BZKDP/dozator-bad/gate12_5servo_direct_esp32/ПЕРВЫЙ_ЗАПУСК_НОВОЙ_СБОРКИ.md

# Дозатор БАДов — первый запуск пяти каналов

## Сигнальные пины ESP32

| Строка | Пин на плате | GPIO | Провод сервы |
|---|---|---:|---|
| Дозатор 1 | D13 | 13 | оранжевый / SIGNAL |
| Дозатор 2 | D14 | 14 | оранжевый / SIGNAL |
| Дозатор 3 | D27 | 27 | оранжевый / SIGNAL |
| Дозатор 4 | D26 | 26 | оранжевый / SIGNAL |
| Дозатор 5 | D25 | 25 | оранжевый / SIGNAL |

D12 пропущен намеренно: это загрузочный пин ESP32.

Красные провода всех серв идут только на `+5 V` понижайки. Коричневые/чёрные
провода идут на общую минусовую WAGO. Между этой минусовой WAGO и `GND` ESP32
обязательно должен оставаться один общий провод. Питание серв нельзя брать с
`3V3`, `VIN` или `5V` ESP32.

## Безопасная последовательность

1. Пока питание серв выключено, подключить пять сигнальных проводов и общую землю.
2. Подключить ESP32 к USB и прошить `gate12_direct5_safe.ino`.
3. Запустить ярлык `Дозатор 5 каналов`.
4. Убедиться, что видны пять строк и у каждой написано `НУЖНА КАЛИБРОВКА`.
5. Включить 5 V серв.
6. В нужной строке нажать `НАСТРОЙКА / КАЛИБРОВКА`.
7. Центрировать серву только со снятой качалкой, затем поставить качалку в HOME.
8. Удержанием кнопок найти HOME и ВЫДАЧУ, запомнить обе точки и проверить цикл
   сначала без банки. Повторить отдельно для остальных строк.

При открытии калибровки выбранного канала приложение снимает сигнал со всех пяти
серв. После каждого движения прошивка автоматически отключает PWM; при зависании
действует сторожевой таймер.
