BZKDP/dozator-bad/gate12_5servo_pca9685/ПОДКЛЮЧЕНИЕ_И_ПОКУПКИ.md

# Дозатор на 5 сервоприводов: ESP32 + PCA9685

Это новая пятиканальная версия прежней схемы. Старая схема сохранена без изменений в соседней папке `gate12_safe_control`: она была рассчитана только на один MG90S, один GPIO и маломощный LM2596.

Новая схема рассчитана на пять обычных трёхпроводных сервоприводов 4,8–6 В (например, SG90/MG90S), постоянно подключённых к одному контроллеру. Компьютер видит ESP32 как COM-порт; ESP32 по I²C управляет отдельным драйвером PCA9685; отдельный блок 5 В питает только сервоприводы.

## Как понимается механика

- **HOME / исходное положение:** длинная крайняя рука полностью опущена и удерживает банку, готовую к выдаче.
- **Ход выдачи:** длинная рука поднимается и выпускает крайнюю банку; связанная с ней изогнутая рука одновременно удерживает следующую банку.
- **Возврат:** длинная рука снова опускается в HOME; следующая банка занимает место для будущей выдачи.

Программа не предполагает, что подъём обязательно соответствует увеличению числа микросекунд. В зависимости от установки качалки он может идти как в сторону `+`, так и в сторону `−`; это определяется отдельно на каждом дозаторе.

## Что купить

Обязательное:

- 1 × ESP32 DevKit V1 / ESP32-WROOM-32.
- 1 × USB-кабель с передачей данных, подходящий к выбранной ESP32.
- 1 × плата PCA9685, 16 каналов, с уже припаянными трёхрядными штырями и винтовой клеммой V+/GND.
- 1 × стабилизированный блок питания **5 В, 5 А (25 Вт)**. Не 12 В. Лучше готовый закрытый сетевой адаптер, а не открытый сетевой модуль.
- 1 × переходник «гнездо DC 5,5×2,1 мм → винтовая клемма», если у блока питания круглый штекер.
- 1 × электролитический конденсатор **1000–2200 мкФ, не ниже 10 В**.
- 4 × провода Dupont «мама–мама» для ESP32 ↔ PCA9685.
- Два коротких силовых провода 0,5–0,75 мм² для 5 В и GND, если они не входят в переходник.

Желательно:

- держатель предохранителя и предохранитель 5 А в плюсовом проводе 5 В;
- выключатель постоянного тока в плюсовом проводе после предохранителя;
- мультиметр для проверки напряжения и полярности до подключения серв.

Если на сервоприводе написано не SG90/MG90S или не указано питание 4,8–6 В, сначала сфотографируй маркировку. Для MG996R и других крупных серв блок питания выбирается отдельно.

## Соединения

| Откуда | Куда | Назначение |
|---|---|---|
| Компьютер USB | USB ESP32 | питание контроллера и COM-порт |
| ESP32 `3V3` | PCA9685 `VCC` | питание только логики PCA9685 |
| ESP32 `GND` | PCA9685 `GND` | общая земля |
| ESP32 `GPIO21` | PCA9685 `SDA` | данные I²C |
| ESP32 `GPIO22` | PCA9685 `SCL` | тактирование I²C |
| Блок 5 В `+` | предохранитель/выключатель → PCA9685 `V+` | силовое питание серв |
| Блок 5 В `−` | PCA9685 `GND` на винтовой клемме | возврат силового питания |
| Конденсатор `+` | PCA9685 `V+` | подавление бросков тока |
| Конденсатор `−` (полоса на корпусе) | PCA9685 `GND` | соблюдать полярность |
| Серва дозатора 1…5 | каналы PCA9685 `0…4` | коричневый/чёрный = GND, красный = V+, жёлтый/оранжевый/белый = PWM |

На большинстве PCA9685 у трёхрядных разъёмов подписано `GND / V+ / PWM` или `- / + / S`. Ориентируйся по надписям именно на своей плате, а не только по положению разъёма на картинке.

## Чего не соединять

- Не подавать 12 В ни на PCA9685 V+, ни на сервы, ни на ESP32.
- Не соединять внешний `+5 В` с `5V/VIN` ESP32, пока ESP32 подключена к USB. Между системами нужна общая **земля**, а не второй плюс питания ESP32.
- Не питать пять серв от вывода `5V`, `VIN` или `3V3` ESP32.
- Не пропускать ток пяти серв через макетную плату или тонкие Dupont-провода. Dupont используются только для четырёх логических соединений.
- Не путать `VCC` и `V+` на PCA9685: `VCC` — 3,3 В логики, `V+` — 5 В серв.

## Первый запуск без риска

1. Пока **не вставлять** разъёмы серв в PCA9685.
2. Собрать четыре логических провода ESP32 ↔ PCA9685.
3. При выключенном блоке подключить его к винтовой клемме PCA9685 и поставить конденсатор, строго соблюдая `+` и `−`.
4. Включить только блок 5 В и мультиметром проверить на клемме PCA9685 примерно 5,0 В и правильную полярность. Выключить блок.
5. Подключить к каналу `0` только первую серву. Банок в механизме быть не должно.
6. Подключить ESP32 к компьютеру, загрузить прошивку и только после этого включить блок серв.
7. Безопасно привязать положение сервопривода к механике по инструкции ниже. Затем по одной добавить сервы в каналы `1`, `2`, `3`, `4`.

Прошивка специально ничего не двигает при включении. Начальные программные пределы — только 1450–1550 мкс; это маленькое безопасное окно вокруг середины. HOME и «выдача» по умолчанию одинаковы — 1500 мкс, поэтому цикл выдачи заблокирован до калибровки.

## Обязательная привязка сервы к уже собранной механике

Трёхпроводная серва не сообщает ESP32 свой фактический угол. Если рука вручную стоит внизу, контроллер всё равно не знает, какой импульс соответствует этому углу. Поэтому нельзя наугад дать 1500 мкс сервоприводу, уже жёстко упёртому механизмом вниз.

Для каждого дозатора по очереди:

1. Убрать банки и выключить питание 5 В.
2. Снять качалку сервы со шлицов либо временно отсоединить тягу, чтобы вал мог повернуться, не двигая руки механизма. Остальную конструкцию разбирать не нужно.
3. Оставить подключённой только эту серву, включить систему и в программе задать HOME = 1500 мкс, затем нажать `В HOME`. Вал безопасно встанет в электрический центр без нагрузки.
4. Выключить питание 5 В. Поставить длинную руку в нижнее HOME-положение **с небольшим запасом до жёсткого упора**, надеть качалку на ближайший шлиц и закрепить тягу.
5. Включить питание. Кнопкой `+20 мкс` сделать один короткий шаг. Если длинная рука начала подниматься — рабочее направление найдено. Если она пытается давить дальше вниз, сразу нажать `СТОП`, вернуть центр и проверить `−20 мкс`.
6. Двигаться в найденную сторону маленькими шагами по 20 мкс, пока длинная рука не поднимется достаточно для выхода одной банки, а изогнутая надёжно не перекроет следующую. Не доводить серву до гудения или механического упора.
7. Записать 1500 мкс как HOME и найденное значение как «Выдача». Если точное HOME потребует небольшой коррекции, менять его шагами и оставить запас от нижнего упора.
8. Только после проверки пустого механизма провести один цикл с одной банкой, затем с двумя. После этого переходить к следующей дорожке.

Если снять качалку или тягу невозможно, первый электрический запуск с жёстко присоединённым механизмом остаётся рискованным: направление и текущий угол сервы неизвестны. В таком случае лучше сначала прислать крупное фото соединения сервы с рукой и маркировки сервы.

## Прошивка ESP32

Файл: `gate12_5servo_pca9685_safe/gate12_5servo_pca9685_safe.ino`.

В Arduino IDE установить:

1. пакет плат `esp32 by Espressif Systems`;
2. библиотеку `Adafruit PWM Servo Driver Library`;
3. выбрать плату `ESP32 Dev Module`, COM-порт ESP32 и нажать Upload.

Здесь прошивка уже проверена сборкой для `esp32:esp32:esp32` с библиотекой PCA9685 версии 3.0.3.

Если удобнее прошивать одной командой, подключить ESP32 и запустить `flash_esp32.ps1`; скрипт попросит номер COM-порта.

## Программа на компьютере

После прошивки:

1. открыть PowerShell в этой папке;
2. один раз выполнить `py -m pip install -r requirements.txt`;
3. запустить `start_app.ps1` или `py gate12_5servo_app.py`;
4. выбрать COM-порт и подключиться.

Нумерация в программе человеческая — дорожки 1…5. В прошивке и на PCA9685 это каналы 0…4 соответственно.

До калибровки не расширять пределы и не запускать все пять механизмов сразу. После калибровки приложение хранит для каждой дорожки отдельные пределы, положения HOME, «выдача» и скорость. Кнопка `СТОП` снимает управляющий сигнал сразу со всех пяти каналов.

## Справочные материалы производителей

- Espressif, ESP32-DevKitC: https://docs.espressif.com/projects/esp-dev-kits/en/latest/esp32/esp32-devkitc/user_guide.html
- Adafruit, подключение PCA9685 и отдельное питание серв: https://learn.adafruit.com/16-channel-pwm-servo-driver/hooking-it-up
- Adafruit, назначение VCC/V+/SDA/SCL: https://learn.adafruit.com/16-channel-pwm-servo-driver/pinouts
- Библиотека Adafruit PWM Servo Driver: https://github.com/adafruit/Adafruit-PWM-Servo-Driver-Library
- TowerPro MG90S: https://towerpro.com.tw/product/mg90s-3/
