BZKDP/dozator-bad/ЧЕРТЁЖ-и-сборка.md

# Дозатор БАД — гравитационный конвейер с серво-шлагбаумами

3D-референс открывается в `index.html` (просто двойной клик — нужен интернет для загрузки three.js).
Здесь — точные размеры, раскрой картона, схема механизма, электроника и прошивка.

---

## 0. Что это и как работает

Это **escapement-механизм** (как в торговых автоматах / диспенсерах Red Bull).
Каждая позиция БАД = **вертикальный магазин**: банки лежат на боку и сложены столбиком
друг на друга. Под силой тяжести столб давит вниз. У низа столба стоят **два серво-шлагбаума
(трап-дверки)** в противофазе — они изолируют и роняют **ровно одну банку за цикл**.

Упавшая банка выходит на **СВОЮ отдельную дорожку** (наклонный лоток). Дорожки всех позиций
идут по отдельности и **сливаются в одну общую магистраль только в самом конце** — там, где
сидит фасовщик.

### Цикл выдачи одной банки (вертикальный магазин)
```
Покой:  G1 закрыт (трап-дверка снизу держит нижнюю банку)
        G2 закрыт (на 1 банку выше, держит весь столб; между G1 и G2 — РОВНО одна банка)

1. G1 открыть (откинуть дверку) → нижняя банка падает на свою дорожку
2. G1 закрыть
3. G2 открыть → столб опускается на один шаг, новая нижняя банка ложится на G1
4. G2 закрыть → снова изолирована одна банка
→ покой
```
Заказ «2 берберина» = цикл повторяется 2 раза на магазине «Берберин».
Заказы по позициям идут последовательно (или параллельно — серво независимы).

---

## 1. Базовая банка (эталон)

| Параметр | Значение |
|---|---|
| Высота (длинная сторона) | **67 мм** |
| Диаметр (дно/крышка) | **47 мм** |
| Ориентация | лежит на боку; ось (длина 67) поперёк дорожки; падает/катится диаметром 47 |

> Если банки другого размера — поменяй два числа `JAR_D` (диаметр) и `JAR_H` (высота)
> в начале `index.html`, остальное пересчитается само (W, DEPTH, шаг, зазоры).

**Зазоры:**
- ширина магазина/дорожки (вдоль оси банки): 67 + 6 = **W = 73 мм**
- глубина магазина (диаметр + зазор): 47 + 6 = **DEPTH = 53 мм**
- шаг банок в столбе (pitch) = 47 + 2 = **49 мм**

---

## 2. Углы и ориентация

| Узел | Угол | Зачем |
|---|---|---|
| Магазин хранения | **вертикальный (90°)** | банки лежат на боку столбиком, падают вниз самотёком |
| Дорожка позиции | **15–18° от горизонта** | банка скатывается к фасовщику, но не разгоняется |
| Финальное слияние | **10–12°** | плавный докат в общий лоток |

Дорожка менее 12° — банка может застрять (особенно с этикеткой). Более 25° — разгон и удары.

---

## 3. Геометрия escapement (САМОЕ ВАЖНОЕ)

Низ вертикального магазина. Две трап-дверки (шлагбаума) поперёк столба, по высоте между ними
= **один диаметр банки = 47 мм** (по центрам).

```
     вертикальный магазин (банки лёжа, столбиком), вид сбоку
        ┌───────────┐
        │   ● банка  │   ← загрузка сверху
        │   ● банка  │   ← передняя стенка держит столб
        │   ● банка  │
        │   ● банка  │
        └──┐      ┌──┘   ← низ колонны, банка падает на гориз. участок
           │  ▲   ▲      ← ДВЕ ПОДЪЁМНЫЕ ЗАСЛОНКИ, обе ходят ВВЕРХ
        ───┤  G2  G1 ├──────►  к фасовщику
           │  ●(одна банка между ними)
   нижний горизонтальный лоток    |← 47 мм →|  (шаг G1↔G2 = 1 диаметр)
```

Оба шлагбаума — **подъёмные заслонки** (вертикальные пластины поперёк лотка, ходят ВВЕРХ,
как шлагбаум-боом). Стоят на нижнем горизонтальном участке, между ними помещается ровно
одна банка.

- **G1 — главный** (ближний к фасовщику). Поднимается вверх → банка с участка уходит на
  свою дорожку к фасовщику. Опускается → держит следующую.
- **G2 — придержка** (дальняя, у выхода из колонны), на 47 мм позади G1. Поднимается вверх →
  нижняя банка из колонны въезжает на участок (на место ушедшей). Опускается → держит столб.
- Заслонка: жёсткая пластина (ПЭТ/фанера/плотный картон) **1.5–3 мм** на всю ширину лотка,
  ходит в направляющих-пазах вверх-вниз. Серво наверху тянет её за тягу/рычаг.
- Низ магазина: **дно** колонны + **передняя стенка** выше выхода (держит столб) + нижний
  **горизонтальный лоток** с заслонками (как в примере BURN).

**Цикл (обе заслонки ВВЕРХ):** G1 вверх → банка ушла к фасовщику → G1 вниз →
G2 вверх → следующая банка въехала на участок → G2 вниз → столб опустился → готово.
(Никогда не открыты обе сразу — поэтому за цикл проходит РОВНО одна банка.)

---

## 4. Раскрой картона (архитектурный, толщина ≈ 2–3 мм)

Размеры даны для **одной позиции**, магазин на **~10 банок** (высота столба = 10 × 49 ≈ 490 мм).
Выше магазин = больше запас (масштабируется свободно).

**Вертикальный магазин (1 шт на позицию):**

| № | Деталь | Размер, мм | Кол-во | Примечание |
|---|---|---|---|---|
| A | Задняя стенка | 550 × 73 | 1 | высота столба + запас; ширина = W |
| B | Боковая стенка | 550 × 53 | 2 | глубина = DEPTH (47 + зазор) |
| C | Передняя стенка | 550 × 73 | 1 | можно с окном-прорезью, видеть остаток |
| D | Приёмная воронка сверху | 90 × 70 (×2 ската) | 2 | удобно засыпать банки |

**Прорези/оси под дверки в боковой стенке B (от низа магазина):**
- ось G1 (нижняя дверка): на высоте **25 мм** от дна столба
- ось G2 (верхняя дверка): на **47 мм выше G1** = ~72 мм от дна
- дверки G1/G2: пластина **73 × 53 мм**, толщина 1.5–3 мм (на всю ширину×глубину)

**Дорожка позиции (своя, 1 шт на позицию):**

| Деталь | Размер, мм | Кол-во | Примечание |
|---|---|---|---|
| Дно дорожки | 250 × 73 | 1 | наклон 15° от магазина вперёд |
| Бортики | 250 × 25 | 2 | держат банку на дорожке |
| Сходящийся участок | трапеция, к концу сводит к центру | 1 | поворачивает дорожку к общей точке |

**Общая магистраль (ОДНА, только в самом конце):**

| Деталь | Размер, мм | Кол-во |
|---|---|---|
| Дно финального лотка | 200 × 100 | 1 (наклон 10–12°) |
| Бортики | 200 × 30 | 2 |
| Лоток фасовщика | 120 × 100, борт 30 | 1 |

> Сборка: клеевой пистолет + малярный скотч по рёбрам, углы держать картонными
> косынками. Дно дорожек проклеить в 2 слоя — по ним ездят банки.
> Кронштейны серво — приклеить/прикрутить к боковой стенке снаружи у осей G1 и G2.

---

## 5. Компоновка: свои дорожки → слияние в конце

```
   [Берберин]   [Мемон]   [Магний B6]     ← 3 ВЕРТИКАЛЬНЫХ магазина рядом, шаг ~90 мм
       │            │           │           (банки лёжа, столбиком; внизу G1/G2)
       │ своя       │ своя      │ своя
       │ дорожка    │ дорожка   │ дорожка   ← каждая ИДЁТ ОТДЕЛЬНО (наклон 15°)
        \           │          /
         \          │         /            ← сходящиеся участки
          \_________│________/
                    ▼
              общая магистраль             ← сливаются в ОДНУ только здесь
                    │  (10°)
               [ФАСОВЩИК]                   ← один лоток, человек забирает банки
```

Банки во всех дорожках катятся в одном направлении (ось поперёк хода) — на слиянии
направление не меняется, бортики центрируют. Слияние «3 в 1» гравитацией надёжно
до **~5–6 дорожек** на одну магистраль (дальше — несколько лотков или лента).

---

## 6. Масштабирование до 80 позиций

Модуль «канал + escapement» — **самодостаточный и одинаковый**. Масштаб = повторить модуль.

1. **Сетка модулей.** Ставь каналы в стойку рядами (как проволочный стеллаж на фото):
   например 10 каналов в ряд × 8 ярусов = 80. Шаг по ширине 90 мм, по высоте ~120 мм.
2. **Группировка магистралей.** Одна гравитационная магистраль тянет ~5–6 каналов.
   На 80 позиций → ~13–16 магистралей. Варианты финала:
   - несколько лотков-сборников (фасовщик берёт из нужного),
   - **ИЛИ** общий ленточный транспортёр внизу как «главная магистраль» (мотор-редуктор),
     в него сбрасывают все магистрали — тогда всё стекается в одну точку.
3. **Электроника масштабируется линейно** (см. ниже): PCA9685 по 16 серво,
   до 62 плат на одной шине I²C = **992 серво** = 496 каналов. ESP32 один.

---

## 7. Электроника

| Что | Сколько | Назначение |
|---|---|---|
| ESP32 (DevKit) | 1 | мозг, USB к ПК + Wi-Fi |
| PCA9685 (16-кан. ШИМ драйвер) | 1 на 8 каналов | управление серво по I²C |
| Серво **выходной G1** | 1/канал | SG90/MG90S — лёгкая нагрузка, ок |
| Серво **придержка G2** | 1/канал | **MG90S или MG996R** — держит колонну, нужен момент |
| БП 5–6 В | 1 | питание серво (НЕ от USB!), 1 А на ~8 серво |

**Подключение PCA9685 ↔ ESP32 (I²C):**
```
PCA9685 VCC  → ESP32 3V3   (логика платы)
PCA9685 GND  → ESP32 GND   (общая земля — ОБЯЗАТЕЛЬНО)
PCA9685 SDA  → ESP32 GPIO21
PCA9685 SCL  → ESP32 GPIO22
PCA9685 V+   → внешний БП 5–6 В (+)   ← питание серво
PCA9685 GND  → внешний БП (–)         ← и сюда же земля ESP32
```
Каждый канал n: G1 = выход PCA `2*n`, G2 = выход `2*n+1`.
Несколько плат: перемычки адреса A0..A5, адреса 0x40, 0x41, … передаются в прошивке.

> ⚠ Серво питать ТОЛЬКО от внешнего БП. От 5 В USB ESP32 они просядут и ESP32 ребутнётся.
> Земли ESP32, PCA9685 и БП соединить вместе.

---

## 8. Файлы проекта

| Файл | Что |
|---|---|
| `index.html` | интерактивный 3D-референс (крути, задай заказ, смотри цикл) |
| `ЧЕРТЁЖ-и-сборка.md` | этот документ |
| `esp32_dispenser.ino` | прошивка ESP32 (серая логика escapement + приём команд) |
| `dispenser_pc.py` | программа для ПК: выбираешь количество → шлёт в ESP32 |

### Углы серво (калибруются под твою сборку)
В прошивке для каждого шлагбаума два положения: `CLOSED` и `OPEN` (в микросекундах).
Подбери на месте так, чтобы лезвие в CLOSED чётко перекрывало канал, в OPEN — полностью убиралось.

---

## 9. Сборка по шагам

1. Вырезать детали A–D, собрать вертикальный магазин: задняя + 2 боковые + передняя стенка
   (перёд можно с окном). Получается «шахта» 73 × 53 мм в сечении.
2. Прорезать в боковой стенке оси/щели под дверки G1 (25 мм) и G2 (72 мм от дна).
3. Поставить 2 серво снаружи на кронштейны, дверки G1/G2 — внутрь шахты.
4. Проверить механику ВРУЧНУЮ: одна банка изолируется между G1 и G2 и падает на дорожку.
5. Пристыковать СВОЮ дорожку (наклон 15°) к низу магазина.
6. Повторить ×3, свести три дорожки сходящимися участками в ОДНУ магистраль → лоток.
7. Электроника: ESP32 + PCA9685 + БП, подключить серво по карте каналов.
8. Прошить ESP32, откалибровать углы CLOSED/OPEN каждого серво.
9. Запустить `dispenser_pc.py`, выбрать заказ, проверить выдачу.

Сначала собери и отладь **один магазин** — поймаешь все нюансы дверок и веса столба,
потом тиражируй.
