BZKDP/dozator-bad/v10_производственная_модель/README_СБОРКА_ПЕЧАТЬ_И_ПРОВЕРКА.md

# V10 — пятиканальный дозатор банок 70×Ø47

## Что это за конструкция

V10 — полностью новая ветка проекта. Старые файлы не изменены.

В каждом из пяти каналов работает **одна уже купленная SG90 или MG90S**. Серва вращает не абстрактный шлюз, а печатный двухпазовый кулачок. Два паза принудительно двигают две вертикальные заслонки:

1. Передняя заслонка удерживает первую банку.
2. Задний сепаратор входит между первой и второй банками.
3. Некоторое время обе заслонки закрыты.
4. Передняя заслонка уходит ниже дорожки, и выходит ровно первая банка.
5. При обратном ходе сначала закрывается передняя заслонка, затем освобождается очередь.

Нагрузка от очереди банок воспринимается боковыми направляющими. Вал сервы задаёт положение кулачка, но не служит опорой для веса банок.

Номинальный ход сервы HOME → EJECT — 84°. Фазы кулачка:

- 0–34° — поднимается задний сепаратор, передняя заслонка закрыта;
- 34–42° — обе заслонки закрыты;
- 42–76° — опускается передняя заслонка, задняя закрыта;
- 76–84° — выдержка выдачи.

Это **производственно ориентированный прототип**, а не обещание без испытаний. Геометрия проверена программно, но до печати пяти комплектов один физический канал обязан пройти протокол из раздела «Приёмка».

## Кассета — ровно шесть больших листов

Клей для кассеты не нужен. Больших листов ровно шесть:

| Код | Количество | Размер | Назначение |
|---|---:|---:|---|
| A01 | 4 | 590×390×4 мм | Цельные вертикальные разделители пяти каналов |
| A02 | 1 | 569,40×391×4 мм | Нижний цельный скат, 15° |
| A03 | 1 | 551,38×391×4 мм | Верхний цельный скат, 14° |

В каждом разделителе два встречных паза. Верхний открыт со стороны передней кромки и заканчивается за 55 мм до задней. Нижний открыт сзади и заканчивается за 40 мм до передней кромки. Поэтому разделитель остаётся одной цельной деталью.

Ширина паза:

- для CNC: фактическая толщина листа +0,25 мм;
- для ручного реза: фактическая толщина листа +0,45 мм.

Перед раскроем измерить толщину фанеры штангенциркулем минимум в пяти местах. Надпись «4 мм» у продавца не гарантирует фактические 4,00 мм.

Порядок сборки кассеты:

1. Поставить четыре разделителя с центрами 77, 156, 235 и 314 мм от левого края кассеты.
2. Нижний цельный лист задвинуть **сзади вперёд** до закрытых концов нижних пазов.
3. Верхний цельный лист задвинуть **спереди назад** до закрытых концов верхних пазов.
4. Поставить восемь малых печатных X-замков A04 на открытые входы пазов.
5. Целиком вставить шестилистовую кассету в коробку.

Точные файлы раскроя находятся в папке `РАСКРОЙ_6_ЛИСТОВ`. DXF с пометкой `CNC` использует зазор 0,25 мм, DXF с пометкой `РУЧНОЙ` — 0,45 мм. SVG выполнены в масштабе 1:1 и в миллиметрах.

## Что печатать сначала

Не запускайте сразу пять комплектов. Правильная последовательность экономит пластик и время:

1. Напечатать T01 — купон направляющей. Проверить заслонку в трёх зазорах 4,35 / 4,55 / 4,75 мм. Она должна свободно проходить под собственным весом без заметного поперечного люфта.
2. Напечатать T02 — купон штатной качалки. Выбрать карман +0,20 / +0,35 / +0,50 мм, в который комплектная двойная качалка входит плотно, но без раскалывания детали.
3. Напечатать детали **одного канала**: M01–M09.
4. Собрать и провести не меньше 300 циклов.
5. Только после успешной приёмки тиражировать ещё четыре комплекта.

Для первого канала подготовлены два файла 3MF под стол 220×220 мм:

- `3MF_01_ОДИН_КАНАЛ_СТОЛ_A.3mf`;
- `3MF_02_ОДИН_КАНАЛ_СТОЛ_B_И_КУПОНЫ.3mf`.

3MF содержит геометрию и раскладку, но не заменяет профиль вашего пластика и принтера. Проверить все параметры в слайсере перед запуском.

## Параметры печати

Базовый материал — PETG. Для M09 допустим PETG, лучше PA/нейлон при наличии стабильной печати.

- сопло 0,4 мм;
- слой 0,20 мм;
- 5 стенок и 5 верхних/нижних слоёв;
- 35–40% gyroid;
- для M03, M04 и M05 — 6 стенок;
- компенсация «слоновьей ноги» 0,20–0,25 мм;
- шов не размещать на скользящих поверхностях заслонок;
- M02 — локальные поддержки только под четыре стойки крышки;
- M08 — печатать боковой плоскостью с brim 5 мм;
- M05 — плоско, карманом штатной качалки вверх;
- M09 — фланцем на стол.

Все 13 STL в `STL_ПЕЧАТЬ` уже экспортированы в рекомендуемой ориентации. Объединённые файлы из `STL_СБОРКА_НЕ_ПЕЧАТАТЬ` предназначены только для просмотра и проверки, печатать их нельзя.

## Сборка одного канала

1. Вставить две латунные термовставки M3 OD 4,6×5 в боковые бобышки заслонок M03 и M04.
2. Установить по одному ролику M07 на винт M3×12 с низкой головкой. Максимальный диаметр головки — 6 мм. Ролик должен вращаться свободно; резьбовой фиксатор наносить только на резьбу, не на ролик.
3. Ввести заслонки в соответствующие двусторонние направляющие M02. Оранжевая передняя заслонка стоит у выхода, бирюзовый задний сепаратор — на 50 мм выше по дорожке.
4. Прикрутить раму M02 под лоток M01 четырьмя M3. Поставить съёмный входной мост M08 двумя M3.
5. Установить SG90/MG90S в реальное посадочное место рамы. Серва крепится через уши двумя M2×10/12 с гайками; не затягивать до деформации пластиковых ушей.
6. Снять тяги и качалку. Подать питание, программно выставить 1500 мкс, снять сигнал и питание. Не проворачивать вал сервы рукой.
7. Вставить **штатную двойную качалку сервы** в выбранный по T02 карман M05. Печатных шлицов в конструкции нет. Закрепить качалку штатным центральным винтом через сквозной сервисный канал.
8. При положении HOME совместить отверстие блокировки и временно вставить штифт M3×20. Только после этого соединить кулачок с заслонками роликами.
9. Вставить M09 в центральное отверстие крышки M06, затем установить крышку четырьмя M3. Втулка является второй радиальной опорой кулачка и одновременно оставляет доступ к центральному винту качалки.
10. Вынуть HOME-штифт. Медленно проверить ручным ползунком программы 0–84° без банок, затем с одной банкой.

Серва получает питание от отдельной линии 5 В. Земля блока питания серв и GND ESP32 должны быть общими. Пять серв не питать от 5V/3V3 платы ESP32.

## Установка относительно коробки

Картон и кассета направляют банки, но **не несут пять механизмов**. Все пять M01 крепятся к одному алюминиевому профилю 2040. Профиль опирается на два печатных клина B01 и две стальные полочные консоли, закреплённые на жёстком подиуме. Опоры вынесены за левый и правый край коробки, поэтому не пересекаются с первым и пятым каналом.

Входной мост M08 заходит внутрь канала, подхватывает переднюю кромку нижнего фанерного ската снизу и создаёт ровный переход к печатному лотку. Сам привод, серва и обе заслонки находятся снаружи четырёх разделителей и остаются съёмными.

Четыре продольных паза M01 дают регулировку каждого канала на ±6 мм относительно уже прорезанного окна. Использовать винты M4 с потайной головкой; головка обязана находиться заподлицо или ниже дорожки, иначе банка будет цепляться.

## Начальная калибровка

Номинально старая калибровка давала примерно 84° движения. Не копировать конечный импульс вслепую на новый механизм.

1. Механизм без банок, HOME-штифт снят.
2. Начать с 1500 мкс.
3. Двигать микрошагами только до геометрического HOME, не упирая серву в печатный ограничитель.
4. Запомнить HOME.
5. Медленно двигать к EJECT и остановиться за 1–2° до механического конца паза.
6. Запомнить EJECT.
7. Сначала провести десять циклов без банок на минимальной скорости.
8. Затем одна банка, две банки и полная очередь.

При снятии управляющего PWM кулачок не должен самопроизвольно раздавать банку: давление очереди воспринимается направляющими поперёк движения заслонки. Тем не менее после каждого включения программа сначала должна подключиться к серве в известном HOME, а не посылать случайный импульс.

## Приёмка перед печатью пяти комплектов

Проверять самую тяжёлую и самую лёгкую банку, а также банки с наиболее выступающим швом этикетки.

| Режим | Циклов | Критерий |
|---|---:|---|
| Одна банка | 50 | 50 выдач, без пропуска |
| Две банки | 50 | Только первая банка за цикл |
| Полная очередь | 150 | Ноль двойных выдач и закусываний |
| Последняя банка | 50 | Ноль зависаний последней банки |

Итого минимум 300 циклов. Приёмка пройдена только при нуле двойных выдач, нуле пропусков и нуле закусываний. Скорость сервы подбирать после геометрической приёмки; уменьшение скорости не должно использоваться как маскировка неправильного положения заслонки.

## Что измерить перед заказом окончательного раскроя

Зафиксировать в миллиметрах:

- максимальный диаметр, длину и массу минимум десяти реальных банок;
- фактическую толщину каждого листа;
- внутреннюю ширину, глубину и высоту конкретной коробки;
- реальные размеры корпуса и качалки именно вашей партии SG90/MG90S;
- координаты и размеры уже вырезанного выходного окна.

Модель сейчас рассчитана на банку длиной 70 мм, номинальным диаметром 47 мм и контрольным габаритом Ø48 мм; кассету 391×590×390 мм; чистую ширину канала 75 мм; шаг каналов 79 мм.

## Состав папки

- `ОТКРОЙ_V10_ПРОФЕССИОНАЛЬНАЯ_3D.html` — интерактивная сборка, фазы движения и раскладка печати;
- `STL_ПЕЧАТЬ` — 13 печатных STL;
- `STL_СБОРКА_НЕ_ПЕЧАТАТЬ` — детали в сборочных координатах и контрольные состояния;
- `РАСКРОЙ_6_ЛИСТОВ` — DXF/SVG шести больших листов;
- два файла 3MF — первый комплект на двух столах 220×220;
- `BOM_МАТЕРИАЛЫ_И_КРЕПЕЖ.csv` — материалы и крепёж;
- `КАРТА_ПЕЧАТИ.csv` — количество, ориентация и поддержки;
- `V10_MANIFEST.json` — размеры, состав и результаты геометрического экспорта;
- `make_v10.py` — параметрический генератор всей ветки V10.
