BZKDP/dozator-bad/v11_три_варианта/00_ТЕХЗАДАНИЕ_V11.md

# V11 — три простых механизма для коробки со свесом

## Реальная установка

- На каждом уровне стеллажа стоят две коробки.
- Задняя часть коробки опирается на полку, передняя часть с окном выдачи выступает перед полкой.
- Отдельный подиум, напольная стойка и общая металлическая балка не используются.
- Механизм крепится к передней части съёмной кассеты или к зоне выходного окна и находится в свободном объёме переднего свеса.
- Глубина полки и величина свеса пока остаются параметрами. Для текущей визуализации применяется номинальный свес 200 мм, а не фиксированное требование к мебели.
- Устойчивость полностью загруженной коробки проверяется отдельно на реальном стеллаже. Если задняя часть разгружается при усилии на зоне выдачи, коробке нужен непечатный задний упор или страховочный ремень к стеллажу.
- Допустимая нагрузка проверяется для каждой полки и всего стеллажа с учётом двух коробок, банок, шести листов, пяти механизмов и момента от переднего свеса. Стеллаж выставляется и закрепляется по инструкции его производителя; упор или ремень коробки не заменяет крепление стеллажа.
- Движущаяся зона каждого дозатора закрывается съёмным защитным кожухом. Доступ к ножам, коромыслу, ротору и серве допускается только на обесточенном и разгруженном канале.

## Неизменяемые исходные данные

- пять каналов;
- чистая ширина канала 75 мм, шаг каналов 79 мм;
- банка длиной 70 мм, номинальным диаметром 47 мм; проверочный габарит — Ø48 мм;
- нижний скат 15°;
- ровно шесть больших листов кассеты: четыре разделителя и два цельных наклонных листа;
- соединение шести листов без клея фиксируется восемью одинаковыми печатными внутренними фиксаторами: формовой штифт Ø3,8 входит в отверстие ската Ø4,2, а один поперечный M4×25 с двумя широкими шайбами M4 DIN 9021 Ø12 мм и самоконтрящейся гайкой связывает фиксатор с разделителем; широкая опорная плоскость блокирует поворот;
- на каждый канал — одна уже купленная SG90 или MG90S со штатной качалкой;
- доступный калибровочный ход HOME–EJECT около 84°;
- стол принтера 220×220 мм.

## Главный приоритет

Побеждает не самый эффектный механизм, а тот, который:

1. печатается без поддержек или с одной очевидной локальной поддержкой;
2. содержит минимум отдельных печатных деталей;
3. собирается штатной качалкой, одной осью и несколькими одинаковыми винтами;
4. ставится на кассету одинаковым движением во всех пяти каналах;
5. не требует ловить соосность нескольких тяг и не требует индивидуальной ручной подгонки после калибровочного купона;
6. если пассивное удержание при отключении питания задано как обязательное, не выпускает банку самопроизвольно;
7. позволяет снять один канал, не разбирая остальные четыре и не расклеивая коробку.

Критерий 6 является жёстким фильтром только там, где пассивное удержание при исчезновении питания обязательно: в таком режиме B — единственный расчётный кандидат. Его нельзя называть доказанно fail-safe до физических power-cut тестов при пустой, частичной и полной очереди, в HOME и в переходном состоянии. Если допустимо управляемое удержание с непрерывно корректным PWM и безопасной последовательностью пуска/останова, то по приоритетам одной плиты Ender-3 и минимальной сборки первым испытывается C с MG90S; A и C при потере питания загруженной очереди безопасными не считаются.

Для каждого варианта обязательно указываются: число печатных деталей, число крепежей, поддержки, операции сборки, операции установки, доступ к серве, движение банки и честные риски.

Предпочтительный общий интерфейс установки: модуль надевается на переднюю кромку нижнего листа кассеты (`cassette_lower_sheet.stl`) и поджимается снизу двумя одинаковыми винтами, без сверления дорожки. Четыре внутренних разделителя могут центрировать модули, но не являются единственной несущей опорой: у пяти каналов нет шести фанерных боковин.

Операции для всех трёх вариантов считаются одинаково: одна макрооперация — один осознанный этап с единым результатом. Парные одинаковые элементы, устанавливаемые или затягиваемые в рамках такого этапа (например, два винта сервы, две оси/гайки или два нижних винта), считаются одной сгруппированной макрооперацией; электропроводка пяти серв считается отдельно.

Текущее приложение прежнего рычажного дозатора не совместимо с кинематикой V11 до появления отдельных профилей. Для A и C профиль обязан задавать индивидуальные HOME/EJECT, направление, ограниченную скорость, ускорение, выдержки и безопасный запуск с непрерывным валидным PWM. Загружать A/C до такой доработки ПО запрещено. B требует собственного короткого профиля UNLOCK/HOME и отдельных испытаний отключения питания.

## Три варианта

### A — верхнее коромысло

Одна V-образная качалка с двумя округлыми пальцами. Четырёхзвенник преобразует 83,70° сервы в ход коромысла −22…+22°. Комплект из четырёх деталей печатается одной готовой плитой без поддержек. Установка: надвинуть модуль и затянуть два винта. Расчётно допустимы 22 банки по 100 г или 12 по 200 г, но физическая приёмка обязательна; механизм не самотормозится и под нагрузкой требует непрерывного корректного PWM.

### B — гравитационно индексируемая звёздочка

Четырёхкарманный ротор вращает сама банка под действием уклона, а SG90/MG90S только кратко поднимает гравитационную собачку. По замыслу в HOME очередь механически удерживают ротор, отдельная M4-ось, собачка и сборная рама — вал сервы не является тормозом. Девять рабочих деталей и разовый купон занимают пять готовых плит; сборка одного канала насчитывает 12 первичных и 2 установочные сгруппированные операции. Самофиксация пока номинальная, а не доказанная: последняя банка, усилие страгивания и отключение питания во всех состояниях требуют физических тестов.

### C — верхние линейные ножи

Две полноширинные линейные заслонки встречным ходом от одного коромысла. На середине хода обе перекрывают дорожку, поэтому очередь не получает сквозного окна. Пять рабочих деталей и один купон помещаются на одной готовой плите без поддержек; плоский кронштейн сервы отделён от рамы ради чистой FDM-печати и крепится двумя винтами одной операцией. Установка состоит из надвигания рамы и затяжки двух винтов. Ход сервы ровно 84°. Полная заявленная очередь до 22×100 г или 11×200 г допускается только с MG90S после измерения пикового усилия и 300/300 циклов; SG90 разрешён лишь для уменьшенной опытной очереди с физически установленным пределом. Режим 22×200 г запрещён для обеих серв. PWM должен непрерывно оставаться активным.

## Статус

V11 — сравнительные полноразмерные прототипы, а не готовые серийные или сертифицированные устройства. Геометрия проверена по фактическим STL общего нижнего листа и четырёх необрезанных разделителей во всех пяти позициях. Это не заменяет физическую приёмку: после выбора сначала печатается один канал, ставится защитный кожух и проводится 300 циклов с фактической очередью, включая power-cut проверки для заявлений о пассивном удержании. Только после 300/300 одиночных выдач и отсутствия самопроизвольного движения печатаются ещё четыре комплекта.
