BZKDP/dozator-bad/v11_три_варианта/README_СНАЧАЛА_V11.md

# V11 — с чего начать

Сделаны три **разных** механизма под одну уже купленную SG90/MG90S на канал. Все ставятся на тот же съёмный нижний скат: надвинуть собранный модуль на переднюю кромку и затянуть два винта снизу. Под конкретный дозатор готовые листы дополнительно сверлить, клеить или подрезать не нужно. Но саму общую кассету следует резать только по финальному раскрою V11: в каждом разделителе уже предусмотрены два отверстия Ø4,4 мм, а в каждом скате — четыре отверстия Ø4,2 мм. Шесть листов удерживают восемь одинаковых внутренних фиксаторов: формовой штифт входит в скат, а один поперечный M4×25 с двумя **широкими шайбами M4 DIN 9021 Ø12 мм** и самоконтрящейся гайкой крепит фиксатор к разделителю. Обычная узкая шайба со стороны PETG для этого открытого седла не подходит.

Номинальный свес коробки 200 мм в просмотрщике нужен только для компоновки. До загрузки восьми коробок обязательно проверить устойчивость одной полностью загруженной коробки на реальной полке, допустимую нагрузку каждой полки и всего стеллажа с учётом двух коробок, содержимого, кассет и механизмов. Стеллаж должен быть выставлен и закреплён по инструкции производителя. При намёке на отрыв задней части коробки поставить жёсткий задний упор или страховочный ремень; это не заменяет крепление самого стеллажа.

Перед эксплуатацией закрыть зону ножей, коромысла, ротора и серв съёмным защитным кожухом. Снимать кожух можно только для обслуживания обесточенного и разгруженного канала. Ни один вариант V11 пока не является серийным или доказанно безопасным устройством.

## Условный выбор по вашему главному критерию

**Если главное — одна плита Ender‑3 и минимум сборки, сначала печатать один канал C с MG90S.** Он не требует поддержек, собирается за шесть первичных и две установочные макрооперации, а два полноширинных ножа терпимее к небольшому перекосу банки, чем тонкие пальцы A. Плоский кронштейн сервы сделан отдельной пятой деталью: это одно дополнительное затягивание пары винтов, зато рама и кронштейн реально печатаются без висящих мостов. Это условная рекомендация: под загруженной очередью C требует непрерывно корректный PWM и описанную ниже безопасную последовательность пуска и останова.

Полная заявленная для C очередь — до 22 банок по 100 г либо до 11 банок по 200 г — допускается только с MG90S и только после измерения пикового усилия и успешных 300/300 циклов на настоящих банках. SG90 считать приводом для уменьшенной опытной очереди; её предел устанавливается физическим тестом, а не таблицей расчёта. Для полной очереди 22×200 г C не допускается ни с одной из этих серв. **Если пассивное удержание при отключении питания — жёсткое требование, единственный кандидат из трёх — B, но его нельзя считать доказанно fail-safe до физических тестов отключения питания.**

Если ваши полные банки весят около 200 г и в дорожке реально находятся все 22 штуки, единственный из этих трёх расчётный кандидат — B. По замыслу он самофиксируется в HOME без нагрузки на вал сервы, но это ещё не доказанная защита при отказе. До применения обязательны power-cut тесты при пустой, частичной и полной очереди, в HOME и в переходном состоянии. Цена такого решения — пять запусков принтера, девять рабочих деталей и 12 первичных плюс 2 установочные макрооперации.

A имеет смысл как самый лёгкий и дешёвый опытный образец: одна плита, четыре детали, минимум пластика. Для высокой A01 нужен brim 4 мм, поддержки не нужны. Для 22×100 г расчёт проходит, для 200-граммовых банок строгий предел — 12 штук. По устойчивости к перекосу он уступает широким ножам C. A также не самотормозится и требует непрерывного корректного PWM под нагрузкой.

## Сравнение одного канала

| Вариант | Рабочие печатные детали | Готовые плиты | Поддержки | Первичная сборка + установка | Удержание без PWM | Расчётное ограничение |
|---|---:|---:|---:|---:|---:|---|
| A — V-коромысло | 4 | 1 | нет | 6 + 2 действия | нет | 22×100 г или 12×200 г |
| B — звёздочка с собачкой | 9 + разовый купон | 5 | нет | 12 + 2 действия | номинально в HOME; не принято до power-cut теста | физически проверить страгивание и последнюю банку |
| **C — два линейных ножа** | **5 + разовый купон** | **1** | **нет** | **6 + 2 действия** | нет | полная заявленная очередь — только MG90S после теста; SG90 ограничен; 22×200 г запрещено |

«Проходит расчёт» не означает готовность к пяти каналам: трение, удары, геометрия конкретных банок и разброс клонов серв в расчёт не входят.

Правило сравнения едино для A/B/C: одна макрооперация — один осознанный этап с единым результатом. Парные одинаковые элементы, устанавливаемые или затягиваемые в рамках такого этапа (например, два винта сервы, две оси/гайки или два нижних винта), считаются одной сгруппированной макрооперацией; электропроводка пяти серв считается отдельно.

## Что открывать в слайсере

- Сначала общие 8 одинаковых фиксаторов шести листов: `00_ОБЩАЯ_КОМПОНОВКА/PLATES_3MF/КАССЕТА_8_ВНУТРЕННИХ_ФИКСАТОРОВ_220x220.3mf` — supports OFF, brim 5 мм. Верх/низ отличаются только способом установки одной универсальной детали.
- C, рекомендуемый первый прототип: `C_верхние_линейные_ножи/STL_ПЕЧАТЬ/C2_ПЛИТА_1_КАНАЛ_готовая_220x220.3mf`.
- A: `A_верхнее_коромысло/A_ПЛИТА_220x220_1_канал.3mf`.
- B: пять файлов по порядку из `B_роторная_кассета/PLATES_3MF`.

В готовых 3MF ориентация и разнос уже сохранены. Масштаб 100%, supports OFF. Для A установить brim 4 мм; для B на плите 02 также обязателен brim 4 мм. Для C brim обычно выключен, но при короблении PETG допустим не более 2 мм.

Купон внутри C/B является отдельным объектом. Самый безопасный порядок: в первом запуске включить только купон, выбрать посадку, затем снова открыть тот же 3MF и печатать рабочие объекты. Если посадка уже проверена на этом пластике и этой партии серв, можно печатать всю готовую плиту сразу.

Базовые настройки для PETG: сопло 0,4 мм, слой 0,20 мм, четыре периметра и пять верхних/нижних слоёв. Заполнение: A — 40% (допустимый диапазон его инструкции 35–45%), B и C — 30%; для общих восьми фиксаторов кассеты действует отдельный профиль — пять стенок и 40%. Температуру и обдув брать из уже проверенного профиля конкретного филамента; G-code заранее не создан, потому что он зависит от вашего принтера, сопла и пластика.

## Программное обеспечение и питание

Текущее приложение, откалиброванное для прежнего рычажного дозатора, **несовместимо с кинематикой V11 до добавления отдельных профилей**. Им нельзя двигать загруженные A или C. Для каждого варианта и канала сначала нужны собственные HOME/EJECT, направление, безопасная скорость, ускорение, выдержки и поведение при запуске/потере связи. A и C должны получать непрерывный валидный PWM во всех нагруженных состояниях; сначала запускается ESP32 и задаётся HOME, затем включается питание серв и только потом загружаются банки. Перед снятием питания канал переводится в HOME и полностью разгружается.

B требует отдельного короткого профиля UNLOCK/HOME. Его номинальная механическая фиксация не разрешает эксплуатацию без проверки реальным отключением питания во всех опасных состояниях.

## До печати остальных четырёх

1. Взвесить самую тяжёлую полную банку и посчитать реальное максимальное число банок в одной дорожке.
2. Напечатать только один канал выбранного варианта.
3. Собрать шестилистовую кассету со всеми восемью внутренними фиксаторами, затем установить канал без подпиливания рабочей геометрии и без дополнительных изменений листов.
4. Установить защитный кожух и выполнить [протокол 300 циклов](ПРОТОКОЛ_300_ЦИКЛОВ.md), включая проверки отключения питания там, где заявляется пассивное удержание.
5. Только при 300/300 одиночных выдач печатать ещё четыре комплекта.

Подробные инструкции находятся в папках вариантов. Интерактивная модель открывается через `ОТКРЫТЬ_V11.cmd`; режим «Столы 220×220» показывает именно расположение объектов из готовых 3MF, а не условную раскладку.
