BZKDP/dozator-bad/v11_три_варианта/КРАТКОЕ_ОПИСАНИЕ_ДЛЯ_АНАЛИЗА_A.md

# Краткое описание варианта A для независимого анализа

Файл `АНИМАЦИЯ_A_ПЛАВНАЯ.html` показывает один из пяти одинаковых каналов автоматического дозатора банок с БАДами. Коробка устанавливается на полку стеллажа и частично выступает вперёд. Банки лежат на боку и под действием силы тяжести катятся по наклонным листам. Задача механизма — по команде выдавать строго одну банку выбранного вида, одновременно удерживая следующую.

## Исходная геометрия

- Фактический номинал банки из ранних замеров: длина 67 мм, диаметр 47 мм.
- Расчётный габарит V11 с запасом на крышку, дно, этикетку и разброс: 70×Ø48 мм.
- Масса банки пока не зафиксирована одним значением; в расчётах проверялись 50, 100 и 200 г.
- Ориентировочный внутренний размер коробки: 595×395×395 мм.
- Пять параллельных каналов: чистая ширина каждого 75 мм, шаг между осями 79 мм.
- Съёмная кассета состоит из шести листов толщиной 4 мм: четырёх разделителей 590×390 мм и двух цельных скатов.
- Нижний скат: 569,40×391×4 мм, угол 15°.
- Верхний скат: 551,38×391×4 мм, угол 14°.
- Наклонные скаты планируется изготовить из гладкого листового ПНД; кассета собирается без клея.

## Механизм варианта A

На каждый канал устанавливается отдельный модуль и отдельная микросерва SG90 либо MG90S со штатной двойной качалкой. Всего на коробку нужно пять серв. Расчётный ход сервы между HOME и EJECT — 83,70°; питание сервы 4,8–6 В.

Серва через короткую тягу поворачивает V-образное коромысло с двумя округлыми пальцами:

- в HOME передний палец удерживает первую банку;
- при ходе на выдачу задний палец сначала принимает и удерживает вторую банку;
- затем передний палец поднимается и выпускает только первую банку;
- при возврате следующая банка занимает позицию выдачи.

Параметры кинематики: ход коромысла −22…+22°, межцентровое расстояние тяги 11,626 мм, пальцы Ø4 мм с рабочим вылетом 19,4 мм. По расчётной модели задний палец принимает вторую банку при 51,83° хода сервы, а первая освобождается при 81,96°. Расчётное перекрытие, когда очередь уже удерживается задним пальцем, а первая банка ещё не выпущена, составляет 30,13°.

Один канал содержит четыре печатные детали: раму, коромысло, тягу и нижний прижим. Модуль надевается на переднюю кромку нижнего ската и стягивается двумя M4×16 без сверления ската. Главный шарнир — M4; шарнир тяги — гладкий палец/винт Ø2 мм. Детали предполагается печатать из PLA/PLA+ или другого подходящего конструкционного пластика на Creality Ender 3 V3 SE.

## Управление и питание

Текущая система управляет пятью сервами напрямую от ESP32: D13/GPIO13, D14/GPIO14, D27/GPIO27, D26/GPIO26 и D25/GPIO25, PWM 50 Гц. Сервы питаются не от ESP32, а от отдельной понижайки, настроенной ровно на 5,0 В; плюс и минус разведены через WAGO, а минус питания серв соединён с GND ESP32. На сигнальной линии каждой сервы предусматривается внешний резистор 10 кОм на GND, чтобы вход не оставался плавающим при запуске.

Важно: этот механизм не самотормозящийся. Пока в канале есть банки, серва должна получать питание и непрерывный корректный PWM. Потеря питания или управляющего сигнала с загруженным каналом пока не считается безопасным состоянием.

## Текущий статус и что требуется проверить

Это полноразмерный инженерный прототип, а не готовое серийное устройство. Численно проверена геометрия, но ещё требуется физический тест одного канала минимум на 300 циклах. Особенно нужна независимая оценка следующих вопросов:

1. Будет ли стабильно выходить ровно одна банка при полной, частичной очереди и при последней банке.
2. Возможен ли перекос банки или проход мимо коротких пальцев, достаточно ли их длины и жёсткости.
3. Достаточен ли момент реальной SG90/MG90S с учётом трения, ударов и полной очереди.
4. Не возникнет ли закусывание на переходе с листа ПНД на печатный модуль.
5. Как поведут себя шарниры, тяга и печатные пальцы после сотен и тысяч циклов.
6. Нужна ли механическая фиксация HOME, чтобы исключить выдачу при пропадании питания.

Перед окончательной оценкой желательно физически измерить штангенциркулем минимум десять банок, записать максимальные длину и диаметр, взвесить самую тяжёлую банку и уточнить маркировку фактически купленной сервы — SG90 или MG90S.
