BZKDP/dozator-bad/v11_три_варианта/ОТБРАКОВАННЫЕ_ИДЕИ.md

# Что не входит в три варианта

## V10 — нижний двухпазовый кулачок на отдельной опоре

Исключён пользователем. Причины: лишняя несущая конструкция не соответствует реальному стеллажу; привод и сборка получились сложными; визуальная модель не объясняла практическое крепление. В V11 эта кинематика не используется.

## Опрокидывающаяся люлька

На бумаге это были всего две печатные детали, но полноразмерная проверка выявила принципиальную проблему: при ходе 50° задняя кромка встречает следующую банку слишком низко, а ход около 80°, необходимый для надёжной выдачи, делает возврат полной очереди опасным для SG90. Дополнительно первая реализация имела коллизии и разрыв дорожки. Ветка оставлена в отдельной папке с красной пометкой только как журнал ошибки; печатать её нельзя.

Итоговое сравнение содержит только A, B и новый C с верхними прямолинейными ножами.

## Прямой привод полноразмерного ротора от сервы

Первая версия B сажала одно-баночную клетку прямо на штатную качалку SG90/MG90S. После расчёта этот вариант исключён: даже 11 банок по 100 г требовали около 3,53 кг·см, а тяжёлая полная очередь — около 11,88 кг·см. Это в несколько раз выше возможностей купленных микросерв и оставляет нагрузку на редукторе в покое.

Старые файлы сохранены только как журнал ошибки в `B_роторная_кассета/REJECTED_DIRECT_DRIVE`; итоговый просмотрщик и активные печатные плиты их не используют. Активный B теперь принципиально другой: банку поворачивает гравитация, а серва лишь снимает механическую собачку.
