BZKDP/dozator-bad/v11_три_варианта/ПРОТОКОЛ_300_ЦИКЛОВ.md

# Приёмка одного канала перед печатью остальных четырёх

Этот тест нужен не для калибровки «на глаз», а для решения: конструкцию уже можно размножать или её ещё надо менять. Сначала печатается **один** комплект выбранного варианта.

## До установки

Записать фактические данные минимум для десяти банок:

- минимальный и максимальный диаметр;
- минимальную и максимальную длину;
- минимальную и максимальную массу полной банки;
- материал и фактическую толщину нижнего листа;
- модель сервы: SG90 или MG90S.

С детали разрешено снять только бахрому и слоновью ногу. Если для сборки приходится подпиливать рабочую геометрию, расширять паз или подрезать один из шести листов, тест прекращается: это изменение модели, а не нормальная сборка.

## Проверка до банок

1. Собрать модуль по инструкции и надвинуть его на переднюю кромку нижнего ската.
2. Затянуть только два штатных зажима; лист не сверлить и не клеить.
3. Вручную пройти полный ход. Не должно быть закусывания, касания соседних разделителей и заметного изгиба листа.
4. Выполнить 20 медленных циклов сервой без банок.
5. Пять раз полностью обесточить систему и включить её в предусмотренной последовательности. Механизм не должен сам выдавать банку или упираться за пределами жёсткого ограничителя.

Для A и C эта проверка выполняется только с полностью разгруженным каналом: их затворы требуют непрерывного удерживающего PWM и не считаются безопасными без питания. Для B дополнительно отключить именно 5 В серв в начале, середине и конце разблокировки. В каждом случае собачка обязана вернуться в индекс без второй банки; до успешного теста режим снятия PWM у B запрещён.

До циклического теста оставить один полностью загруженный канал в HOME не менее чем на 8 часов. Измерить прогиб передней кромки нижнего листа и положение зажимов до/после выдержки. Допуск проекта: никакой самовыдачи, видимого сползания зажима или необратимого роста прогиба.

## 300 рабочих циклов

| Этап | Нагрузка | Циклов | Что проверяется |
|---|---:|---:|---|
| 1 | одна, самая лёгкая банка | 30 | выдача последней банки без помощи рукой |
| 2 | половина реальной очереди | 70 | устойчивый перехват второй банки |
| 3 | полная реальная очередь | 170 | момент, прогиб, двойная выдача |
| 4A — A/C | разгрузить → холодный пуск → снова загрузить полную очередь; 10 пусков между сериями | 30 | повторяемость HOME без самодвижения при пуске; A/C никогда не обесточивать загруженными |
| 4B — B | полная очередь; 10 отключений 5 В серв в HOME и отдельно контролируемые power-cut проверки перехода | 30 | возврат собачки, удержание индекса и отсутствие второй банки |
| **Итого для одного выбранного варианта** | **этап 4A или 4B, не оба** | **300** |  |

Этапы 4A и 4B — альтернативные: для A/C выполняется только 4A, для B — только 4B. Они не складываются в 330 циклов.

После каждых 25 циклов осматривать ось, пальцы/ножи, корпус сервы и зажим ската. Настройки импульсов и скорость в ходе теста не менять: изменение обнуляет серию.

## Критерии допуска

Печатать ещё четыре канала можно только при одновременном выполнении всех условий:

- 300 из 300 команд выдали ровно по одной банке;
- ни одной двойной или самопроизвольной выдачи;
- ни одного касания соседнего канала или разделителя;
- ни одной ручной помощи банке или механизму;
- после холодных включений сохранены те же HOME/EJECT, повторная калибровка не потребовалась;
- нет трещин, белых зон усталости, заметного овала оси или ослабления крепежа;
- серва не дрожит в покое и не остаётся прижатой к механическому упору током.
- неподвижный кожух исключает доступ пальца к затворам, коромыслу/собачке и ротору со стороны выдачи и снизу;
- зажим модуля и восемь внутренних фиксаторов шести листов не сместились после длительной полной нагрузки.

Если условие нарушено, записать номер цикла, массу/размер банки, положение очереди и снять короткое видео сбоку. Это позволит исправить конкретную геометрию, а не компенсировать механическую ошибку случайной скоростью сервы.

## Журнал

| Циклы | HOME, мкс | EJECT, мкс | Скорость | Правильных | Пропусков | Двойных | Самовыдача | Примечание |
|---:|---:|---:|---:|---:|---:|---:|---:|---|
| 1–30 |  |  |  |  |  |  |  |  |
| 31–100 |  |  |  |  |  |  |  |  |
| 101–270 |  |  |  |  |  |  |  |  |
| 271–300 |  |  |  |  |  |  |  |  |

## Интеграционный тест пяти каналов

После допуска одного канала и сборки всех пяти повторить ещё 50 команд: 25 последовательных по кругу и 25 максимально одновременных, которые реально допускает программа. Во время самой тяжёлой команды измерить 5 В прямо на шине серв, суммарный ток и температуру понижайки; отдельно следить за перезапуском ESP32 и дрожанием соседних серв. Просадка не должна выходить за паспортный диапазон конкретных SG90/MG90S, ESP32 не должна перезагружаться, соседние механизмы и банки не должны касаться друг друга.

Испытать намеренный затор одной банки: программа должна прекратить дальнейшие команды, а механика, серва и листы не должны разрушиться или выдать вторую банку. После снятия затора повторить HOME без перекалибровки.

Для каждой полной коробки записать фактическую массу и прогиб полки. При восьми коробках расчётное содержимое может достигать примерно 176 кг без массы коробок, фанеры и механизмов. Допускается только стеллаж с подтверждённой грузоподъёмностью, закреплённый к стене или полу; заднюю часть каждой выступающей коробки нужно удержать от подъёма упором с вертикальным захватом либо ремнём.
