BZKDP/dozator-bad/v13_открытая_кассета/00_РАЗМЕРЫ_И_СБОРКА.md

# V13 — открытая кассета на 5 каналов

Это отдельная новая ветка. Старые файлы не изменены. Модель описывает только кассету; новый дозатор ещё не проектировался. Оба паза под скаты закрытые: передняя и задняя кромки всех шести стенок сохраняются целыми.

## Номинал

- Банка: 70×Ø47 мм; контрольный диаметр 49 мм.
- Кассета без задних наружных крыльев: 590×405×390 мм.
- 5 каналов по 75 мм; шаг 80 мм.
- Картон: номинал 5,0 мм.
- Полипропилен: номинал 2,0 мм.
- Нижний поддон: 559.05×405 мм, 15°.
- Верхний поддон: 516.85×405 мм, 10°.
- Задняя заготовка: 465×390 мм; два крыла по 30 мм.

## Почему сборка простая

1. Нижний и верхний PP-поддоны продеваются сбоку через два закрытых паза первой боковой стенки.
2. На оба поддона сбоку поочерёдно нанизываются ещё пять стенок с шагом 80 мм.
3. Четыре внутренние перегородки соединяются с задней стенкой полупазами — это точно выставляет каналы.
4. Задние крылья загибаются вперёд, обхватывают внешние стенки и фиксируются двумя K01. Для первой проверки можно использовать скотч.
5. Закрытые пазы сами удерживают поддоны по глубине; печатный дозаторный док затем состыкуется с их передними торцами без разрыва траектории банки.

## Важно до резки

Измерить штангенциркулем фактическую толщину картона и PP. В этой модели паз под PP равен 2.6 мм, задний полупаз — 5.6 мм. Файлы раскроя не следует печатать 1:1 до натурного замера.
