BZKDP/dozator-bad/v9_без_клея_переработка/README_СНАЧАЛА.md

# V9: съёмная кассета и надёжная поштучная выдача

## Вывод

Идея съёмной внутренней кассеты правильная. Коробка должна быть только оболочкой, кассета — задавать геометрию пяти каналов, а затворы — стоять на отдельной жёсткой поперечине. Тогда для ремонта ничего не надо отрывать от картона.

Текущий Gate12 нельзя сделать надёжным одним изменением скорости или простым удлинением реек. Рекомендованная связка для новой версии:

1. кассета **A: четыре цельные перегородки + поперечные гребёнки + пять съёмных полос каждого ската**;
2. отдельные наружные носы, снимаемые до подъёма кассеты;
3. затвор **B: вертикальная однобаночная каретка-шлюз**;
4. гладкие сменные вкладыши и нижний уклон 15–16°;
5. сначала один опытный канал и 300 циклов, только потом печать остальных четырёх.

Все STL в папке `3D_концепты_НЕ_ПЕЧАТАТЬ` сделаны в масштабе для выбора архитектуры. Это ещё не производственные STL: отверстия под конкретную серву, защёлки, компенсацию усадки и крепёж сделаем после выбора варианта и натурного контрольного замера.

## Что нашлось в старом проекте

| Параметр | Актуальная поздняя ветка |
|---|---:|
| Банка, расчётный габарит | 70 × Ø47 мм |
| Наружная коробка | 600 × 400 × 400 мм |
| Внутренний объём в модели | 595 × 395 × 395 мм |
| Чистый канал | 75 мм |
| Перегородка | 4 мм |
| Шаг каналов | 79 мм |
| Старый нижний уклон | 13° |
| Старый верхний уклон | 18° |

В самом раннем документе длина банки указана 67 мм, а во всех поздних моделях — 70 мм. Новая модель использует безопасный расчётный габарит 70×Ø47. Перед финальным раскроем всё равно надо промерить максимальную длину и диаметр 10 случайных банок: крышка, этикетка и овальность важнее среднего размера.

Также в старом раскрое есть противоречие: нижняя полоса подписана 845 мм, 3D строит 815 мм. Эти числа в V9 не копировались; нос теперь отдельный.

## Почему сейчас выпадает две или ни одной

У текущего узла ход обеих реек 36 мм. Если `q` — путь из HOME в выдачу, нижние кромки над настилом находятся примерно так:

- длинный передний стопор: `18 + q` мм;
- изогнутый задний стопор: `68 − q` мм.

Обе детали хотя бы касаются силуэта Ø47 только в диапазоне `q = 21…29`, то есть на 8 мм хода. Если потребовать нормальный заход хотя бы на 5 мм, передний надёжно держит лишь до `q=24`, а задний начинает надёжно держать с `q=26`. Между ними остаётся окно, когда ни один не держит очередь полноценно. Медленная серва увеличивает время этого окна, быстрая добавляет удар и отскок.

Остальные причины:

- рабочий контакт старой рейки всего 10 мм и смещён относительно 70-мм банки — банка может перекоситься одним концом;
- в открытом положении запас над Ø47 всего около 7 мм — коробление картона быстро его съедает;
- 13° и шероховатый картон пограничны для последней банки;
- снятие управляющего сигнала с сервы безопасно для нагрева, но старая механика без механической защёлки может быть продавлена очередью;
- затвор базируется на мягких бортах, хотя геометрия должна базироваться на общей жёсткой раме.

Именно поэтому «сделать руки длиннее» не является лечением: окно переключения останется, а изгиб и трение вырастут.

## Кассета без клея

### A — гребёнки и отдельные полосы, рекомендуется

Четыре цельные продольные перегородки пересекаются с 4 нижними и 4 верхними поперечными гребёнками только в отдельных точках. Там делаются обычные встречные полупазы. Пять полос каждого настила кладутся между перегородками и защёлкиваются печатными клипсами. Передняя и задняя верхние гребёнки не дают высоким перегородкам складываться ромбом.

Плюсы: режется вручную или лазером, одна дорожка меняется отдельно, нет длинных ослабляющих пазов, весь узел вынимается пустым вверх.

Номинал при внутренней ширине 395 и листе ровно 4.0 мм:

- кассета: 590 × 391 × 390 мм;
- пять чистых каналов по 75 мм;
- полосы: 74.4 мм, чтобы не клинили между стенками;
- центры перегородок от левого края кассеты: 77, 156, 235, 314 мм;
- нижний скат: горизонтальная проекция 590, угол 15°, длина детали 610.8 мм;
- верхний скат: проекция 535, угол 14°, длина детали 551.4 мм;
- задний сброс: 55 мм по горизонтали и около 68 мм между скатами.

Формула под реальный материал: `чистый канал = (ширина кассеты − 4 × фактическая толщина перегородки) / 5`.

Ширина полупаза: фактическая толщина +0.15…0.25 мм для CNC/лазера либо +0.3…0.5 мм при ручном резе. Номиналу «4 мм» на ценнике верить нельзя.

### B — два цельных настила

Буквальное исполнение исходной идеи возможно только на 6-мм фанере с фрезерованными **несквозными** пазами примерно по 3 мм в обеих сопрягаемых деталях. Обычный сквозной продольный паз разделит либо настил, либо перегородку на части. Вариант красивый, но требует CNC и хуже ремонтируется.

### C — пять обслуживаемых дорожек

Каркас как у A, но пара верхней/нижней полос и наружный нос образуют отдельную кассету одного SKU. Самое удобное обслуживание, зато больше клипс и допусков. Имеет смысл после успешного прототипа A.

### Сервисный стык

Старый настил торчит через коробку на 220 мм, поэтому его невозможно поднять вверх. В V9 внутренний скат заканчивается у фасада, а внешний нос длиной около 240 мм снимается отдельно. Внутренняя полоса перекрывает нос сверху на 30–40 мм «черепицей», чтобы банка не ударялась о ступеньку.

Оставлять лучше пять окон примерно по ширине каналов, а не один проём на 391 мм: вертикальные перемычки сохранят фасад коробки. Над окнами — внутренняя и наружная планки, стянутые шестью M4 с широкими шайбами.

## Четыре затвора в 3D

### A — широкие насадки на текущие рейки

Контакт 72 мм вместо 10 мм сильно уменьшает перекос, но старая строгая противофаза остаётся. Это полезный быстрый опыт, не финальная механика. Надёжная версия этого принципа потребует нового двухдорожечного кулачка с последовательностью: задний закрывается → оба закрыты → передний открывается.

### B — вертикальная каретка с одной ячейкой, рекомендуется

- ячейка под банку: примерно 72 × 49 мм;
- центры входа и выхода: 55–57 мм;
- ход каретки: 56 мм;
- корпус в пределах шага 79 мм, ориентировочно 79 × 82 × 125 мм без носов;
- одно серво и привод рейкой;
- в любом промежуточном положении нет прямого канала для двух банок.

В HOME ячейка принимает одну банку и упирает её в закрытую переднюю стенку. При опускании сплошная верхняя перемычка сначала закрывает вход, затем ячейка совпадает с нижним выходом. На обратном ходе выход закрывается раньше входа.

### C — роторный шлюз с одной U-ячейкой

- ячейка Ø49.5 по диаметру и 72 мм по оси;
- поворот HOME↔выдача около 105°;
- корпус около Ø126–130 × 78 мм;
- вход и выход не могут открыться одновременно;
- одно серво, но больше пластика и места.

Это потенциально самый защищённый вариант. Его стоит выбрать, если габарит Ø130 не мешает фасаду.

### D — две независимые полноширинные гильотины

Самая простая для понимания последовательность: заднюю закрыть, переднюю открыть, переднюю закрыть, заднюю открыть. Отлично диагностируется, но требует 10 серв вместо 5 и возврата к PCA9685/дополнительным каналам.

## Что заказать сейчас

Общее для кассеты и любого затвора:

- 1 лист берёзовой фанеры 4 мм, стандартный 1525 × 1525 мм; либо 1220 × 2440 мм, если первый формат недоступен;
- кусок фанеры 6 мм минимум 500 × 1000 мм на гребёнки, шаблоны и запас;
- гладкий PET/PETG 0.5–1.0 мм, суммарно не меньше 1 м², на сменные вкладыши скатов;
- 2 рейки/планки не меньше 395 × 35 × 9–12 мм для стяжки фасада;
- 1 жёсткая перекладина примерно 395 × 40 × 20 мм под пять затворов;
- болты M4 с широкими шайбами и гайками — 12 комплектов;
- PETG для печати: 1 кг на прототипы, 2 кг если после испытаний печатать пять корпусов;
- тонкие стальные штифты/оси Ø4 мм, M3-крепёж и термовставки — разумно брать после выбора B или C, потому что длины отличаются.

Гофрокартон годится для дешёвого макета, но не для финальной пазовой кассеты: толщина гуляет, кромки мнутся, трение зависит от влажности. Наружную коробку можно оставить картонной.

## Что проверить до финального STL

1. Измерить штангенциркулем максимальные длину и диаметр 10 банок.
2. Измерить внутреннюю ширину/глубину коробки спереди, в центре и сзади; брать минимум.
3. Измерить фактическую толщину купленной фанеры в пяти местах.
4. Выбрать в просмотрщике B или C и проверить, помещается ли габарит у фасада.
5. Сделать один канал и прогнать не менее 300 циклов: 1 банка, 2 банки, полная очередь, последняя банка, перекос основания ±3 мм и отключение питания в середине хода.

Критерий тиражирования на пять каналов: 0 двойных выдач и 0 закусываний за 300 циклов. Скорость после этого настраивается для тишины и удара, а не для исправления дозировки.
