BZKDP/dozator-bad/v11_три_варианта/00_ОБЩАЯ_КОМПОНОВКА/README_КОМПОНОВКА.md

# Общая кассета V11 — финальная геометрия без клея

Кассета рассчитана на ориентировочный внутренний габарит коробки 595×395×395 мм. Она состоит из шести больших листов и восьми одинаковых печатных внутренних фиксаторов. Клей в соединении листов не используется.

## Что изготовить

Большие детали из листа толщиной 4 мм:

- 4 разделителя 590×390 мм;
- 1 нижний скат 569,40×391 мм, угол 15°;
- 1 верхний скат 551,38×391 мм, угол 14°.

Резать нужно только по текущим файлам из `РАСКРОЙ_6_ЛИСТОВ`. Все размеры заданы в миллиметрах. Экспортёр DXF не записывает `$INSUNITS`, поэтому в CAM при импорте DXF нужно вручную выбрать **миллиметры и масштаб 1:1**; SVG также открывать без масштабирования. В файлах уже есть финальные отверстия V11:

- по два отверстия Ø4,4 мм в каждом разделителе — под поперечные болты фиксаторов;
- по четыре отверстия Ø4,2 мм в верхнем и нижнем скате — под формовые штифты;
- центры штифтов перенесены на 10 мм в сторону от оси разделителя, поэтому минимальная перемычка листа составляет 5,9 мм;
- минимальная перемычка от отверстия Ø4,4 до CNC-паза разделителя — 5,675 мм.

Для разделителей есть CNC-зазор +0,25 мм и ручной зазор +0,45 мм. Перед резкой обязательно измерить реальную толщину материала и сначала проверить один короткий пробный паз.

Три STL в `STL_КАССЕТА_СБОРКА` — точные модели больших листов для просмотра и проверки, печатать их не нужно:

- `cassette_divider.stl`;
- `cassette_lower_sheet.stl`;
- `cassette_upper_sheet.stl`.

Старые накладные клипсы `cassette_lock_upper_14deg.stl` и `cassette_lock_lower_15deg.stl` исключены из рабочей папки. Они пересекались с точными листами и разделителями и сохранены только в `LEGACY_DO_NOT_USE`. Ничего из `LEGACY_DO_NOT_USE` не печатать и не использовать для раскроя.

## Восемь обязательных внутренних фиксаторов

Печатная деталь теперь одна и универсальная:

`STL_ПЕЧАТЬ/фиксатор_ската_универсальный_V11_PRINT.stl`

Нужно 8 одинаковых экземпляров: четыре для верхнего ската и четыре для нижнего. Верхний и нижний STL были геометрически идентичны после правильной ориентации, поэтому отдельные файлы намеренно убраны — перепутать детали невозможно.

Один узел крепления:

- 1 фиксатор;
- 1 болт M4×25;
- 2 широкие плоские шайбы M4 DIN 9021, наружный диаметр 12 мм;
- 1 самоконтрящаяся гайка M4.

На всю кассету нужно 8 болтов M4×25, 16 широких шайб M4 DIN 9021 (Ø12 мм) и 8 самоконтрящихся гаек M4. Обычную узкую шайбу Ø9 мм со стороны PETG не использовать: открытое седло уменьшает площадь опоры. Для широкой шайбы расчётная опорная площадь на пластике составляет 65,49 мм².

Формовой штифт Ø3,8 мм входит в отверстие ската Ø4,2 мм на 3,0 мм. Его конец утоплен на 1,0 мм относительно поверхности, по которой движется банка. Плоская грань корпуса касается разделителя, а широкая опорная плоскость касается наружной стороны ската — это два жёстких установочных упора. Поперечный M4 удерживает фиксатор, а открытое наружу седло имеет закрытый 45°-конец: движение к скату останавливает опорная плоскость, движение от ската — закрытый конец седла.

Расчётная проверка дала:

- у закрытого конца M4 может отойти не более чем на 0,424264 мм; с радиальным люфтом отверстия разделителя 0,20 мм и половиной ручного зазора паза 0,225 мм консервативное максимальное удаление составляет 0,849264 мм;
- даже на этом жёстком упоре в листе остаётся не менее 2,150736 мм штифта, поэтому поступательного выхода нет;
- номинально опорная плоскость уже касается ската; в худшем положении sweep даёт контакт при 6,45…9,0°, а самый ранний расчётный полный выход штифта — только при 32,75°.

Это геометрическая проверка CAD, а не замена физическому испытанию готовой фанеры и конкретной печати.

## Готовая 3MF-плита Ender-3

Использовать файл:

`PLATES_3MF/КАССЕТА_8_ВНУТРЕННИХ_ФИКСАТОРОВ_220x220.3mf`

Внутри ровно 8 отдельных одинаковых объектов. Проверенные границы раскладки: X=27…193 мм, Y=74…146 мм, высота 16,5 мм. Детали уже лежат широкой устойчивой гранью на столе; открытый наружный рот седла обращён к столу, поэтому над ним нет печатаемой «крыши».

Профиль контрольного слайса:

- PETG;
- сопло 0,4 мм;
- слой 0,20 мм;
- 5 стенок;
- 5 верхних и 5 нижних слоёв;
- заполнение 40%;
- brim 5 мм;
- поддержки выключены.

Контрольный импорт подтвердил 8 объектов. PrusaSlicer завершил свежий слайс с `support_material = 0`; предупреждений `Floating bridge anchors`, `Loose extrusions`, `Collapsing overhang`, `Long bridging extrusion` и `Low bed adhesion` нет. G-code при этом содержит 32 секции `Bridge infill`; это честно зафиксировано в манифесте. Слайсер не классифицировал их как структурную проблему, поддержки остаются выключенными, но первый экземпляр всё равно нужно осмотреть физически.

## Сборка

Ориентация: X идёт от передней стенки коробки к задней, Y — слева направо при взгляде спереди. Центры четырёх разделителей находятся на 77, 156, 235 и 314 мм от левого края самой кассеты.

1. Собрать четыре разделителя в параллельный пакет.
2. Нижний скат задвинуть сзади вперёд до закрытых передних концов нижних пазов.
3. Верхний скат задвинуть спереди назад до закрытых задних концов верхних пазов.
4. На каждом разделителе ставить оба фиксатора с его правой стороны, то есть в направлении +Y. Отверстия скатов также находятся на этой стороне.
5. Для нижнего ската оставить деталь в печатной ориентации: широкий корпус расположен снизу, штифт направлен вверх в отверстие нижнего ската.
6. Для верхнего ската перевернуть ту же деталь: широкий корпус расположен сверху, штифт направлен вниз в отверстие верхнего ската.
7. Одновременно прижать плоскую боковую грань фиксатора к разделителю и широкую опорную плоскость к наружной стороне ската. Совместить открытое наружу 45°-седло M4 с отверстием Ø4,4 в разделителе; рот седла должен смотреть от ската, а закрытый острый конец — к скату.
8. Вставить M4×25 со стороны соседнего канала: шайба под головкой, затем разделитель, фиксатор, вторая шайба и самоконтрящаяся гайка.
9. Затянуть только до исчезновения люфта. Нельзя вдавливать шайбу в фанеру, сминать PETG или стягивать разделитель дугой.
10. Повторить для всех восьми узлов. До загрузки банок рукой проверить, что оба ската дошли до закрытых концов пазов, каждый штифт вошёл в своё отверстие и ни один лист не выходит через открытый конец.

Сначала напечатать и насухо установить только один верхний и один нижний фиксатор. Если штифт не входит свободно от руки, не забивать его: проверить диаметр отверстия, слоновью ногу и масштаб слайсера. Только после успешной примерки печатать всю плиту.

## Снятие

1. Полностью разгрузить кассету и вынуть её из коробки либо надёжно поддержать.
2. Снять восемь гаек, шайбы и болты.
3. Каждый верхний фиксатор поднять от верхнего ската, каждый нижний — опустить от нижнего ската, строго вдоль оси штифта.
4. Верхний лист вывести вперёд, нижний — назад.
5. Осмотреть штифты, седло M4 и слои вокруг корпуса. Деталь с трещиной, побелением или расслоением повторно не устанавливать.

## Проверенный габарит и обязательные физические испытания

В мировой сборке все восемь фиксаторов с M4 занимают X=3,029…592,080 мм. Полная кассета вместе с наклонными листами имеет исходную границу X=−0,484…592,080 мм из-за толщины верхнего листа. Поэтому при установке всю кассету нужно сместить на 0,5 мм назад от внутренней передней плоскости коробки. После этого полный проверенный габарит равен X=0,016…592,580, Y=2…393, Z=0…390 мм и входит в номинальные 595×395×395 мм; сзади остаётся 2,420 мм. Переднее окно коробки этому смещению не мешает.

По аналитической полупространственной проверке ни один фиксатор не входит в объём движения банки: ближайшая точка штифта остаётся на 1,0 мм с наружной стороны беговой поверхности. M4, широкие шайбы и гайки имеют отдельный запас 6,0 мм до канального полупространства; их точные пересечения с обоими скатами и четырьмя разделителями равны нулю.

До реальной эксплуатации всё ещё нужно проверить:

- фактическую толщину и плоскостность листов;
- посадку штифта и прочность слоёв на конкретном принтере;
- удержание полностью загруженной кассеты при рывке за оба ската;
- ползучесть PETG после суток под максимальной нагрузкой;
- повторную разборку и сборку;
- отсутствие касания банок после загрузки каждого из пяти каналов.

Коробка будет частично нависать перед полкой. Номинальный свес 200 мм в сравнительной сцене — только визуальный параметр, не рассчитанное крепление. С полностью загруженной коробкой проверить опрокидывание вокруг передней кромки полки. При любом отрыве задней части обязателен отдельный задний упор или страховочный ремень к стеллажу.

Машиночитаемые координаты, SHA-256, матрицы установки, collision=0, sweep и результат слайса находятся в `ФИКСАТОРЫ_V11_MANIFEST.json`. Мировые STL одного узла и группы M4 лежат в `STL_ЗАМКИ_СБОРКА` и предназначены только для просмотрщика. Активные файлы V11 повторно формируются командой `python make_lock_plate.py` из этой папки при сохранённой структуре поставляемого дерева. Каталог `LEGACY_DO_NOT_USE` не удалять: генератор использует его как неизменяемое доказательство причины отбраковки старых клипс; для печати и раскроя его содержимое по-прежнему не применяется.
