BZKDP/dozator-bad/v11_три_варианта/A_верхнее_коромысло/README_ВАРИАНТ_A.md

# V11 — вариант A: верхнее коромысло

**Статус: ПРОТОТИП ДЛЯ СРАВНЕНИЯ. Сначала напечатать и испытать один канал минимум на 300 циклах.**

## Что здесь принципиально другое

Одна SG90/MG90S через штатную двойную качалку и короткую тягу качает одно V-образное коромысло. В HOME передний палец держит первую банку, в EJECT он поднимается, а задний уже удерживает вторую. Жёсткие упоры ограничивают аварийный перелёт механизма, но эта геометрия **не является пассивной защёлкой**: пока в канале остаётся хотя бы одна банка, серва должна получать питание и непрерывный корректный PWM 50 Гц. Одного питания без управляющих импульсов недостаточно.

Коробка остаётся глубиной около 600 мм и частично нависает перед полкой. Каждый из пяти одинаковых модулей зажимается A01+A04 двумя M4 за **общую переднюю кромку нижнего ската**, без сверления листа. Четыре внутренних разделителя только направляют банки и ничего не держат. Отдельная балка, пятый/шестой разделитель и подиум не нужны.

## Печать одного канала

- A01, A02, A03, A04 — по одной детали; все уже лежат правильной стороной.
- PETG или PA, сопло 0.4, слой 0.20, 4 периметра, 35–45% gyroid.
- Поддержки не нужны. Пальцы A02 печатаются вертикально, поэтому не являются мостами.
- Для высокой A01 обязателен brim 4 мм: PrusaSlicer предупреждает о малой площади контакта со столом. Раскладка оставляет под такой brim не меньше 1 мм свободного поля до края стола и не сводит соседние детали.
- Один комплект помещается на `A_ПЛИТА_220x220_1_канал.3mf` с полем не меньше 5 мм.

## Ровно 8 сгруппированных действий от снятия с печати до закреплённого модуля

Правило общее для A/B/C: одна макрооперация — один осознанный этап с единым результатом. Парные одинаковые элементы, устанавливаемые или затягиваемые в рамках такого этапа (например, два винта сервы, две оси/гайки или два нижних винта), считаются одной сгруппированной макрооперацией; электропроводка пяти серв считается отдельно.

1. Осмотреть и снять только заусенцы с четырёх печатных деталей.
2. Защёлкнуть SG90/MG90S в A01.
3. Поставить A02 на один M4 переплётный pivot, не пережимая шарнир.
4. Защёлкнуть большой конец A03 на печатный палец A02.
5. Закрепить малый конец A03 одним M2 шарнирным винтом/пальцем с **гладкой рабочей шейкой** во внешнем отверстии штатного horn (радиус около 9 мм); резьба не должна скользить по PETG.
6. Выставить HOME и закрепить horn штатным винтом на шлице сервы.
7. Одним движением завести A01 сверху и A04 снизу на общую переднюю кромку ската.
8. Вставить два комплекта M4×16 с самоконтрящимися гайками и равномерно попеременно затянуть их за торцом листа.

После крепления без банок проверить ручной ход между упорами и откалибровать импульсы. Микросекунды другого канала вслепую не копировать.

## Геометрия

- design envelope банки: Ø48×70 мм;
- чистый канал: 75 мм, шаг каналов 79 мм;
- нижний скат: 15°;
- коромысло: -22…+22°;
- серва: 83.70°;
- тяга: 11.626 мм между центрами;
- пальцы Ø4.0 мм, вылет 19.4 мм.

Численная проверка движения банки, а не замороженных демонстрационных цилиндров: задний палец принимает упакованную вторую банку при 51.83° сервы, передний освобождает первую при 81.96°. Положительное перекрытие передачи — 30.13°, минимальный свободный коридор центра первой банки между двумя барьерами — 11.44 мм, минимальный шаг центров первой/второй после передачи — 48.00 мм при требуемых 48.00 мм.

## Что обязательно проверить на физическом прототипе

- фактический радиус отверстия штатного horn (комплекты SG90 бывают 8–10 мм);
- люфт pivot и тяги после 100 циклов;
- H03: гладкая Ø2 мм шейка должна работать в Ø2.3 отверстии A03, а резьбовая часть находиться только в зоне фиксации. Обычный полностью резьбовой M2 допустим лишь для макета и считается точкой износа с осмотром каждые 300 циклов;
- не цепляет ли банка Ø48 палец при перекосе;
- хватает ли Ø4 пальца при полной очереди и ударе последней банки;
- потеря питания или PWM при загруженном канале может провернуть коромысло; перед снятием питания или сигнала канал нужно полностью разгрузить.

## Честное ограничение нагрузки

Лимит определён по **пику**, а не по более красивому среднему значению. 22×100 г дают 0.0523 Н·м, 11×200 г — 0.0523 Н·м: обе контрольные загрузки укладываются в 0.060 Н·м. Полные 22×200 г требуют 0.1045 Н·м и запрещены.

| Масса банки | Строгий расчётный максимум до 0.060 Н·м | Пик на максимуме |
|---:|---:|---:|
| 50 г | 22 | 0.0261 Н·м |
| 100 г | 22 | 0.0523 Н·м |
| 200 г | 12 | 0.0570 Н·м |

Это квазистатика без трения, ударов и изгиба пластика. Первый физический тест начинать максимум с 8 банок по 200 г и повышать загрузку только после 100 циклов.

## Питание и безопасный запуск

На каждый оранжевый сигнальный провод поставить внешний 10 кОм на GND. Запуск: 5 В серв выключены → загрузить ESP32 и держать сигнальные пины LOW → запустить корректный PWM 50 Гц и подать калиброванный HOME → включить 5 В серв → только затем загрузить банки. Пока в канале есть банки, PWM должен непрерывно присутствовать в HOME, EJECT и во время движения. Выключение: остановить выдачу → HOME → **полностью разгрузить канал** → снять 5 В серв → только после снятия 5 В прекратить PWM → выключить контроллер. Потеря питания или сигнала с банками безопасной не считается.

`ПРОТОТИП_ОТЧЕТ_ПРОВЕРКИ.json` содержит воспроизводимые численные проверки. STL сборки предназначены только для просмотра, печатать их не нужно.
