BZKDP/dozator-bad/v11_три_варианта/B_роторная_кассета/README_СБОРКА.md

# V11-B — гравитационно индексируемая звёздочка

## Почему это уже не прежний прямой привод

SG90/MG90S **не должна крутить ротор или держать очередь**. По расчётной кинематике банка и уклон 15° поворачивают четырёхкарманную звёздочку до следующего индекса; ровный шаг 90° считается подтверждённым только после 20/20 индексаций самой лёгкой банкой и полного теста 300 циклов. Серва штатным двойным рожком кратко нажимает на хвост B03 и снимает верхнюю собачку. Затем рожок возвращается, собачка падает своим весом и следующая из четырёх индексных лопастей должна упереться в неё.

В HOME рожок имеет зазор. Силовой путь: банка → B01 → индексная лопасть → B03 → печатная ось и hard stop B02L → рама → два зажима нижнего листа кассеты. В номинальной геометрии вал сервы не является тормозом. **Это ещё не доказанный fail-safe:** снимать PWM разрешается только после физических проверок возврата собачки при отключении питания, загрязнённом шарнире и длительной полной нагрузке.

## Печать Ender-3

- Открывать готовые `PLATES_3MF/*.3mf`: ориентация и разнос уже сохранены.
- Plate 01: B01A + B01B + B03 + разовый T01. Plate 02: B02I + B02L. Plate 03: B02R. Plate 04: B02O + B02GL. Plate 05: B02GR.
- PETG, 0.20 мм, 4 периметра, 5 верх/низ, 25–30% gyroid.
- **Supports OFF на всех пяти плитах.** B01A печатается единственной торцевой стенкой на столе, все лопасти и продольные рёбра растут вверх; противоположный торец открыт. B01B, обе щеки, обе направляющие, B02O и B03 лежат широкими гранями на столе.
- Только для Plate 02 включить brim 4 мм: у открытого C-профиля B02I узкая контактная полоса. Структурных мостов/висящих траекторий в проверке PrusaSlicer нет; предупреждение только о прилипании B02I.
- Детали на Plate 01 разведены с запасом под skirt/brim; генератор проверяет AABB-зазор и стол 220×220.
- T01 имеет отверстия +0.20/+0.35/+0.50 мм, отмеченные 1/2/3 точками. В генераторе выбран +0.35 мм.

## Детали и крепёж

На канал: **9 рабочих печатных деталей** B01A, B01B, B02L, B02R, B02GL, B02GR, B02I, B02O, B03. Coupon печатается один раз, не на каждый канал. Плоская рама собирается без клея: четыре штифта соединяют щёки с направляющими, два штифта позиционируют B02O, а B02I садится на формовые гнёзда обеих направляющих. После M4-оси и двух винтов зажима узел захвачен механически. B01B надевается на три ключа B01A и также захватывается осью.

Крепёж: 2×M2x8 серва, 1×M4x75 ось, 1×M4 термовставка длиной 5 мм и наружным Ø5.0–5.3 мм, 2×M4x14 зажим нижнего листа кассеты и штатный центральный винт рожка. Карман термовставки в модели Ø4.70×5.0 мм: сначала проверить посадку одной фактической вставки, а при другом наружном диаметре скорректировать параметр до печати пяти комплектов. Собачка вращается на печатной оси — отдельного винта и пружины нет.

Суффикс `_A02` в имени B02I означает фактический нижний лист кассеты `cassette_lower_sheet`, а не печатную деталь A02 варианта A.

## 12 сборочных + 2 установочных действия на канал

Итого 14 сгруппированных действий. Одна макрооперация — один осознанный этап с единым результатом. Парные одинаковые элементы, устанавливаемые или затягиваемые в рамках такого этапа (например, два винта сервы или два нижних винта), считаются одной сгруппированной макрооперацией. Обычная очистка печати/осмотр и электропроводка пяти серв в сравнительный счёт не входят.

1. Вплавить одну M4 вставку в B02R.
2. Посадить B02GL на два осевых штифта B02L.
3. Посадить B02GR на два осевых штифта B02R.
4. Посадить левую сторону B02I на формовое гнездо B02GL и надеть B02O на её штифт.
5. Закрепить серву в B02L двумя M2x8.
6. Подать HOME-команду серве.
7. Поставить штатный рожок по метке HOME и затянуть его штатным винтом.
8. Надеть B03 на печатную ось B02L.
9. Совместить три разных по углу ключа и прижать B01B к B01A до торцевого упора; клей не нужен.
10. Положить собранный B01A+B01B на левую стационарную втулку.
11. Закрыть правую половину: ввести B02GR в правое гнездо B02I, её штифт — в B02O, а втулку — в ротор.
12. Вставить и затянуть M4x75 до упора рама-в-раму, не зажимая ротор.
13. Надвинуть B02I на переднюю кромку нижнего листа и отцентрировать между разделителями, не передавая на них вес.
14. Подтянуть два M4 снизу через мягкие накладки; нижний лист кассеты не сверлить.

## Габарит относительно шести листов

Геометрия не перерисована приблизительно: генератор каждый раз загружает фактические `cassette_lower_sheet.stl` и `cassette_divider.stl` из `00_ОБЩАЯ_КОМПОНОВКА`. После перевода в локальные координаты передняя кромка нижнего листа кассеты — `y=0`, а четыре разделителя выступают до `y=+39.482 мм`. В зоне разделителей ротор целиком уже 75-мм канала; более широкие щеки, собачка и серва начинаются только с `y>39.732 мм`, то есть с гарантированным отступом 0.25 мм перед их носом. Sweep всех пяти модулей против всех четырёх реальных разделителей обязан дать 0 мм³.

Штатный двойной рожок идёт от 210° до 238°. Первые ~10° он выбирает свободный зазор, затем непрерывно толкает округлый follower B03 до печатного hard stop −7.1°. Расчёт профилей проверяет монотонную контактную ветвь: в HOME между рожком и B03 больше 1 мм, в UNLOCK они касаются, но не пересекаются.

## Момент и последняя банка

Для худшего режима 22×200 г расчётный момент сервы при снятии нагруженной собачки — **0.03770 Н·м**, лимит проекта <0.060 Н·м. В запертом состоянии на серве 0 Н·м.

Порог страгивания пустого ротора — не более 0.006 Н·м, то есть не более 0.143 Н касательной силой на радиусе 42 мм. При этом расчётная минимальная масса последней банки с двукратным запасом — **32.2 г**. Короткий встроенный 20° носик опускает банку с общего нижнего листа кассеты в карман и снимает её с неподвижной опоры.

Физическая приёмка обязательна: поднять B03, отключить питание сервы, проверить страгивание; затем самая лёгкая настоящая банка должна сама выполнить 20 из 20 поворотов HOME→следующий HOME. Отдельно отключить 5 В в начале, середине и конце разблокировки, повторить с сухим загрязнённым шарниром, а затем оставить полную очередь в HOME минимум на 8 часов и проверить отсутствие ползучести/самовыдачи. Если хотя бы один тест не пройден — PWM не снимать, механизм не считать самофиксирующимся и не увеличивать импульс сервы: убрать перекос оси/заусенцы втулки и повторить тест.

Перед эксплуатацией закрыть ротор и собачку неподвижным защитным тоннелем/кожухом так, чтобы палец не доставал до движущихся деталей ни со стороны выдачи, ни снизу. Кожух не должен поддерживать раму и не должен пересекать траекторию банки.

Сначала печатать один канал и провести 300 циклов. Только после этого печатать остальные четыре.
