BZKDP/dozator-bad/v11_три_варианта/C_верхние_линейные_ножи/README_C2.md

# V11-C2 — верхние линейные ножи

Полноразмерный сравнительный прототип одного канала. На канал нужны пять функциональных печатных деталей: рама C01, две прямые заслонки C02/C03, коромысло C04 и плоский кронштейн сервы C05. Штатная двойная качалка SG90/MG90S входит в карман C04; два M3-пина скользят прямо в пазах заслонок, отдельных тяг нет. C05 отделён от рамы ради гарантированной печати без поддержек и крепится одной сгруппированной операцией двумя M2×10.

## Что делает механизм

- HOME −42°: передний нож 10.501 мм, задний 52.499 мм.
- MID 0°: оба ножа 31.500 мм.
- EJECT +42°: передний нож 52.499 мм, задний 10.501 мм.
- Полный ход сервы ровно 84° и укладывается в доступный диапазон SG90/MG90S, но старые значения HOME/EJECT от прежнего дозатора использовать нельзя: направление и обе конечные точки C калибруются заново без банок.
- Во всём ходе хотя бы один нож остаётся не выше 31.5 мм: идеального сквозного окна для банки Ø48 нет.
- Отклонение пина от центра паза максимум 4.033 мм; половина хода паза 4.8 мм, остаток 0.767 мм.
- Минимальный вертикальный Jacobian 23.322 мм/рад; сингулярности в рабочем диапазоне нет.

Идеальная кинематика выдаёт одну банку, включая последнюю: на прямом ходе задний нож сначала перехватывает очередь, затем передний освобождает первую банку. На обратном ходе передний закрывается до открытия заднего. Реальный результат всё равно зависит от выдержки EJECT и 300-циклового теста.

Расчёт не приписывает банкам искусственный зазор: касающиеся расчётные кольца Ø48 имеют шаг 48.0 мм. Между затворами 50.5 мм, поэтому входящий нож должен раздвинуть очередь на 2.5 мм; начальное геометрическое внедрение в траекторию второй банки около 0.593 мм. Это главный источник реального усилия и обязательная часть теста одной дорожки.

## Точная привязка к шести листам

Проверка использует непосредственно `00_ОБЩАЯ_КОМПОНОВКА/STL_КАССЕТА_СБОРКА/cassette_lower_sheet.stl` и `cassette_divider.stl`, а не упрощённые параллелепипеды. Точный нижний скат имеет 391×569.402×4 мм, разделители — реальные прорезанные детали из заготовок 590×390×4 мм. Вертикальные носы разделителей продолжаются примерно на 41 мм вперёд кромки ската.

Поэтому задний затвор перенесён в Y=−25 мм, передний — в Y=+25.5 мм. Вся широкая механика 78.4 мм находится перед реальными носами разделителей; в зоне кромки ската ширина рамы не больше 74.4 мм. Генератор проверяет 29 углов во всех пяти позициях шага 79 мм против точного нижнего листа и всех четырёх точных разделителей. Листы не подрезаются и не сверлятся.

## Печать на Ender-3

Сначала **один раз на партию одинаковых серв и текущие настройки филамента/принтера** напечатать T01 и выбрать посадку штатной качалки. На каждый канал T01 повторять не нужно. Затем печатать комплект C01–C05. Все STL уже ориентированы: C01 стоит плоской боковой спиной, C02/C03 и C04 лежат плашмя, C05 лежит широкой стенкой на столе. Support не нужен. Brim по умолчанию выключен; при склонности PETG к короблению допустим общий brim максимум 2 мм. Пазы заслонок открыты в ненагруженном сервисном направлении; над ушком каждого паза остаётся короткий мост 10 мм. Контрольный слайс не обнаружил структурных предупреждений и прошёл с выключенными поддержками, но первый комплект нужно осмотреть до сборки.

Готовая раскладка: `STL_ПЕЧАТЬ/C2_ПЛИТА_1_КАНАЛ_готовая_220x220.3mf`. Это шесть отдельных объектов — C01–C05 и один T01 для **первой** партии. Для следующих каналов той же партии отключить объект T01 в слайсере; C01–C05 вручную поворачивать не нужно.

## Первичная сборка — один раз

Правило общее для A/B/C: одна макрооперация — один осознанный этап с единым результатом. Парные одинаковые элементы, устанавливаемые или затягиваемые в рамках такого этапа (например, два винта сервы, две оси/гайки или два нижних винта), считаются одной сгруппированной макрооперацией; электропроводка пяти серв считается отдельно. Поэтому ниже ровно 6 первичных и 2 установочные макрооперации.

1. Вставить две обычные гайки M3 DIN934 в открытые шестигранные карманы C04. Для фиксации допустим только слабый фиксатор, явно совместимый с PETG; безопасная альтернатива — контрольная метка лаком и регулярный осмотр.
2. Закрепить SG90/MG90S на C05 двумя M2×10 самонарезающими винтами.
3. Приложить две прямоугольные лапки C05 к двум упорам C01 и затянуть два M2×10 с шайбами с наружной стороны рамы.
4. Опустить C02 и C03 сверху в подписанные направляющие C01.
5. Подать MID, вложить штатную двойную качалку в C04, надеть её на шлиц и затянуть штатный центральный винт.
6. Вставить два винта-оси M3×18 справа через пазы ножей в захваченные гайки; в зоне скольжения нужна гладкая шейка Ø3, а не резьба. Оставить 0.2–0.4 мм свободного осевого люфта. Полностью резьбовой M3 допустим только для первого прототипа с обязательным осмотром PETG-пазов после 300 циклов.

Итого при первичной сборке затягиваются шесть крепёжных винтов и штатный центральный винт качалки. Купон T01 печатается один раз на партию одинаковых серв и неизменные настройки филамента/принтера, не на каждый канал.

## Установка на нижний скат

1. Надвинуть цельный кромочный зажим C01 на переднюю кромку точного нижнего листа до упора Y=−60.
2. Снизу равномерно затянуть два M3×10 в X=±34, Y=−61.2. Они прижимают целый лист к двум верхним губкам; сверление не требуется.

Верхние губки одновременно образуют короткие плавные центрирующие рампы: проход сужается с 73 до 71 мм при высоте 0.4→2.0 мм, оставляя расчётной банке длиной 70 мм суммарно 1 мм. После затяжки вручную проверить, что переход скат→печатная дорожка не имеет ступеньки и что все реальные банки проходят рампы без заедания торцевого кольца.

## Снятие и обслуживание

1. Обесточить сервы после разгрузки канала и придержать C01 рукой.
2. Ослабить только два нижних M3×10 на 2–3 оборота и стянуть весь собранный модуль вперёд. Серво, коромысло и ножи разбирать не нужно.
3. Очистить направляющие насухо, проверить свободный ход ножей и осевой люфт пинов 0.2–0.4 мм; затем надеть модуль обратно и равномерно затянуть те же два винта.

## Расчёт нагрузки

Расчёт: тяга очереди `N·m·g·sin(15°)`; μ=0.20; затем клиновое усилие и момент на плече 31.383 мм. Не учтены трение направляющих, удары, коробление листа, разброс клонов и потери редуктора.

| Банок | Масса каждой | Тяга по скату | Усилие ножа | Момент | SG90 1.8 кг·см | MG90S 2.2 кг·см |
|---:|---:|---:|---:|---:|---:|---:|
| 11 | 100 г | 2.792 Н | 0.705 Н | 0.226 кг·см | 12.5% | 10.3% |
| 11 | 200 г | 5.584 Н | 1.410 Н | 0.451 кг·см | 25.1% | 20.5% |
| 22 | 100 г | 5.584 Н | 1.410 Н | 0.451 кг·см | 25.1% | 20.5% |
| 22 | 200 г | 11.168 Н | 2.820 Н | 0.903 кг·см | 50.1% | 41.0% |

Нагрузки **11×200 г и 22×100 г разрешены только для MG90S** и только после измерения реального пика ≤1.5 Н на отсоединённом коромысле и 300 циклов одного канала. Для SG90 обе нагрузки запрещены: расчётные 1.410 Н выше лимита 1.0 Н. С SG90 начинать не более чем с 7×200 г или 15×100 г, затем измерить пик и оставить только очередь, реально дающую ≤1.0 Н. 22×200 г не принимается ни для SG90, ни для MG90S: 41–50% stall получено ещё до неучтённых потерь.

## Электропитание и обязательная приёмка

Механизм не самотормозящийся: пока в канале остаётся хотя бы одна банка, корректный калиброванный PWM 50 Гц должен **непрерывно** присутствовать в HOME, EJECT и во время движения. Одного питания сервы без импульсов недостаточно. Нужен pull-down 10 кОм от оранжевого сигнала к общей земле; ESP32 сначала запускает PWM и устанавливает HOME, и только затем включается питание 5 В серв. Остановка: прекратить выдачу → HOME → полностью разгрузить канал → снять 5 В серв → только затем прекратить PWM и выключить контроллер. Не оставлять загруженную кассету с питаемой сервой и отключённым ESP32. Если пассивное удержание при отключении питания обязательно, выбирать B, а не C.

До тиражирования напечатать один канал: проверить реальное усилие, затем выполнить 300 циклов. Критерии: 0 дублей, 0 пропусков, отсутствие касания разделителей, самопроизвольного схода модуля, заедания и заметного нагрева сервы.
