BZKDP/dozator-bad/v14_кассета_ПНД4/ПЕЧАТЬ_ДОКА/README_ПЕЧАТЬ_ДОКА.md

# ДОК V2 — ПОЛНЫЙ НОВЫЙ КОМПЛЕКТ. 4 листа, БЕЗ поддержек

Это ВТОРОЙ дозатор с нуля: печатается ВСЁ (старый BX04 не трогаем, он работает).
Рама целиком на пазах — ни одного винта и ни одной лишней дырки. Винты только
внутри головы (серва, ось коромысла, тяга).

## Листы — ВЕСЬ новый ящик, печатается всё (5 запусков)
| Лист | Состав | Габарит | Время (слайс) |
|---|---|---|---|
| 1 ПЕЧАТЬ | СЛИТНЫЙ блок каналы 1-2 + 8 вкладышей | 206×204×111 | 16 ч 25 м (слой 0.28) |
| 2 ПЕЧАТЬ | СЛИТНЫЙ блок каналы 3-4 + 8 вкладышей | 206×204×111 | 16 ч 25 м (слой 0.28) |
| 3 ПЕЧАТЬ | канал 5 + 2 щёчки + 8 вкладышей | 206×176×111 | ~13 ч (слой 0.28) |
| 4 ПЕЧАТЬ | 5 коромысел с валиками + 5 тяг + 6 втулок + 7 замков-салазок + 8 проставок | 174×203×23 | 5 ч 03 м (слой 0.2) |
| 5 ПЕЧАТЬ | 5 держателей-ХВОСТ | 210×185×15 | 6 ч 03 м (слой 0.2) |

ИТОГО: ~57 часов. Кассета — отдельно из картона+ПНД по чертежам РАСКРОЙ.

## КАЛИБРОВКА (по аудиту): плечо качалки зафиксировано 10 мм
При плече 10 мм расчётный ход сервы ≈105° на ходе коромысла −28…+28°. СТАРЫЕ границы
30…110° (с прошлого дозатора) НЕ переносить вслепую — откалибровать HOME/EJECT заново
на собранном канале. Реальную покупную качалку MG996R ставить отверстием ровно 10 мм от оси.

## ГЛАВНЫЙ ОТКРЫТЫЙ РИСК (аудит-3, физ-симуляция Pymunk): ЗАДНИЙ ПЕРЕХОД
125 банок (25/канал) геометрически влезают, все CAD-конфликты закрыты. НО работа полной
очереди 25/25 НЕ доказана: физ-модель показала чувствительность к трению — при μ≈0.30
выходит 14-16 банок, остальные зависают у заднего перехода (распорная колонка); при μ≈0.15
выходят все 25. Задний проход = 51 мм (585−534), запас к Ø47 = 4 мм, к Ø50 = 1 мм.
ОБЯЗАТЕЛЬНО до тиража: собрать ОДИН двухъярусный канал из настоящего картона/ПНД, загрузить
ПОЛНЫЕ 25 банок, прогнать выдачу включая простой без команд. Если зависает — дорабатывать
переход (плавная направляющая, положение верхнего края и задней стенки), пересчитав с
сохранением 25 мест и раскроя. Это НЕ лечится настройками дока в одиночку.

## ПРОШИВКА (аудит-3 п.4): после цикла снимается PWM (auto-detach) — удержание полной
очереди в HOME не подтверждено. На физтесте проверить: держит ли закрытый стопор очередь
без питания; если нет — оставлять HOLD в HOME (не detach). Прошивку на ESP32 аудит не гонял.

## СНАЧАЛА НАПЕЧАТАЙ ТЕСТ!
Файл «ТЕСТ_ОДИН_КАНАЛ (проверить проход банки).stl» = один канал + 4 вкладыша, ~10 ч.
Проверь на нём ДО печати всего ящика: (1) банка проходит свободно, (2) качество печати
столбов/балки, (3) вкладыши надеваются и картон входит в щель. Если ок — печатай листы 1-5.

## V2.5 — ИСПРАВЛЕНИЯ ПО ФОТО ПЕРВОЙ ПЕЧАТИ
- БАНКА НЕ ПРОЛАЗИЛА: узкое место было сразу за кромкой ската (укорачивание подтянуло
  туда столбы+борта). Столбы ОТОДВИНУТЫ из канала (проём для банки 71->76 мм), борта
  УБРАНЫ, переход кромка->жёлоб сглажен, выход удлинён. Прокат банки в CAD: проход
  свободен для Ø47×67 и с запасом до Ø50×72.
- БОРТА-ШТЫРИ на стыке блоков: борта совсем убраны — банку по бокам ведёт картонный
  канал (до кромки) и стенки столбов (после). Штырей больше нет.
- БОКОВЫЕ СТЕНКИ-НАПРАВЛЯЮЩИЕ вернул (вели банку по доку): целые вдоль всего канала,
  ласточкин теперь под ними (в основании z0-6) и их не режет — штырей нет.
- ЛАСТОЧКИН НЕ ЛЕЗ: зазор 0,25 -> 0,6 мм — собирается от руки, без напильника.
- КРИВОЙ СТЫК: теперь каналы 1-2 и 3-4 печатаются СЛИТНЫМИ блоками (без стыка внутри).
  Стыков осталось 2 вместо 4 — вдвое меньше подгонки и перекосов.
- Мост балки провисает — это НЕ мешает (банка проходит ниже), лохмоту снизу срезать ножом.

## Настройки (Ender 3 V3 SE, Hyper PLA)
- 220/60 C; СЛОЙ: листы 1-3 -> 0.28 (минус ~20% времени, силовым моноблокам точнее не нужно), листы 4-5 -> 0.2; стенки 3, верх/низ 4 слоя, 12% gyroid
- Поддержки ВЫКЛ. Мост балки печатается мостом — обдув 100% со 2 слоя обязателен
- Кайма 4, юбка выкл, слон.нога 0.1-0.15, детали НЕ переставлять
- Лист 4: мелочь снимать аккуратно, замки и тяги плашмя, валики коромысел стоймя

## Предупреждения слайсера — какие НОРМАЛЬНЫЕ
- 1/2/3 «Long bridging»: это 60-мм мост под балкой между столбами. Печатается мостом,
  низ слегка лохматый — это ВЕРХ детали над приёмной зоной, ни на что не влияет.
- 4 «Floating anchors / Loose / Long bridging»: это ТЯГИ — их круглый стержень мостится
  между проушинами. Ориентация 1:1 как в листе PLATE_C2, который ты уже печатал — норм.
- Ничего другого слайсер говорить не должен (проверено по-детально).

## ПОКУПКИ на второй ящик
- 5 × MG996R
- ESP32 WROOM32 (CH340) + понижайка 5-6 В с запасом по току ≥4-5 А (пики серв 2-3 А!)
- Винты: M3×16..25 ×20 + гайки M3 ×30 (сервы) · M3×30 ×5 (оси коромысел) + шайбы ×10
- M2×12 ×5 и M2×8 ×5 + гайки M2 ×10 (тяги)
- Двусторонний скотч, провода; картон/ПНД на вторую кассету — раскрой уже готов

## РЕГУЛИРОВКА БЕЗ ПЕРЕПЕЧАТКИ
Щель под картон задаёт сменный вкладыш-седло на ребре моноблока. Метки на торце:
2 зуба = номинал (пара даёт 5,6 под гофру 5) · 3 зуба = узкий (пара 3,6; НОМИНАЛ+УЗКИЙ = 4,6 под твой гофролист Т23С ~4 мм). Широкий калибр (под картон 6-7) из комплекта убран — понадобится, допечатаем за 20 минут.
В комплекте 12 номинальных + 12 узких. Разные калибры слева/справа = сдвиг стенки +-0,5 мм. Толщина листа ПНД/ПП (4 или 2)
на док НЕ влияет: 42 мм в чертежах кассеты — это ВЕРХ листа; под 2 мм перегенерируй
только чертежи картона (plastic_thickness=2). Высота головы — шимами (напечатай с
листа V3 при надобности). Меньше каналов — меньше моноблоков.

## Сборка — по шагам в СБОРКА_ДОКА_V14_3D.html (9 шагов)
Кратко: моноблоки в ряд (ласточкины сверху) -> щёчки -> вкладыши (2 зуба) ->
голова: серва+качалка в держатель, язычок в паз балки -> коромысло на ось + тяга ->
замок-салазки сзади до щелчка -> кассета в раструбы, придвинуть до упора листа
в язычки -> скотч под крайние моноблоки, общая земля, тест без банок.

## Если что-то не лезет
- Кассета не садится — широкий вкладыш (1 зуб) на упирающуюся стенку.
- Замок-салазки туго — пройти надфилем ушки; болтается — капля клея на хвост (но
  сначала проверь, что ушки защёлкнулись за бугорки).
- Ласточкины собираются от руки; коромысло на втулке должно падать под своим весом.
