BZKDP/dozator-bad/v11_три_варианта/B_роторная_кассета/REJECTED_DIRECT_DRIVE/README_СБОРКА.md

# V11-B — роторная кассета, рабочий прототип

## Что здесь реально приводит банку

Одна **SG90/MG90S на канал** стоит соосно ротору, но утоплена внутрь его пустого центра и повернута корпусом вниз. Штатный двойной рожок входит в фасонный карман внутренней перемычки ротора. Никакой абстрактной вертикальной заслонки, отдельного редуктора или внешней тяги нет.

В HOME полноразмерная ячейка смотрит на очередь. За 84° ячейка поворачивается к выходному скату. Тонкая продольная дуга 120–210° и рёбра образуют лёгкую наружную оболочку: когда окно ушло от очереди, эта оболочка физически держит следующую банку и при закрытии поднимает её всего на 1,4 мм.

## Печатные детали на один канал

1. `B01_ротор_лёгкая_клетка.stl` — одна деталь.
2. `B02L_полурама_SG90_клипса_A02.stl` — одна деталь.
3. `B02R_полурама_M4_клипса_A02.stl` — одна деталь.

Итого: **3 основные печатные детали/канал, 15 на пять каналов**.

## Печать

- PETG, сопло 0.4 мм, слой 0.20 мм, 4 периметра, 5 верх/низ, заполнение 25–30% gyroid.
- Полурамы уже экспортированы наружной щекой на столе: поддержки не нужны.
- Ротор уже экспортирован осью вертикально и приводной перемычкой на стол. Нужна только локальная нарисованная поддержка под верхнюю правую M4-ступицу; продольная блокирующая дуга печатается без поддержки.
- Сначала один раз на партию серв напечатать `T01_coupon_рожок_020_035_050.stl`: 1/2/3 точки означают +0.20/+0.35/+0.50 мм. Выбранный зазор перенести в параметр генератора до пяти больших роторов.
- Текущий генератор использует средний проверяемый зазор кармана **+0.35 мм** (`horn_pocket_clearance`).
- На каждый STL нужен отдельный стол 220×220. Все три файла проверяются генератором по габариту.

## Сборка одного канала

1. Вплавить одну M4 вставку только в правую ступицу ротора.
2. Один раз прогнать два M4 винта через печатные Ø3.3 пилоты губок и выкрутить обратно — отдельные вставки клипсе не нужны.
3. Установить SG90/MG90S в консоль левой полурамы двумя M2x8. Корпус сервы смотрит вниз, вал — строго по оси ротора.
4. Электрически выставить серву в HOME и обесточить сигнал PWM.
5. Поставить штатный двойной рожок горизонтально и затянуть штатный центральный винт.
6. Надвинуть карман внутренней перемычки ротора на рожок. Правую ступицу посадить в отверстие правой полурамы; утопленный M4x12 лишь удерживает ось, не зажимает её намертво.
7. Свести две полурамы по двум печатным штифтам/гнёздам.

## Крепление к общей нижней A02 — без сверления дорожки

1. Надвинуть общую переднюю C-клипсу модуля на переднюю кромку A02 до упора.
2. Проверить центр по разделителям: они только центрируют, вес на них не передаётся.
3. Подтянуть **два M4 винта снизу**, по одному на каждую полураму, через мягкие накладки. Не перетягивать.

Картонные крайние стенки не используются как силовая опора. Все пять модулей крепятся одинаково к общей A02 и не выступают за шаг 79 мм.

От готовых печатных деталей до закреплённого канала получается **10 ручных действий**: 7 сборочных выше и 3 действия крепления ниже. Coupon — отдельная одноразовая проверка на партию серв.

## Жёсткий вывод по моменту

Расчёт лежит в `FORCE_AUDIT_V11_B.csv`. Он учитывает собственную массу и эксцентриситет ротора, момент захваченной банки, силу всей очереди вдоль ската 15°, плечо наружной дуги, 12% добавку на трение, 0.010 Н·м на подшипник/уплотнения и коэффициент динамики 1.25.

| Очередь | Масса банки | Требуется |
|---:|---:|---:|
| 11 | 100 г | 3.53 кгс·см |
| 11 | 200 г | 6.71 кгс·см |
| 22 | 100 г | 6.12 кгс·см |
| 22 | 200 г | 11.88 кгс·см |

**Вердикт: напрямую нагруженную очередь из 11 или 22 банок эта схема с SG90/MG90S не тянет с инженерным запасом.** Наружная дуга действительно блокирует следующую банку, но именно поэтому вся составляющая веса очереди по скату приходит на ротор и вал сервы. Это не скрытая мелочь, а ограничение самой кинематики B.

При принятых типовых stall-значениях 1.8 кгс·см для SG90 и 2.0 кгс·см для MG90S и допустимом расчётном требовании не более 40% stall, верхняя оценка одной захваченной банки при **механически разгруженной сверху очереди** — около 62.3 г для SG90 и 75.9 г для MG90S. Значения конкретного клона надо измерить.

Серва не является самотормозящимся приводом: под нагрузкой PWM должен оставаться активным, а при пропадании питания ротор может провернуться назад. Пять серв питаются от отдельного стабилизированного 5 В источника с общей землёй ESP32; консервативный стартовый бюджет — 5 В / 5 А, затем обязательное измерение пикового тока фактической партии.

## Обязательная проверка прототипа

Этот B печатать сначала **только в одном экземпляре** и только как эксперимент с разгрузкой очереди. Без банок выполнить 20 медленных циклов 0→84→0°, затем 300 циклов с реальной банкой допустимой массы. Для штатных 100–200 г и очереди 11/22 сразу выбирать другой механизм, который механически снимает нагрузку с сервы.
