BZKDP/dozator-bad/gate12_5servo_direct_esp32/ПРОВЕРКА_HTML.png

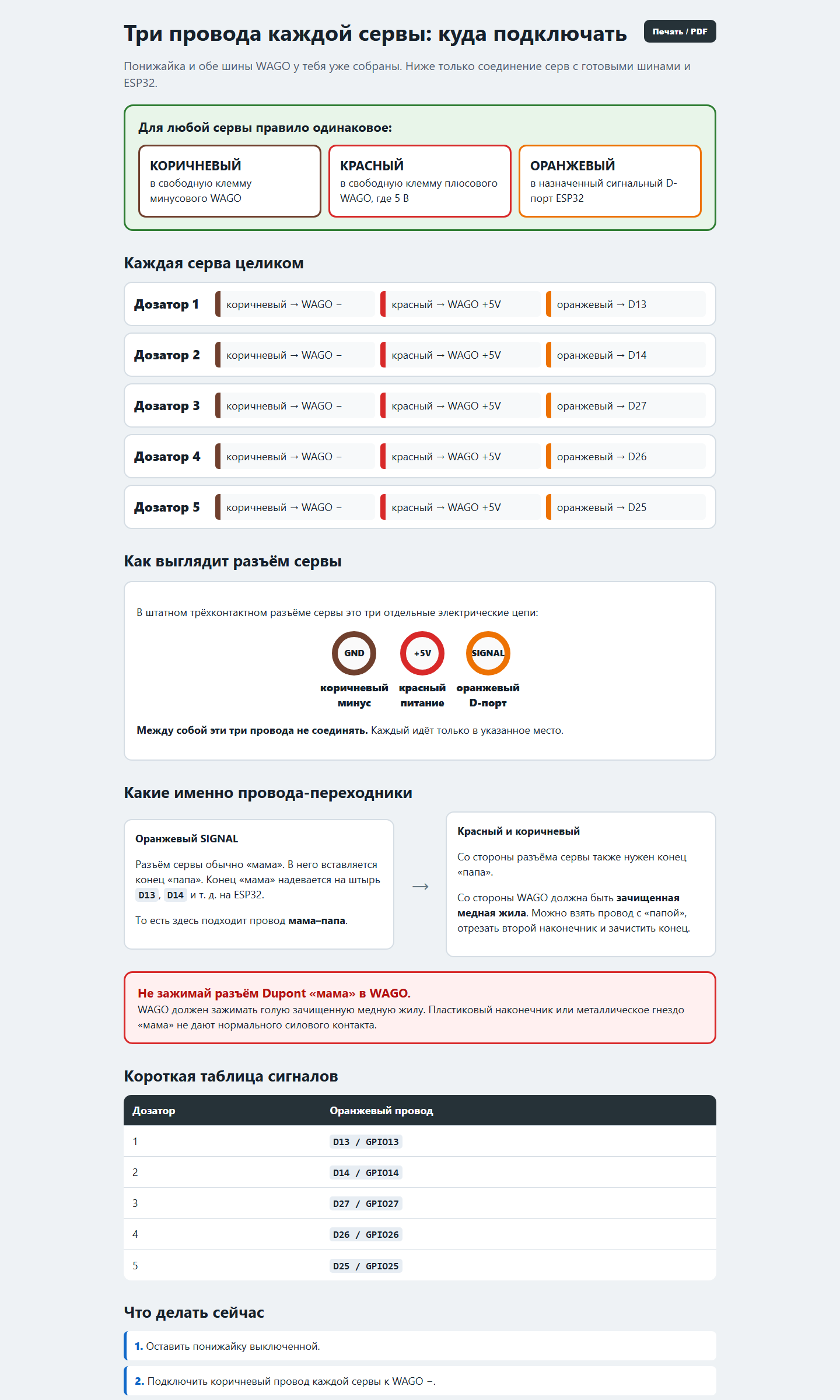
gate12_5servo_direct_esp32/ПРОВЕРКА_HTML.png
