BZKDP/dozator-bad/gate12_5servo_pca9685/СХЕМА_5_СЕРВО_PCA9685.png

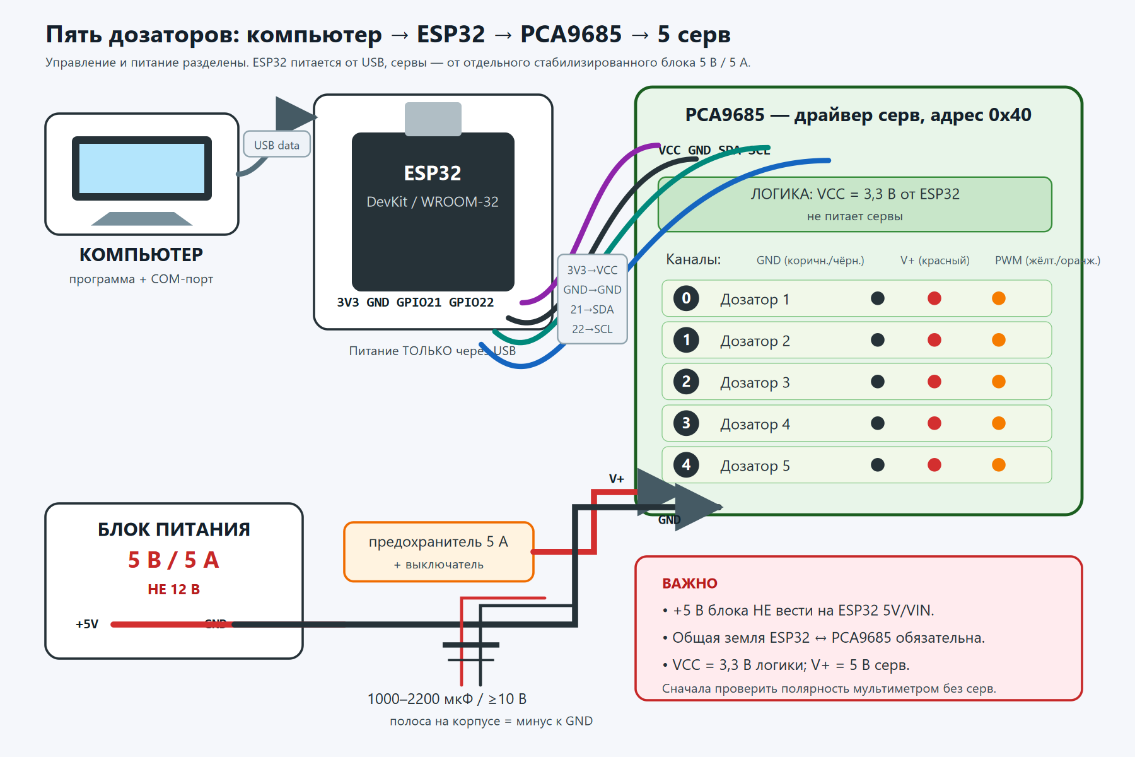
gate12_5servo_pca9685/СХЕМА_5_СЕРВО_PCA9685.png
