BZKDP/dozator-bad/stl_gate12/_check_v4.png

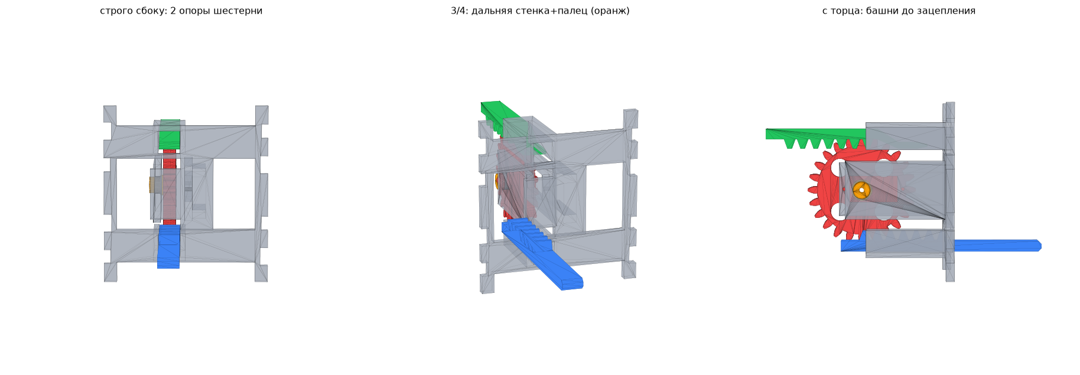
stl_gate12/_check_v4.png
