BZKDP/dozator-bad/stl_gate12_SG90_backup/_check_current.png

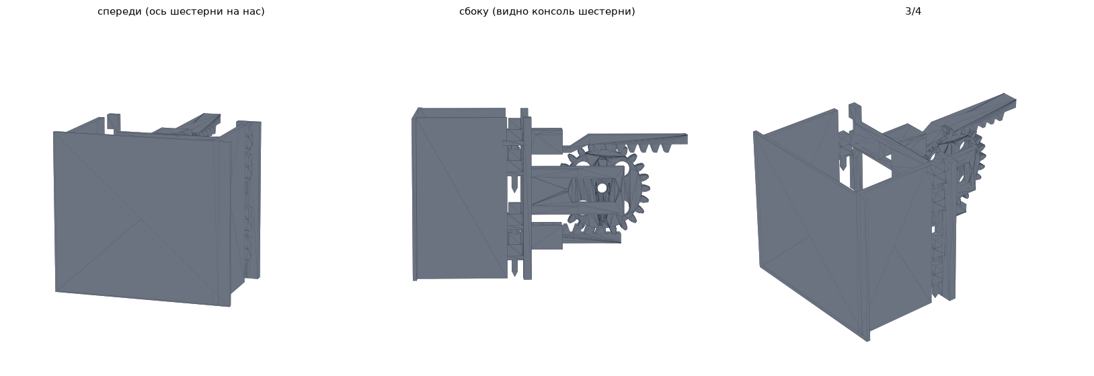
stl_gate12_SG90_backup/_check_current.png
