BZKDP/dozator-bad/v9_без_клея_переработка/_черновики/ПРОВЕРКА_3D_старая.png

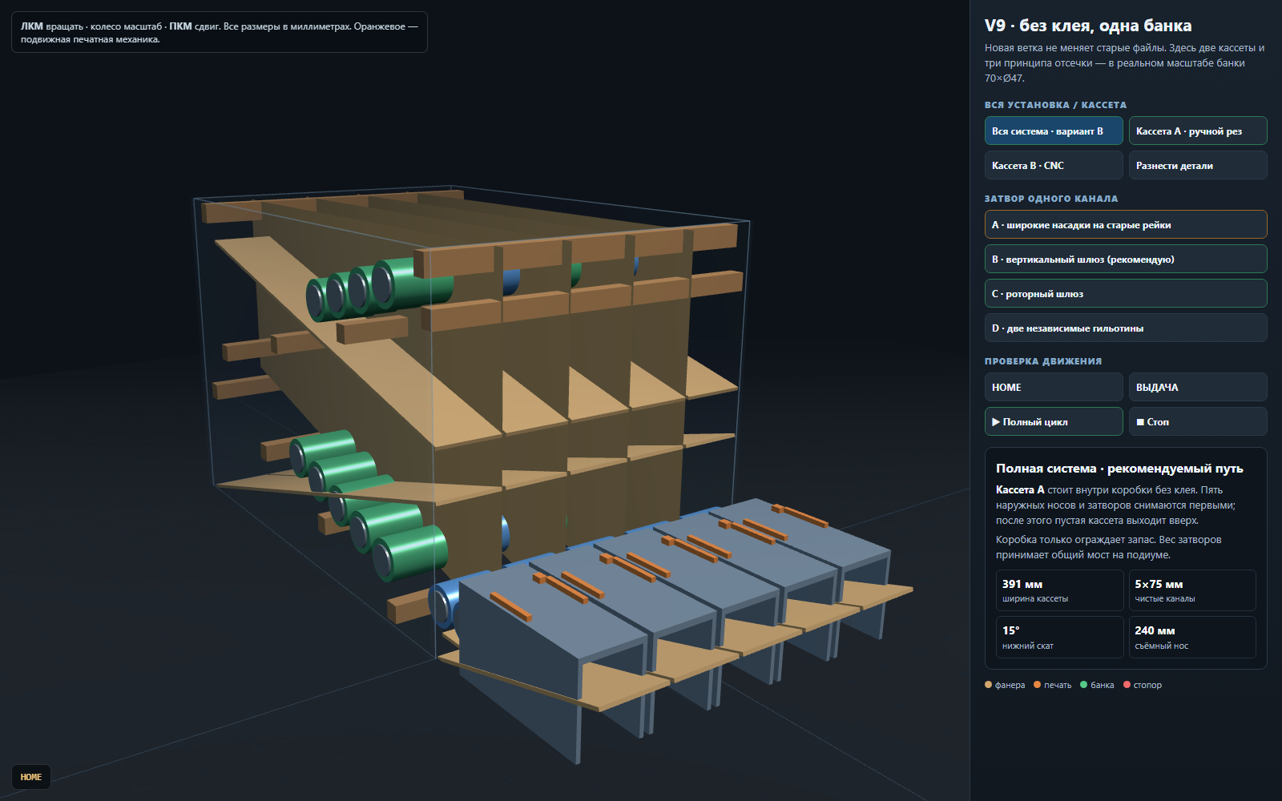
v9_без_клея_переработка/_черновики/ПРОВЕРКА_3D_старая.png
