BZKDP/dozator-bad/v13_открытая_кассета/ПРЕВЬЮ_V13.png

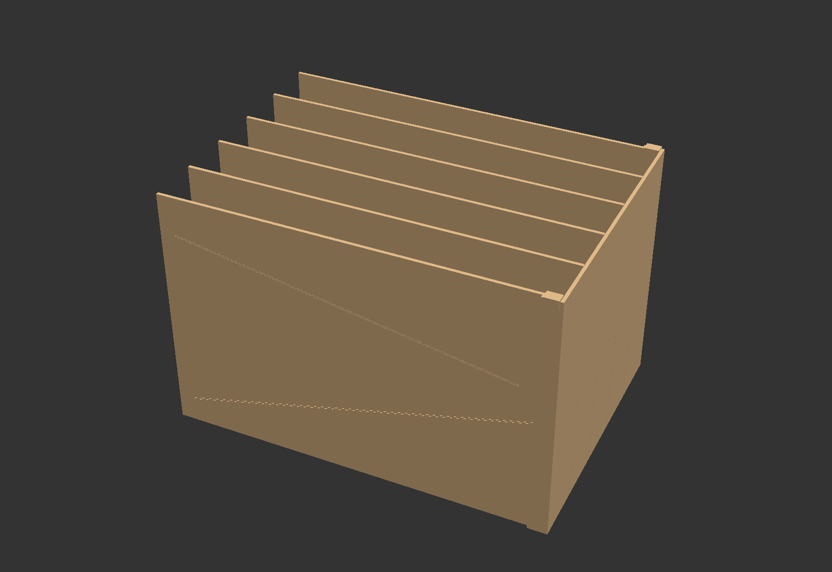
v13_открытая_кассета/ПРЕВЬЮ_V13.png
