BZKDP/dozator-bad/v14_кассета_ПНД4/АУДИТ_2026-09-30/ПРОБЛЕМЫ_ГЕОМЕТРИИ.png

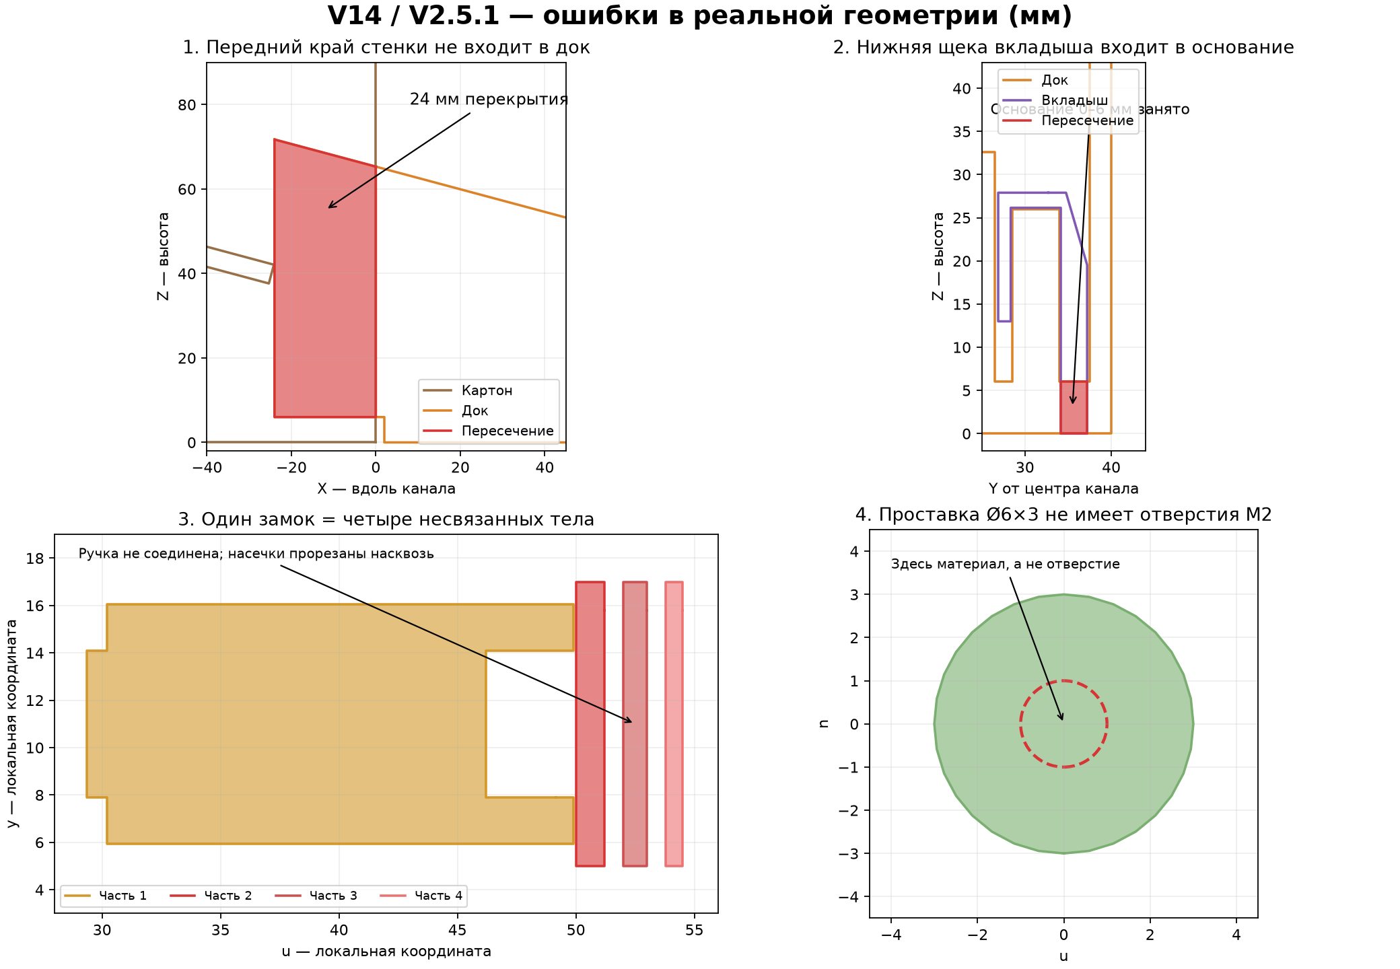
v14_кассета_ПНД4/АУДИТ_2026-09-30/ПРОБЛЕМЫ_ГЕОМЕТРИИ.png
