BZKDP/dozator-bad/v14_кассета_ПНД4/АУДИТ_2026-09-30_125/audit-125.png

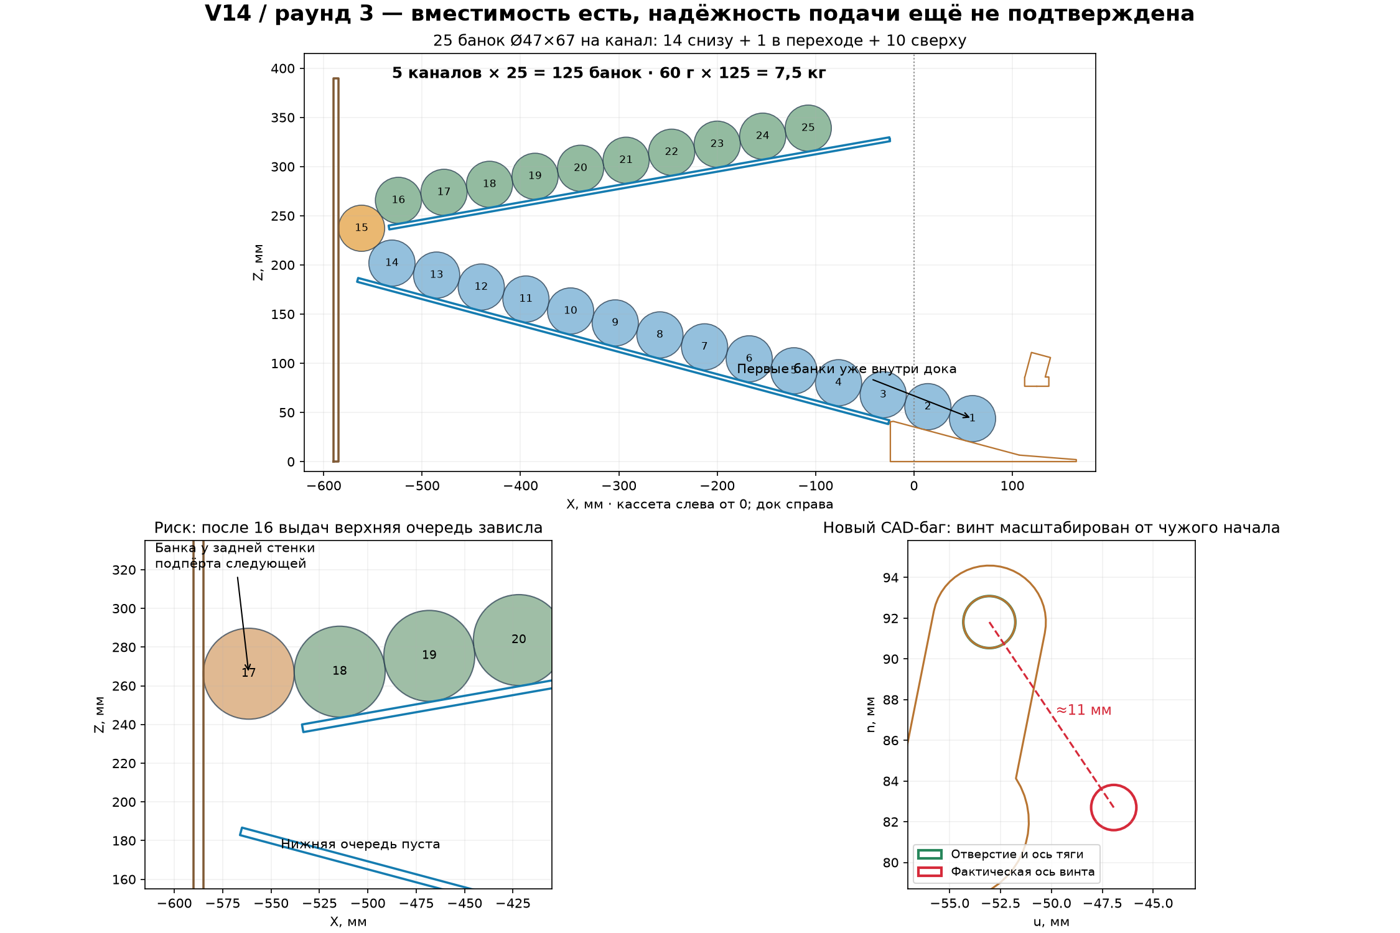
v14_кассета_ПНД4/АУДИТ_2026-09-30_125/audit-125.png
