BZKDP/dozator-bad/v11_три_варианта/A_верхнее_коромысло/BOM_вариант_A.csv

Код | Наименование | Количество | Материал | Примечание
A01 | Рама с упорами и защёлкой SG90 | 5 | PETG | 1 на канал; печать внешней плоскостью вниз
A02 | Коромысло с 2 округлыми пальцами | 5 | PETG/PA | 1 на канал; пальцы печатаются вертикально
A03 | Короткая тяга 11.63 мм | 5 | PETG/PA | 1 на канал; один конец защёлкивается
A04 | Нижний прижим передней кромки ската | 5 | PETG | 1 на канал; два M4, лист не сверлить
S01 | SG90 или MG90S + штатная двойная качалка | 5 | имеется у владельца | внешнее отверстие horn около 9 мм
H01 | M4 переплётный винт/shoulder post, рабочая длина 4.5–5 мм | 5 | сталь | главный pivot; тонкие фланцы
H02 | M4×16 винт + самоконтрящаяся гайка | 10 | сталь | 2 на канал: без отверстий в скате, за его передней кромкой
H03 | M2 шарнирный винт/палец Ø2×6 с гладкой рабочей шейкой и фиксатором | 5 | сталь | гладкая шейка работает в Ø2.3 отверстии A03; резьба не должна тереть PETG
H04 | Штатный винт качалки к шлицу сервы | 5 | из комплекта SG90/MG90S | повторно использовать; отдельная покупка не нужна
E01 | Резистор 10 кОм 0.125–0.25 Вт | 5 | электроника | сигнал каждой сервы → GND; исключает плавающий вход при старте ESP32
C01 | Нижний скат 15° | 1 | берёзовая фанера 4 мм | примерно 590×391; без силовой балки снизу
C02 | Внутренний разделитель канала | 4 | берёзовая фанера 4 мм | чистый канал 75 мм; только боковое направление банок
C03 | Боковые стенки коробки | 2 | существующая коробка/фанера | работают как крайние разделители
L01 | UHMW/PET самоклеящаяся лента | 5 | опционально | полоса по дорожке уменьшает зависание последней банки
