BZKDP/dozator-bad/v11_три_варианта/C_верхние_линейные_ножи/BOM_C2.csv

Код | Деталь | Количество на канал | Материал | Примечание
C01 | Верхняя рама-направляющая с дорожкой и зажимом ската | 1 | PETG | печатается боковой спиной без поддержек
C02 | Передняя прямая заслонка | 1 | PETG | оранжевая; HOME закрыта
C03 | Задний прямой сепаратор | 1 | PETG | бирюзовый; EJECT закрыт
C04 | Длинное коромысло под штатную качалку | 1 | PETG | радиус пинов 31.383 мм
C05 | Плоский кронштейн сервы с двумя монтажными лапками | 1 | PETG | печатается широкой стенкой на столе
T01 | Купон кармана штатной качалки | 0 | PETG | 1 на партию одинаковых серв/филамента; не на каждый канал
H01 | SG90 или MG90S + штатная двойная качалка | 1 | готовая | существующая серва
H02 | Винт-ось M3x18 с гладкой рабочей шейкой Ø3 + шайба + гайка DIN934 | 2 | металл | резьба не должна тереться о PETG-паз; фиксатор только plastic-safe либо контрольная метка лаком
H03 | M2x10 самонарезающий | 2 | металл | серва крепится к печатным пилотам C05; без гаек
H04 | M3x10 прижимной винт | 2 | металл | снизу прижимает целую фанеру к верхним губкам
H05 | Штатный центральный винт качалки | 1 | комплект сервы | C04 к качалке
H06 | M2x10 самонарезающий + шайба для C05 | 2 | металл | одной сгруппированной операцией крепят C05 к C01
E01 | Резистор 10 кОм сигнал-GND | 1 | электроника | исключает плавающий сигнал до старта ESP32
