BZKDP/dozator-bad/v11_три_варианта/B_роторная_кассета/REJECTED_DIRECT_DRIVE/STL_СБОРКА_НЕ_ПЕЧАТАТЬ/assembly_HOME_with_3_cans.stl

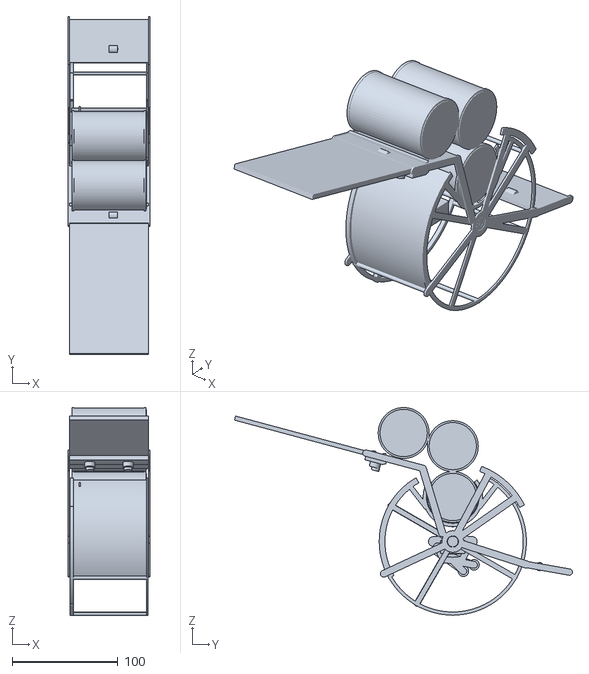
[picture p11: CAD file, 2026-10-12]
v11_три_варианта/B_роторная_кассета/REJECTED_DIRECT_DRIVE/STL_СБОРКА_НЕ_ПЕЧАТАТЬ/assembly_HOME_with_3_cans.stl
77.3 x 319.0 x 196.3
