BZKDP/dozator-bad/v11_три_варианта/B_роторная_кассета/STL_СБОРКА_НЕ_ПЕЧАТАТЬ/assembly_HOME_with_3_cans.stl

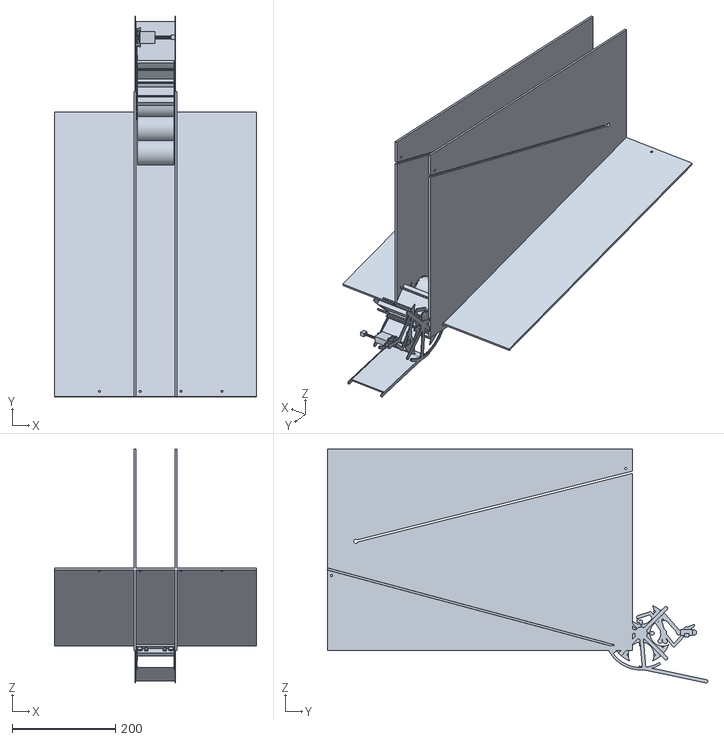
[picture p12: CAD file, 2026-10-12]
v11_три_варианта/B_роторная_кассета/STL_СБОРКА_НЕ_ПЕЧАТАТЬ/assembly_HOME_with_3_cans.stl
391.0 x 736.2 x 452.4
