BZKDP/dozator-bad/v11_три_варианта/REJECTED_C_опрокидывающаяся_люлька_НЕ_ПЕЧАТАТЬ/STL_СБОРКА_НЕ_ПЕЧАТАТЬ/C_EJECT_complete.stl

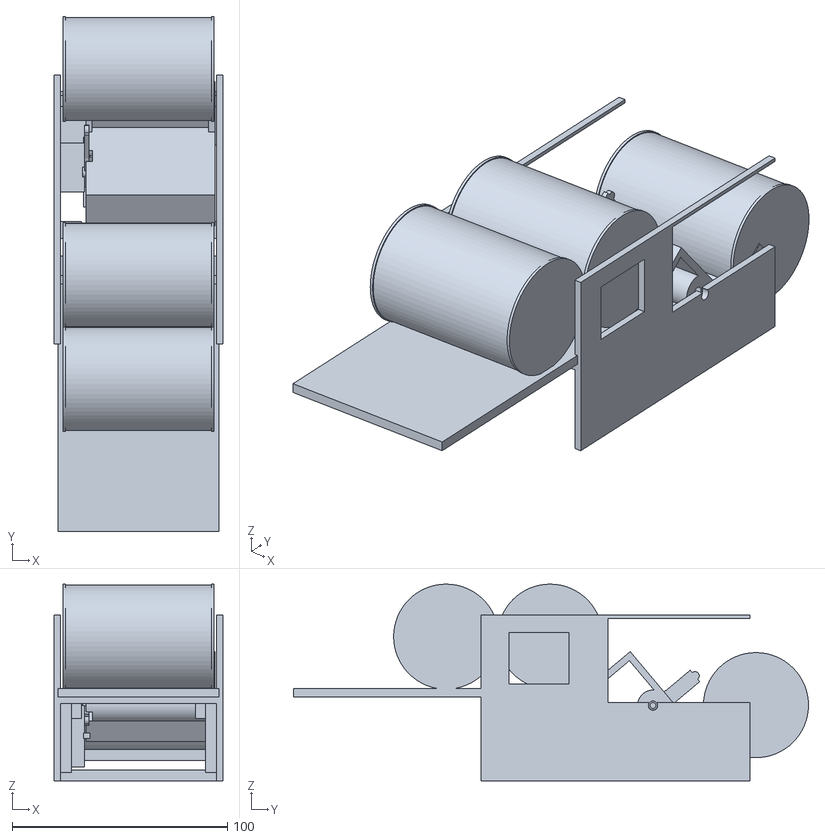
[picture p13: CAD file, 2026-10-12]
v11_три_варианта/REJECTED_C_опрокидывающаяся_люлька_НЕ_ПЕЧАТАТЬ/STL_СБОРКА_НЕ_ПЕЧАТАТЬ/C_EJECT_complete.stl
78.4 x 239.2 x 91.4
