BZKDP/dozator-bad/stl_gate12/assembly_view.stl

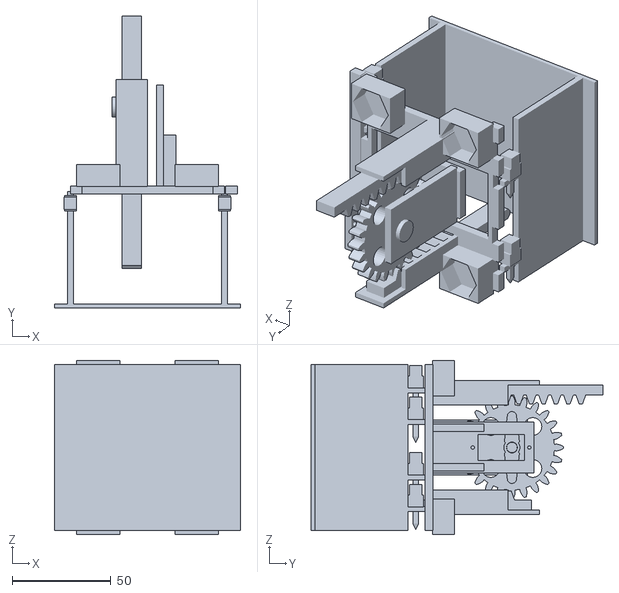
[picture p14: CAD file, 2026-10-12]
stl_gate12/assembly_view.stl
94.0 x 147.5 x 88.0
