BZKDP/dozator-bad/v11_три_варианта/B_роторная_кассета/REJECTED_DIRECT_DRIVE/STL_СБОРКА_НЕ_ПЕЧАТАТЬ/frame_right_assembly.stl

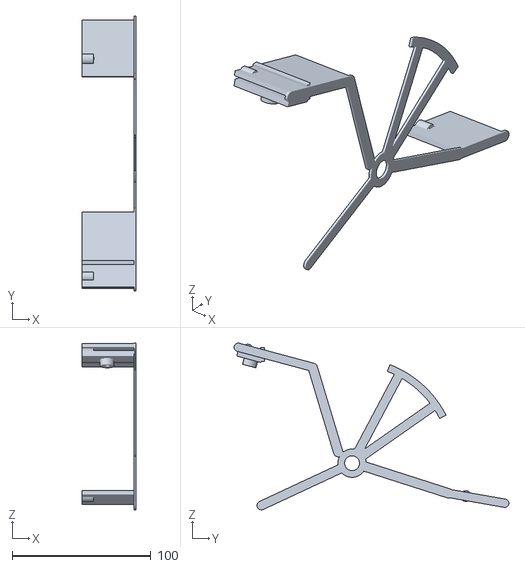
[picture p15: CAD file, 2026-10-12]
v11_три_варианта/B_роторная_кассета/REJECTED_DIRECT_DRIVE/STL_СБОРКА_НЕ_ПЕЧАТАТЬ/frame_right_assembly.stl
38.7 x 198.0 x 120.1
