BZKDP/dozator-bad/v11_три_варианта/C_верхние_линейные_ножи/STL_СБОРКА_НЕ_ПЕЧАТАТЬ/C2_EJECT_complete.stl

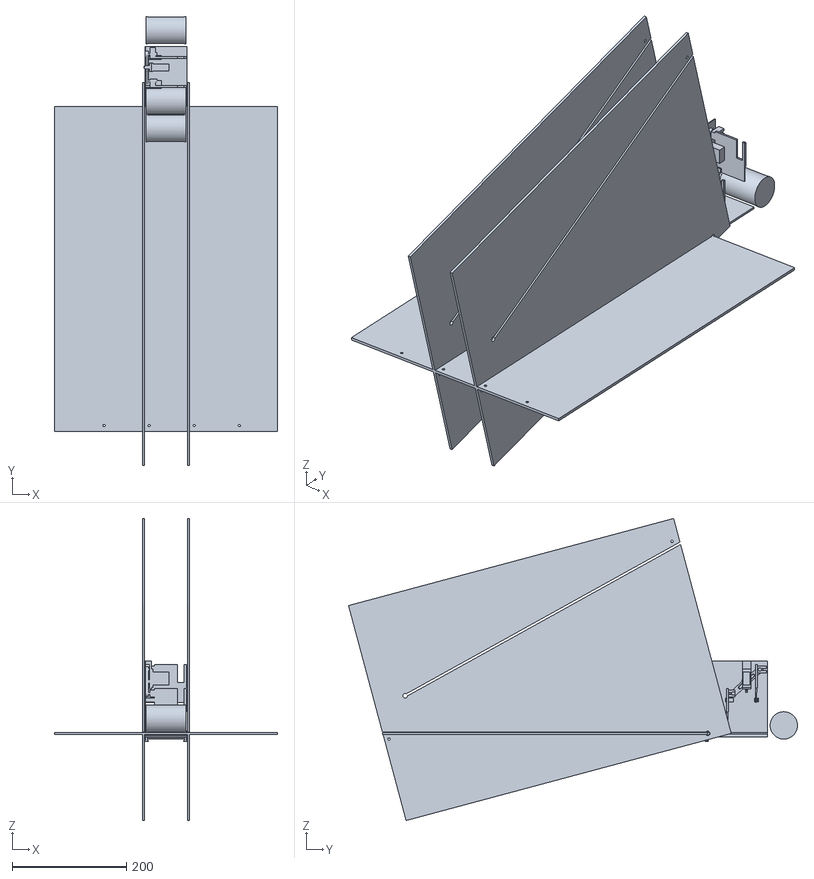
[picture p16: CAD file, 2026-10-12]
v11_три_варианта/C_верхние_линейные_ножи/STL_СБОРКА_НЕ_ПЕЧАТАТЬ/C2_EJECT_complete.stl
391.0 x 786.9 x 529.4
