BZKDP/dozator-bad/v11_три_варианта/REJECTED_C_опрокидывающаяся_люлька_НЕ_ПЕЧАТАТЬ/STL_СБОРКА_НЕ_ПЕЧАТАТЬ/C_HOME_complete.stl

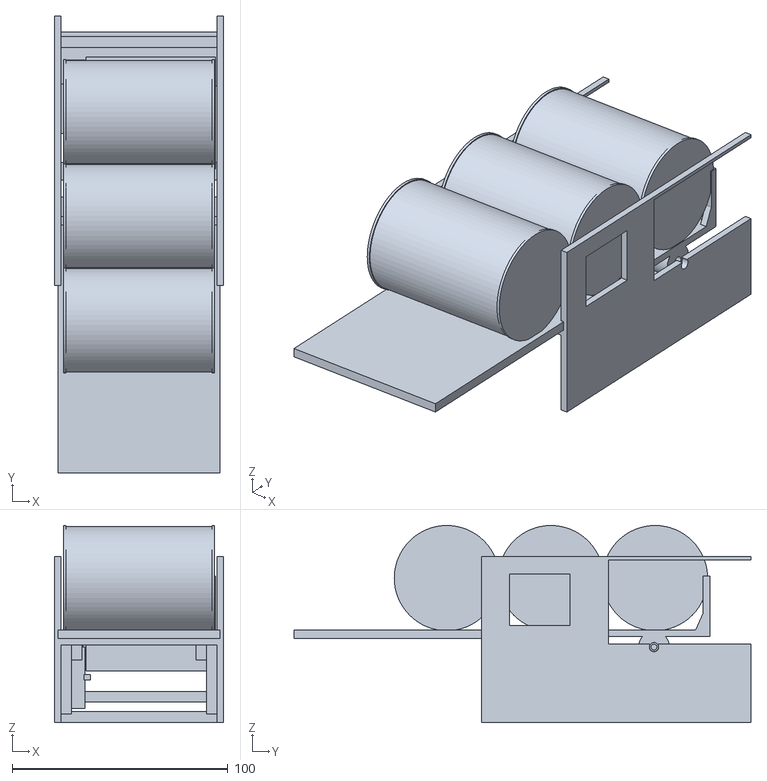
[picture p17: CAD file, 2026-10-12]
v11_три_варианта/REJECTED_C_опрокидывающаяся_люлька_НЕ_ПЕЧАТАТЬ/STL_СБОРКА_НЕ_ПЕЧАТАТЬ/C_HOME_complete.stl
78.4 x 212.0 x 91.4
