BZKDP/dozator-bad/stl_gate12_MG996R_backup/assembly_view.stl

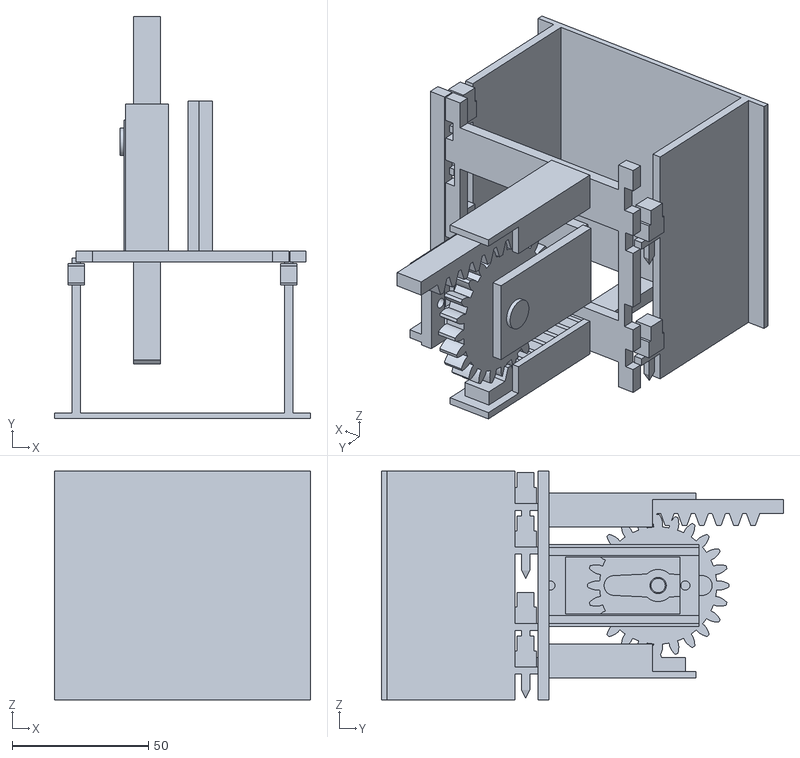
[picture p18: CAD file, 2026-10-12]
stl_gate12_MG996R_backup/assembly_view.stl
94.0 x 147.5 x 84.0
