BZKDP/dozator-bad/v11_три_варианта/C_верхние_линейные_ножи/STL_СБОРКА_НЕ_ПЕЧАТАТЬ/C2_MID_complete.stl

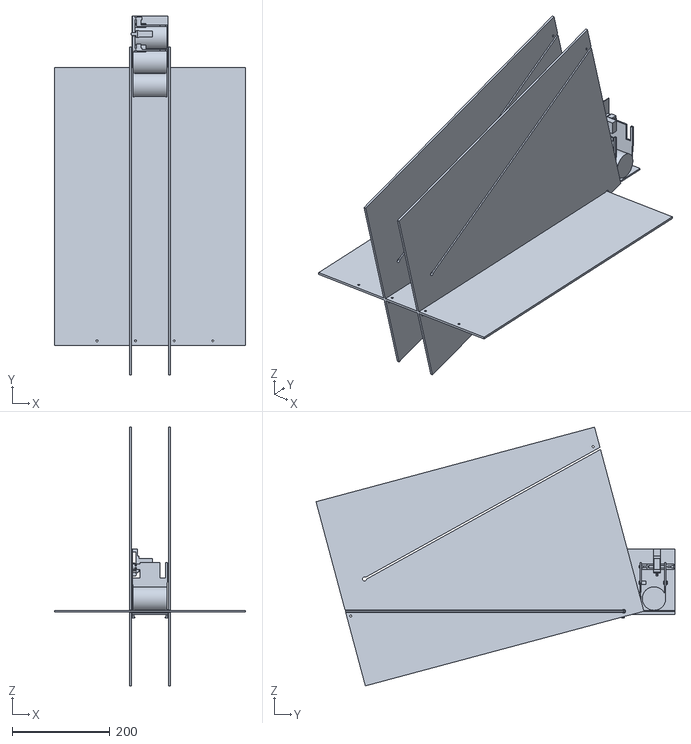
[picture p19: CAD file, 2026-10-12]
v11_три_варианта/C_верхние_линейные_ножи/STL_СБОРКА_НЕ_ПЕЧАТАТЬ/C2_MID_complete.stl
391.0 x 734.5 x 529.4
