BZKDP/dozator-bad/stl_gate12_flat_daggers/gate12_daggers_flat_20pcs.stl

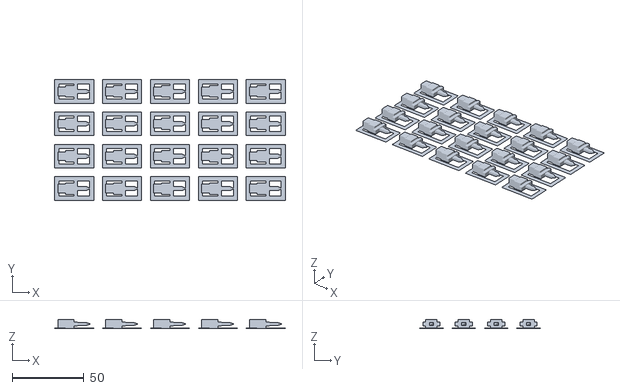
[picture p21: CAD file, 2026-10-12]
stl_gate12_flat_daggers/gate12_daggers_flat_20pcs.stl
161.2 x 84.4 x 6.20
