BZKDP/dozator-bad/stl_gate12_MG996R_backup/chassis.stl

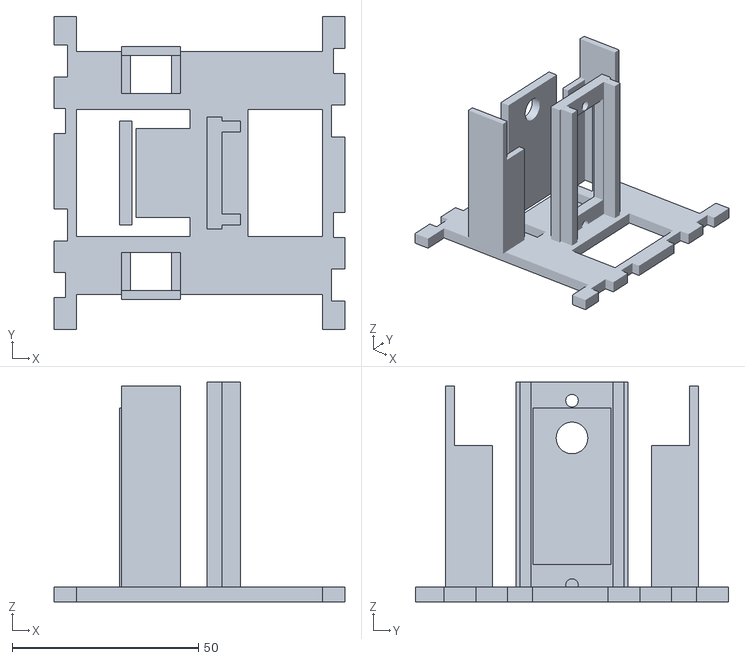
[picture p22: CAD file, 2026-10-12]
stl_gate12_MG996R_backup/chassis.stl
78.0 x 84.0 x 59.0
