BZKDP/dozator-bad/v10_производственная_модель/STL_ПЕЧАТЬ/A04L_замок_нижнего_ската_15град.stl

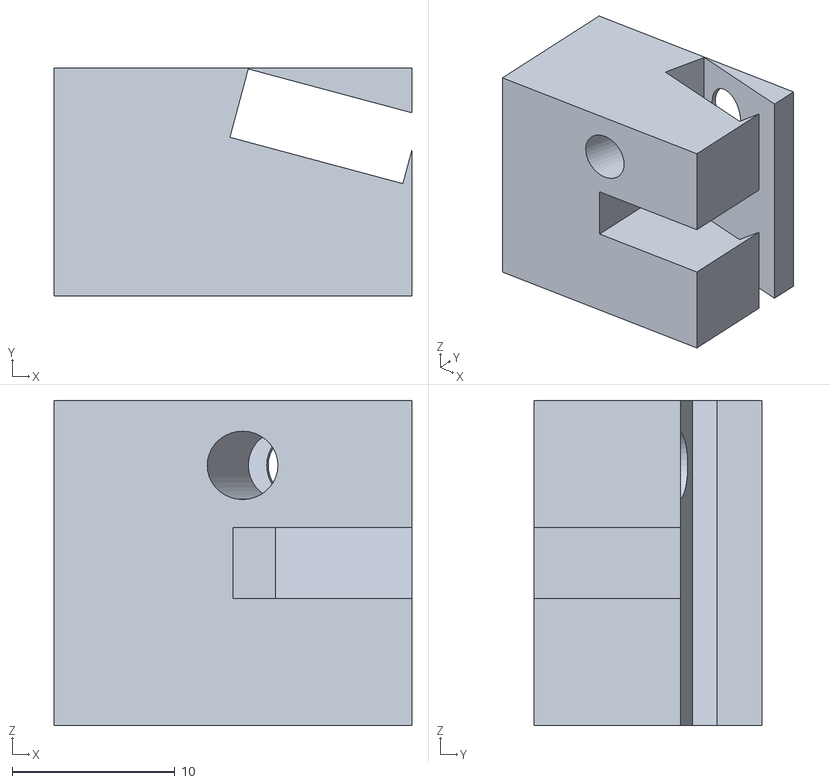
[picture p23: CAD file, 2026-10-12]
v10_производственная_модель/STL_ПЕЧАТЬ/A04L_замок_нижнего_ската_15град.stl
22.0 x 14.0 x 20.0
