BZKDP/dozator-bad/v10_производственная_модель/РАСКРОЙ_6_ЛИСТОВ/02_НИЖНИЙ_ЦЕЛЬНЫЙ_ЛИСТ_1шт.dxf

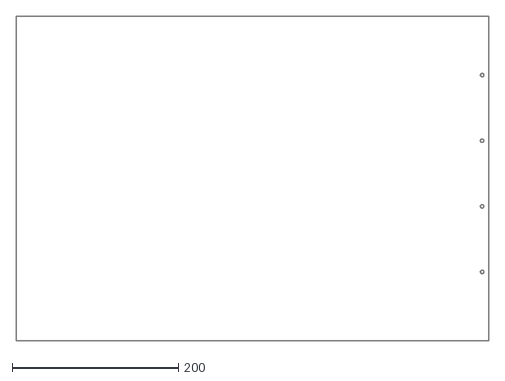
[picture p24: CAD file, 2026-10-12]
v10_производственная_модель/РАСКРОЙ_6_ЛИСТОВ/02_НИЖНИЙ_ЦЕЛЬНЫЙ_ЛИСТ_1шт.dxf
569.4 x 391.0
