BZKDP/dozator-bad/v11_три_варианта/00_ОБЩАЯ_КОМПОНОВКА/STL_ЗАМКИ_СБОРКА/фиксаторы_нижнего_ската_4шт_world_V11.stl

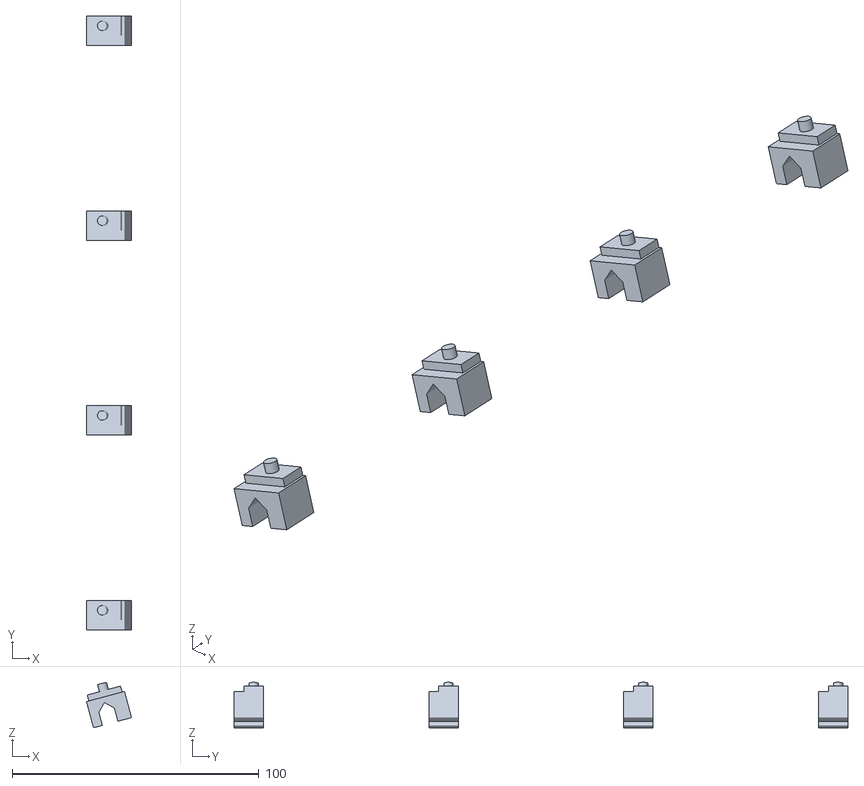
[picture p25: CAD file, 2026-10-12]
v11_три_варианта/00_ОБЩАЯ_КОМПОНОВКА/STL_ЗАМКИ_СБОРКА/фиксаторы_нижнего_ската_4шт_world_V11.stl
18.3 x 249.0 x 18.5
