BZKDP/dozator-bad/v11_три_варианта/00_ОБЩАЯ_КОМПОНОВКА/STL_КАССЕТА_СБОРКА/cassette_divider.stl

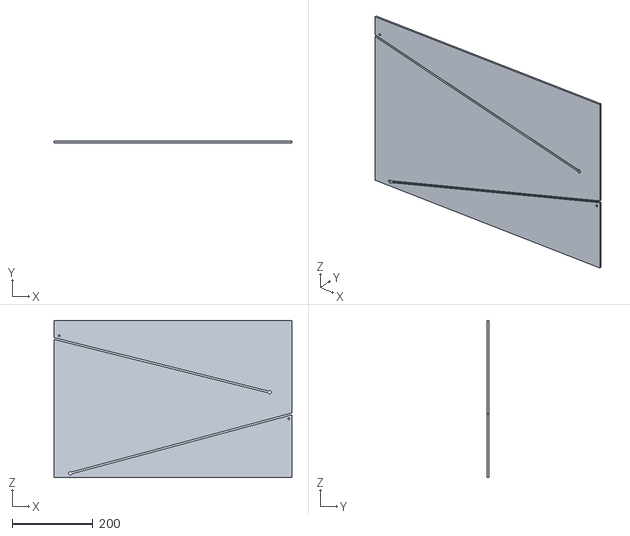
[picture p26: CAD file, 2026-10-12]
v11_три_варианта/00_ОБЩАЯ_КОМПОНОВКА/STL_КАССЕТА_СБОРКА/cassette_divider.stl
590.0 x 4.00 x 390.0
