BZKDP/dozator-bad/v11_три_варианта/00_ОБЩАЯ_КОМПОНОВКА/STL_ПЕЧАТЬ/фиксатор_ската_универсальный_V11_PRINT.stl

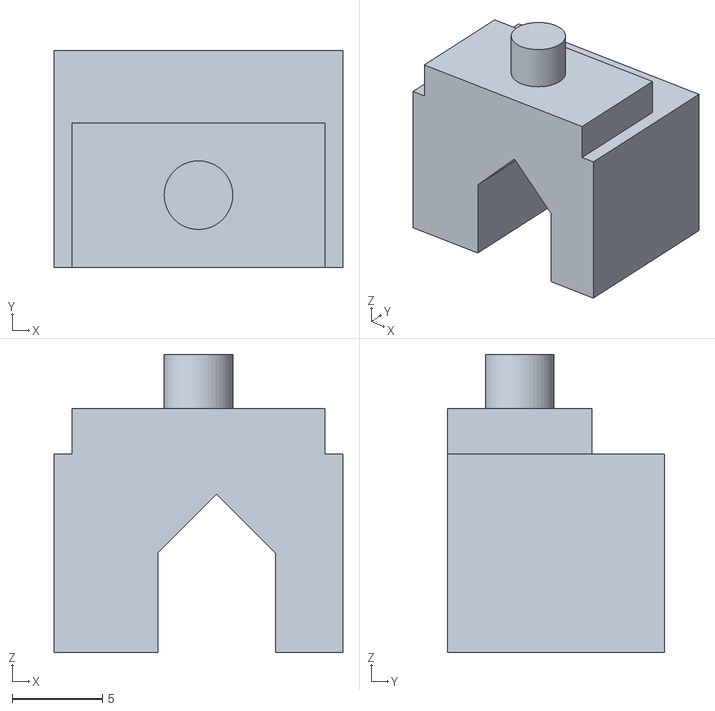
[picture p27: CAD file, 2026-10-12]
v11_три_варианта/00_ОБЩАЯ_КОМПОНОВКА/STL_ПЕЧАТЬ/фиксатор_ската_универсальный_V11_PRINT.stl
16.0 x 12.0 x 16.5
