BZKDP/dozator-bad/v11_три_варианта/00_ОБЩАЯ_КОМПОНОВКА/РАСКРОЙ_6_ЛИСТОВ/01_РАЗДЕЛИТЕЛЬ_РУЧНОЙ_зазор_0.45_4шт.dxf

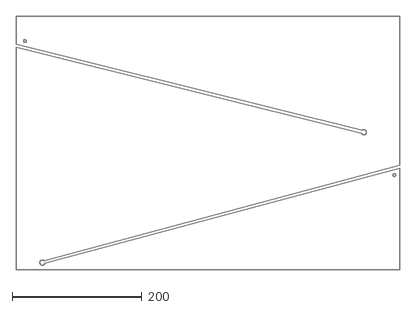
[picture p28: CAD file, 2026-10-12]
v11_три_варианта/00_ОБЩАЯ_КОМПОНОВКА/РАСКРОЙ_6_ЛИСТОВ/01_РАЗДЕЛИТЕЛЬ_РУЧНОЙ_зазор_0.45_4шт.dxf
590.0 x 390.0
