BZKDP/dozator-bad/v11_три_варианта/A_верхнее_коромысло/STL_ПЕЧАТЬ/A02_коромысло_с_2_пальцами.stl

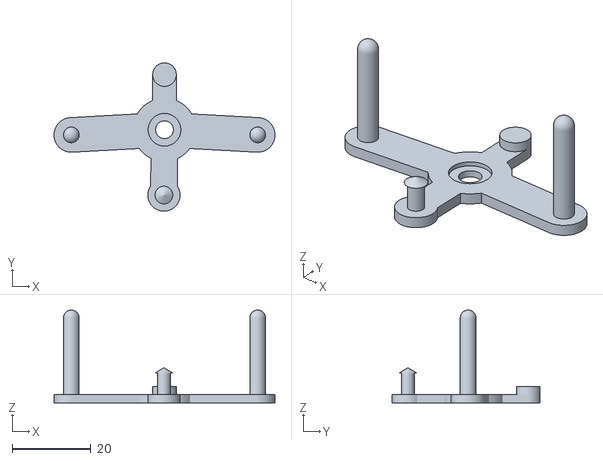
[picture p29: CAD file, 2026-10-12]
v11_три_варианта/A_верхнее_коромысло/STL_ПЕЧАТЬ/A02_коромысло_с_2_пальцами.stl
56.1 x 37.7 x 23.6
