BZKDP/dozator-bad/v11_три_варианта/A_верхнее_коромысло/STL_СБОРКА_НЕ_ПЕЧАТАТЬ/A_VIEW_MID_rocker.stl

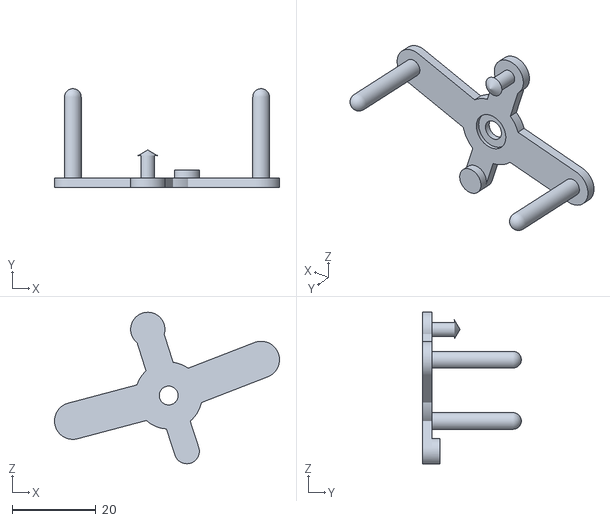
[picture p30: CAD file, 2026-10-12]
v11_три_варианта/A_верхнее_коромысло/STL_СБОРКА_НЕ_ПЕЧАТАТЬ/A_VIEW_MID_rocker.stl
53.8 x 23.6 x 36.2
