BZKDP/dozator-bad/v11_три_варианта/B_роторная_кассета/REJECTED_DIRECT_DRIVE/STL_ПЕЧАТЬ/T01_coupon_рожок_020_035_050.stl

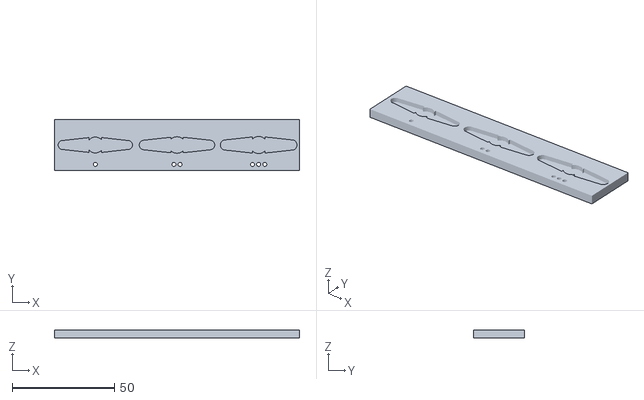
[picture p31: CAD file, 2026-10-12]
v11_три_варианта/B_роторная_кассета/REJECTED_DIRECT_DRIVE/STL_ПЕЧАТЬ/T01_coupon_рожок_020_035_050.stl
120.0 x 25.0 x 4.00
