BZKDP/dozator-bad/v11_три_варианта/B_роторная_кассета/REJECTED_DIRECT_DRIVE/STL_СБОРКА_НЕ_ПЕЧАТАТЬ/EJECT/right_M4_retainer.stl

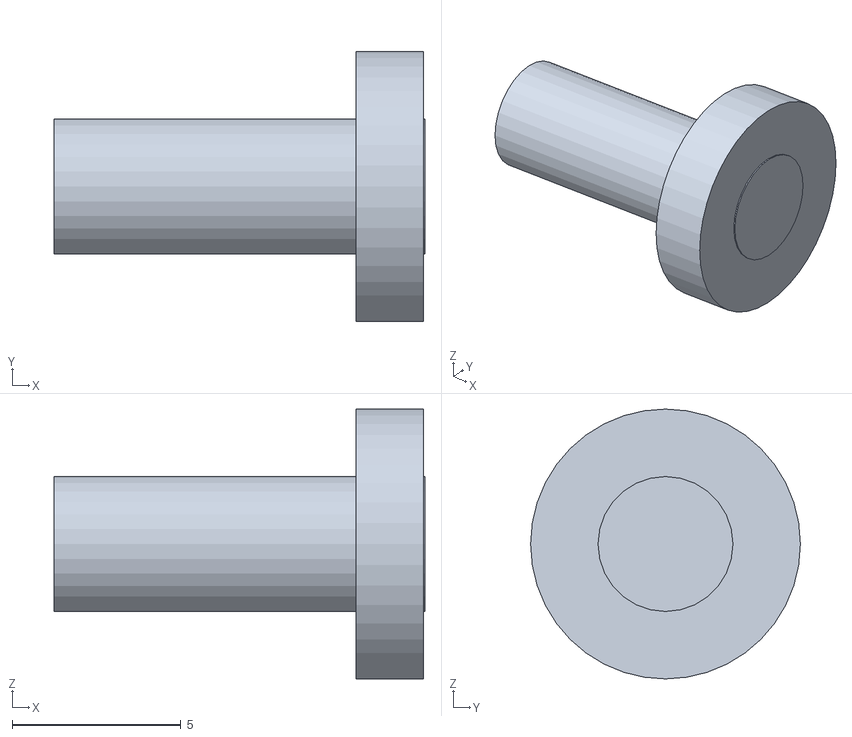
[picture p32: CAD file, 2026-10-12]
v11_три_варианта/B_роторная_кассета/REJECTED_DIRECT_DRIVE/STL_СБОРКА_НЕ_ПЕЧАТАТЬ/EJECT/right_M4_retainer.stl
11.0 x 8.00 x 8.00
