BZKDP/dozator-bad/v11_три_варианта/B_роторная_кассета/REJECTED_DIRECT_DRIVE/STL_СБОРКА_НЕ_ПЕЧАТАТЬ/HOME/frame_left.stl

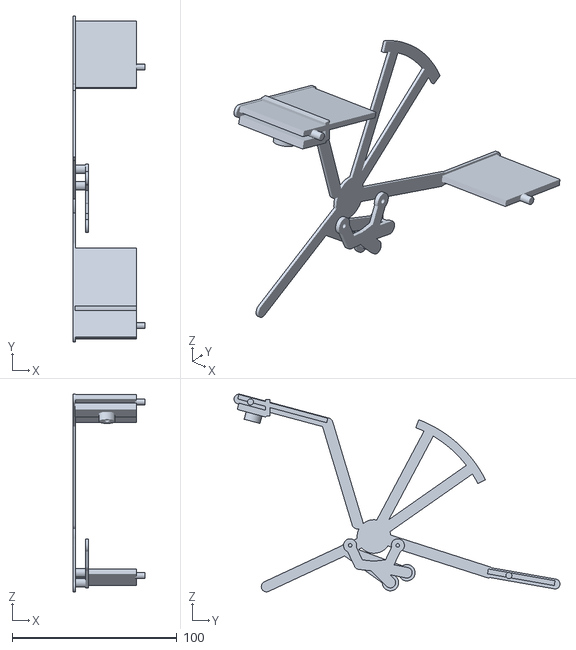
[picture p33: CAD file, 2026-10-12]
v11_три_варианта/B_роторная_кассета/REJECTED_DIRECT_DRIVE/STL_СБОРКА_НЕ_ПЕЧАТАТЬ/HOME/frame_left.stl
43.8 x 198.0 x 120.1
