BZKDP/dozator-bad/v11_три_варианта/B_роторная_кассета/REJECTED_DIRECT_DRIVE/STL_СБОРКА_НЕ_ПЕЧАТАТЬ/MID/rotor.stl

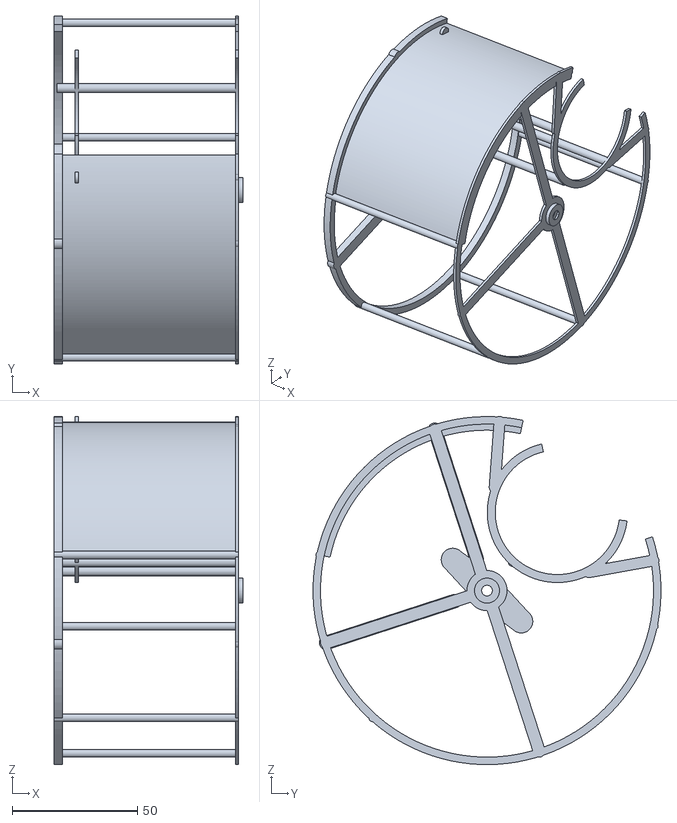
[picture p34: CAD file, 2026-10-12]
v11_три_варианта/B_роторная_кассета/REJECTED_DIRECT_DRIVE/STL_СБОРКА_НЕ_ПЕЧАТАТЬ/MID/rotor.stl
75.3 x 138.9 x 139.0
