BZKDP/dozator-bad/v11_три_варианта/B_роторная_кассета/STL_ПЕЧАТЬ/T01_coupon_ось_собачки_020_035_050.stl

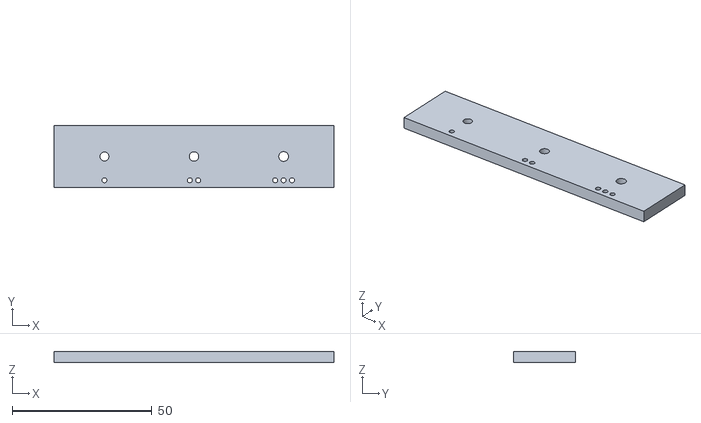
[picture p35: CAD file, 2026-10-12]
v11_три_варианта/B_роторная_кассета/STL_ПЕЧАТЬ/T01_coupon_ось_собачки_020_035_050.stl
100.0 x 22.0 x 4.00
