BZKDP/dozator-bad/v11_три_варианта/B_роторная_кассета/STL_СБОРКА_НЕ_ПЕЧАТАТЬ/EJECT/gravity_pawl.stl

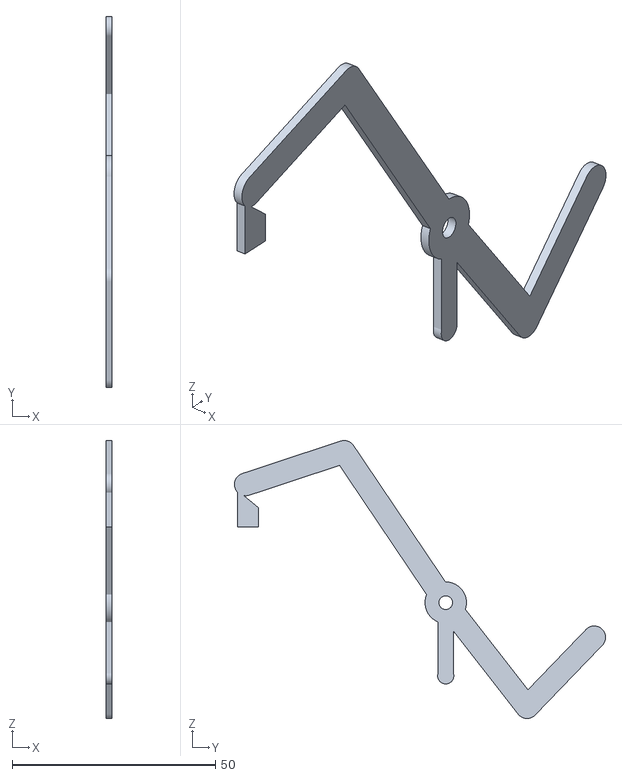
[picture p36: CAD file, 2026-10-12]
v11_три_варианта/B_роторная_кассета/STL_СБОРКА_НЕ_ПЕЧАТАТЬ/EJECT/gravity_pawl.stl
1.55 x 91.3 x 68.4
