BZKDP/dozator-bad/v11_три_варианта/B_роторная_кассета/STL_СБОРКА_НЕ_ПЕЧАТАТЬ/HOME/can_indexed.stl

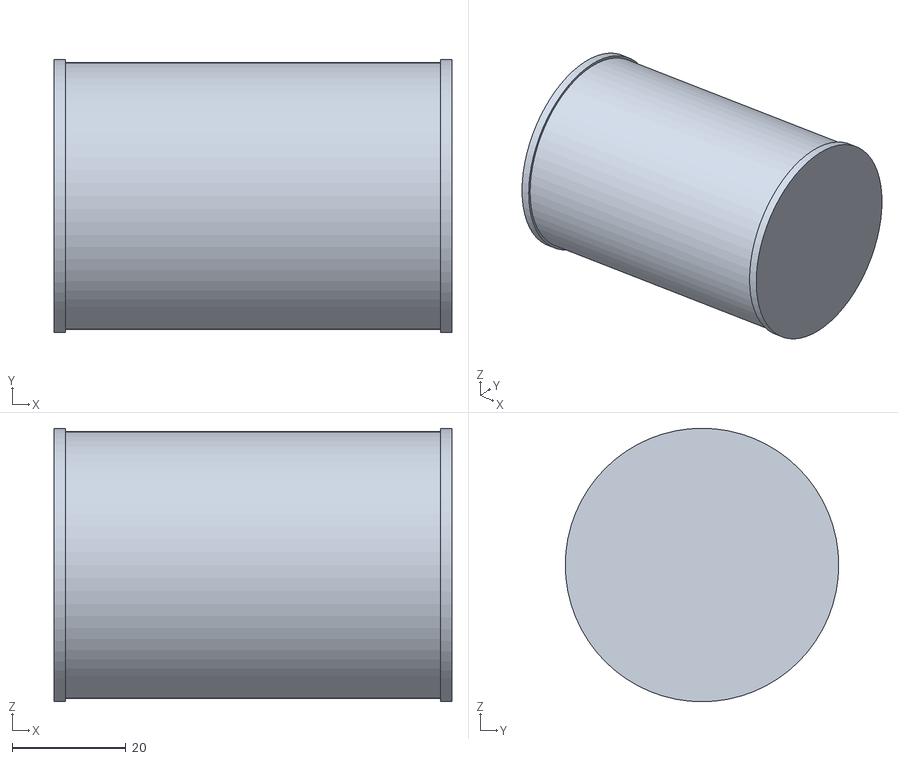
[picture p37: CAD file, 2026-10-12]
v11_три_варианта/B_роторная_кассета/STL_СБОРКА_НЕ_ПЕЧАТАТЬ/HOME/can_indexed.stl
70.0 x 48.1 x 48.1
