BZKDP/dozator-bad/v11_три_варианта/B_роторная_кассета/STL_СБОРКА_НЕ_ПЕЧАТАТЬ/MID/wire_orange.stl

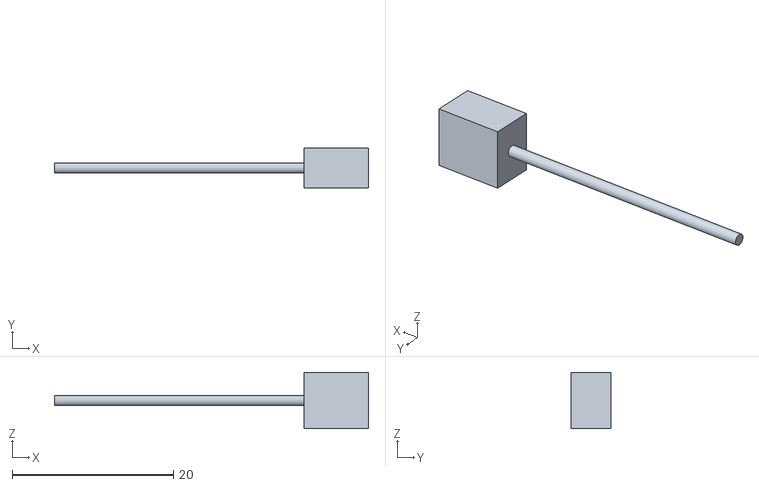
[picture p38: CAD file, 2026-10-12]
v11_три_варианта/B_роторная_кассета/STL_СБОРКА_НЕ_ПЕЧАТАТЬ/MID/wire_orange.stl
39.0 x 5.00 x 7.00
