BZKDP/dozator-bad/v11_три_варианта/C_верхние_линейные_ножи/STL_ПЕЧАТЬ/C05_плоский_кронштейн_сервы.stl

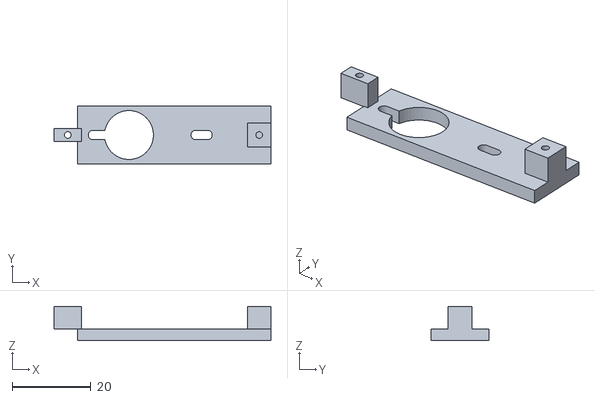
[picture p39: CAD file, 2026-10-12]
v11_три_варианта/C_верхние_линейные_ножи/STL_ПЕЧАТЬ/C05_плоский_кронштейн_сервы.stl
55.0 x 14.8 x 8.70
