BZKDP/dozator-bad/v11_три_варианта/REJECTED_C_опрокидывающаяся_люлька_НЕ_ПЕЧАТАТЬ/STL_ОТБРАКОВАНО_НЕ_ПЕЧАТАТЬ/C02_люлька_одной_банки.stl

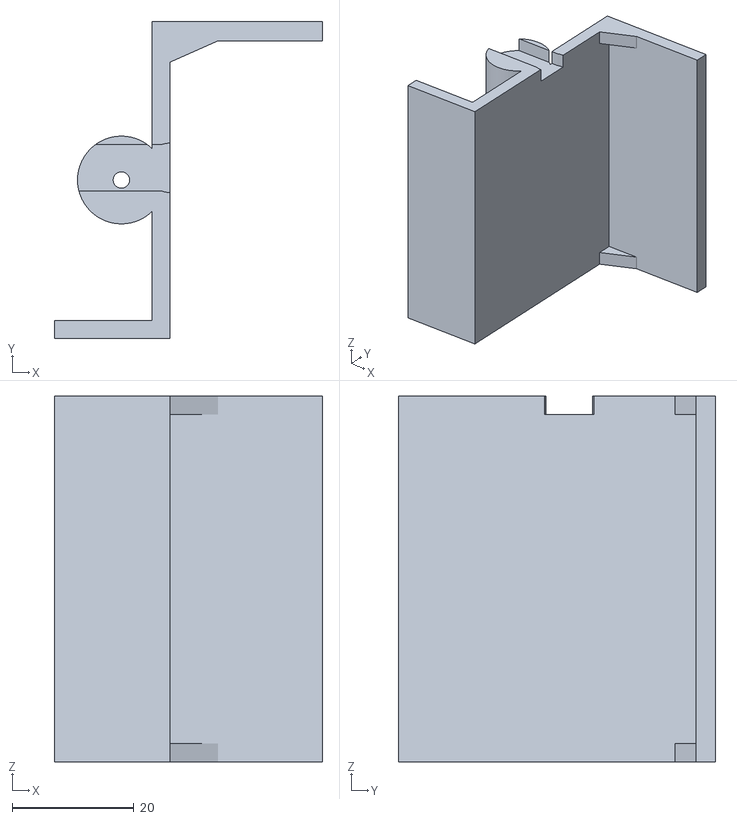
[picture p40: CAD file, 2026-10-12]
v11_три_варианта/REJECTED_C_опрокидывающаяся_люлька_НЕ_ПЕЧАТАТЬ/STL_ОТБРАКОВАНО_НЕ_ПЕЧАТАТЬ/C02_люлька_одной_банки.stl
44.0 x 52.0 x 60.0
