BZKDP/dozator-bad/v11_три_варианта/viewer_plate_assets/A/plate_01_part_01.stl

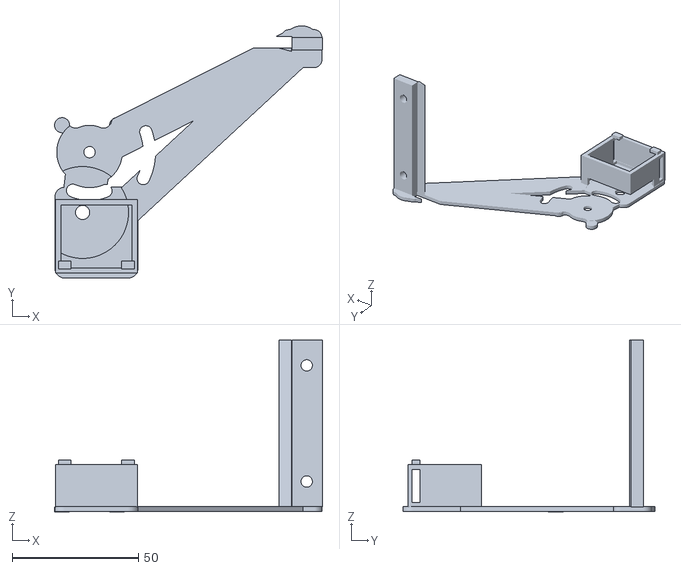
[picture p41: CAD file, 2026-10-12]
v11_три_варианта/viewer_plate_assets/A/plate_01_part_01.stl
106.1 x 99.9 x 68.0
