BZKDP/dozator-bad/v11_три_варианта/viewer_plate_assets/B/plate_05_part_01.stl

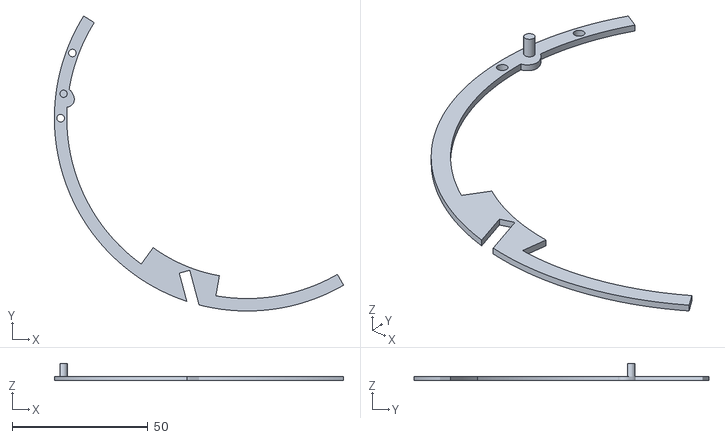
[picture p42: CAD file, 2026-10-12]
v11_три_варианта/viewer_plate_assets/B/plate_05_part_01.stl
106.5 x 108.6 x 6.40
