BZKDP/dozator-bad/v11_три_варианта/viewer_plate_assets/C/plate_01_part_04.stl

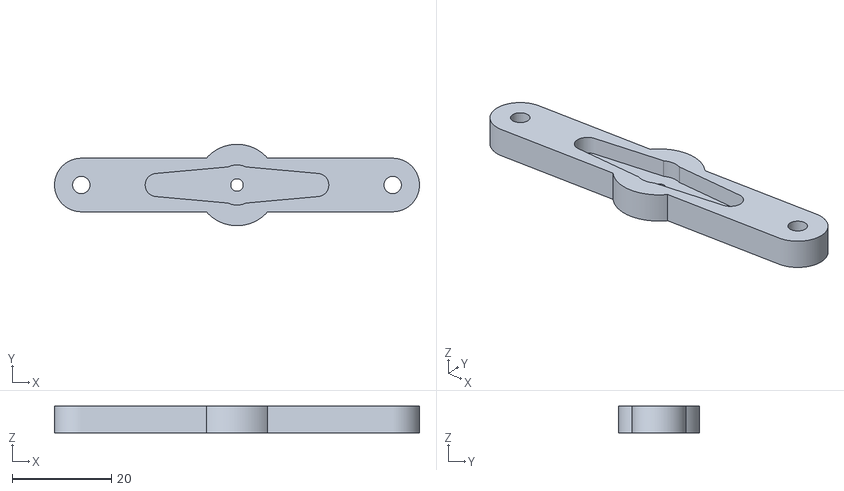
[picture p43: CAD file, 2026-10-12]
v11_три_варианта/viewer_plate_assets/C/plate_01_part_04.stl
73.6 x 16.4 x 5.40
