BZKDP/dozator-bad/v13_открытая_кассета/3D_МОДЕЛИ/A04_ВЕРХНИЙ_ПОДДОН_МАКЕТ.stl

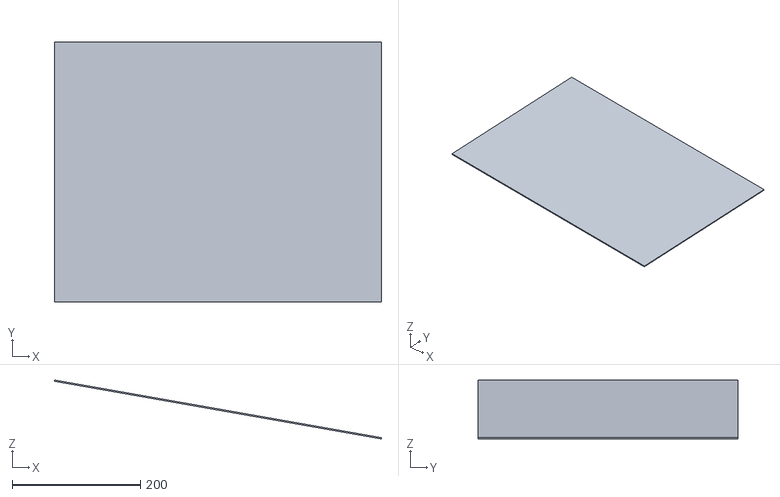
[picture p44: CAD file, 2026-10-12]
v13_открытая_кассета/3D_МОДЕЛИ/A04_ВЕРХНИЙ_ПОДДОН_МАКЕТ.stl
509.3 x 405.0 x 91.7
