BZKDP/dozator-bad/v14_кассета_ПНД4/3D_МОДЕЛИ/A03_НИЖНИЙ_ПОДДОН_МАКЕТ.stl

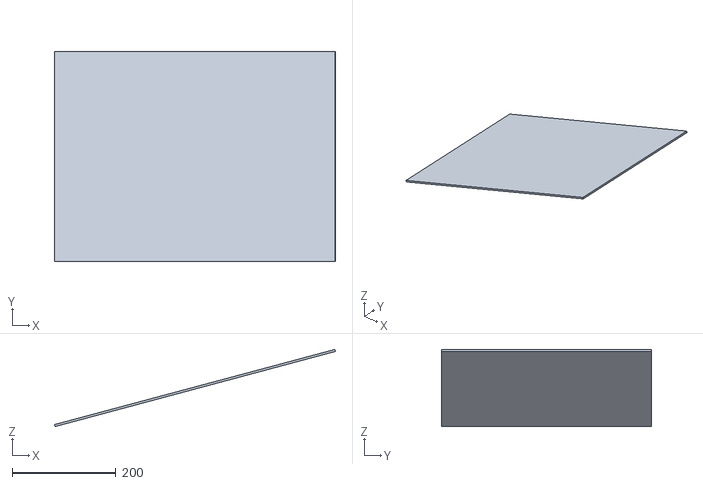
[picture p45: CAD file, 2026-10-12]
v14_кассета_ПНД4/3D_МОДЕЛИ/A03_НИЖНИЙ_ПОДДОН_МАКЕТ.stl
541.0 x 405.0 x 148.6
