BZKDP/dozator-bad/v14_кассета_ПНД4/ПЕЧАТЬ_ДОКА/КЛИПСЫ_РАСПОРКИ_шаг80 (12шт).stl

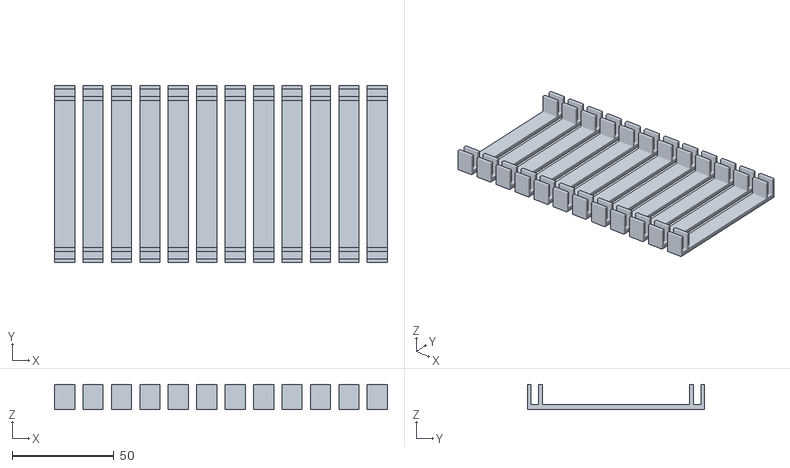
[picture p46: CAD file, 2026-10-12]
v14_кассета_ПНД4/ПЕЧАТЬ_ДОКА/КЛИПСЫ_РАСПОРКИ_шаг80 (12шт).stl
164.0 x 87.4 x 12.5
