BZKDP/dozator-bad/v9_без_клея_переработка/3D_концепты_НЕ_ПЕЧАТАТЬ/КОНЦЕПТ_кассета_A_гребенки_и_полосы.stl

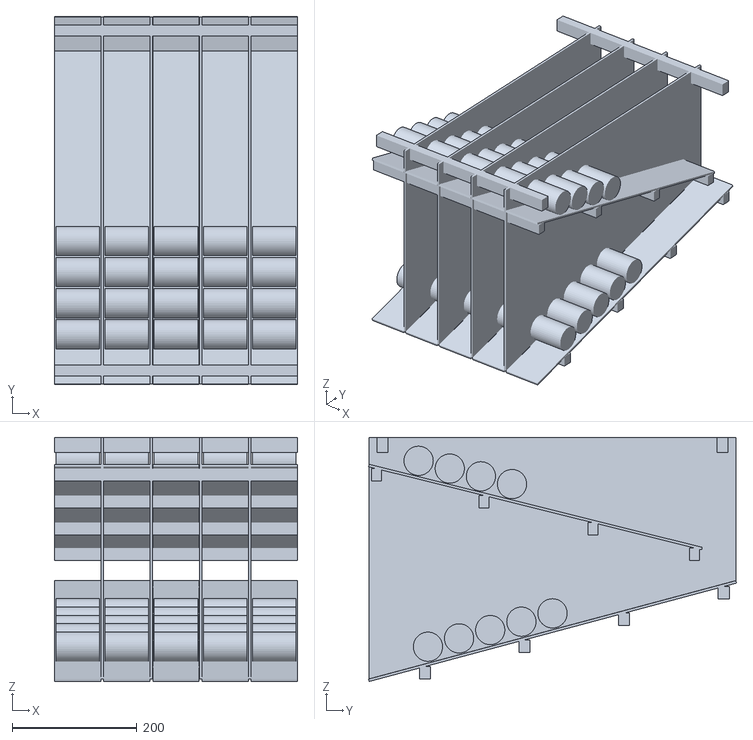
[picture p47: CAD file, 2026-10-12]
v9_без_клея_переработка/3D_концепты_НЕ_ПЕЧАТАТЬ/КОНЦЕПТ_кассета_A_гребенки_и_полосы.stl
391.0 x 591.0 x 391.9
