BZKDP/dozator-bad/v9_без_клея_переработка/_черновики/АРХИВ_черновик_качающийся_карман_HOME.stl

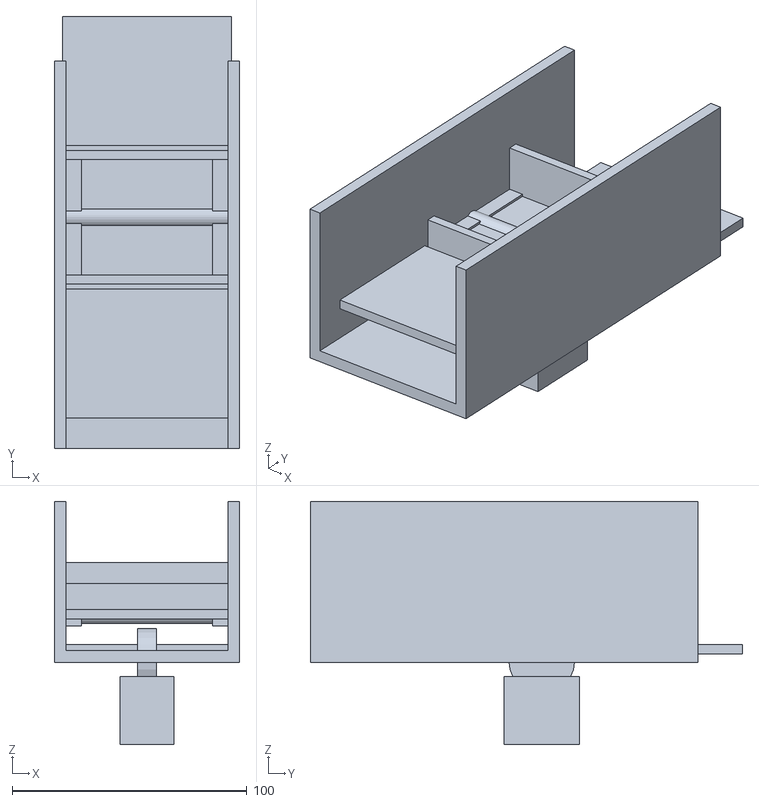
[picture p48: CAD file, 2026-10-12]
v9_без_клея_переработка/_черновики/АРХИВ_черновик_качающийся_карман_HOME.stl
79.0 x 184.0 x 103.5
