BZKDP/dozator-bad/stl_gate12/plate_gear5.stl

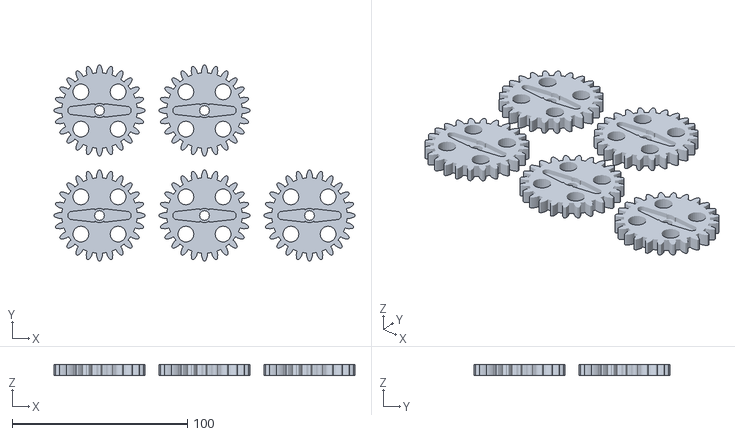
[picture p49: CAD file, 2026-10-12]
stl_gate12/plate_gear5.stl
172.0 x 112.0 x 6.00
