BZKDP/dozator-bad/stl_gate12_MG996R_backup/gear_stub.stl

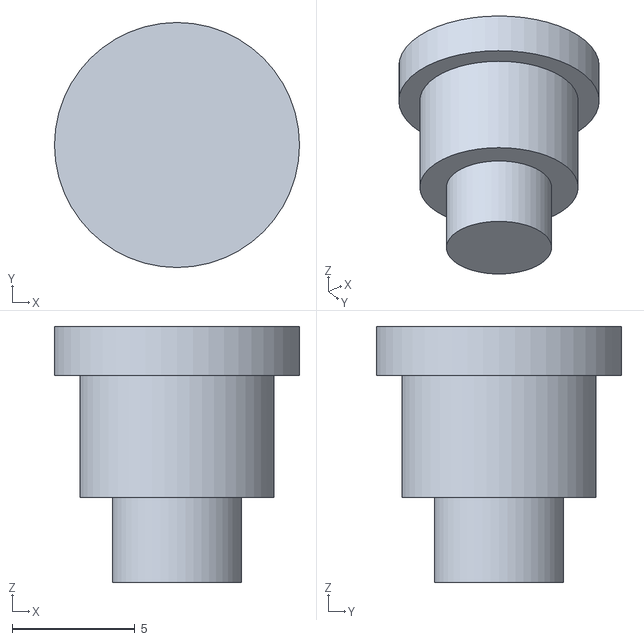
[picture p50: CAD file, 2026-10-12]
stl_gate12_MG996R_backup/gear_stub.stl
10.0 x 10.0 x 10.5
