BZKDP/dozator-bad/stl_gate12_SG90_backup/plate_rest.stl

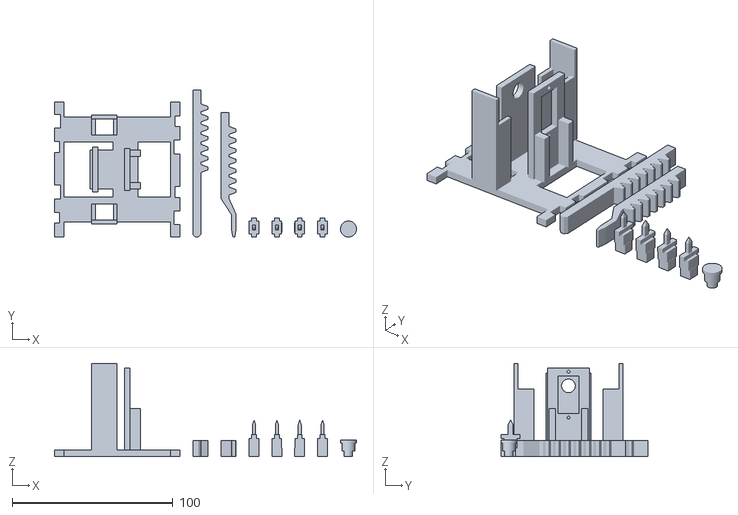
[picture p51: CAD file, 2026-10-12]
stl_gate12_SG90_backup/plate_rest.stl
187.8 x 91.5 x 58.0
