BZKDP/dozator-bad/v10_производственная_модель/STL_ПЕЧАТЬ/T03_КУПОН_втулка_кулачок_ролик.stl

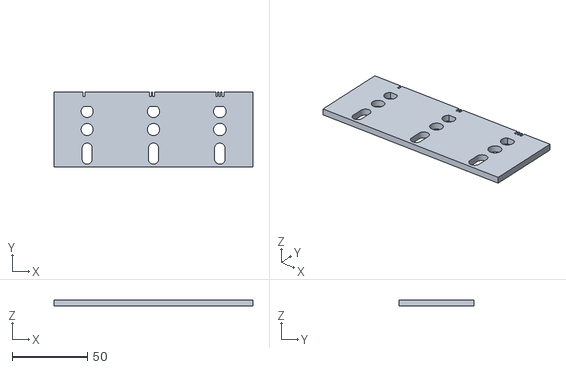
[picture p52: CAD file, 2026-10-12]
v10_производственная_модель/STL_ПЕЧАТЬ/T03_КУПОН_втулка_кулачок_ролик.stl
132.0 x 50.0 x 4.00
