BZKDP/dozator-bad/v10_производственная_модель/РАСКРОЙ_6_ЛИСТОВ/03_ВЕРХНИЙ_ЦЕЛЬНЫЙ_ЛИСТ_1шт.dxf

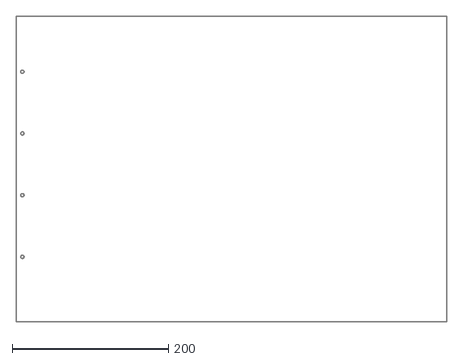
[picture p53: CAD file, 2026-10-12]
v10_производственная_модель/РАСКРОЙ_6_ЛИСТОВ/03_ВЕРХНИЙ_ЦЕЛЬНЫЙ_ЛИСТ_1шт.dxf
551.4 x 391.0
