BZKDP/dozator-bad/v11_три_варианта/00_ОБЩАЯ_КОМПОНОВКА/STL_ЗАМКИ_СБОРКА/фиксатор_нижнего_ската_world_y79_V11.stl

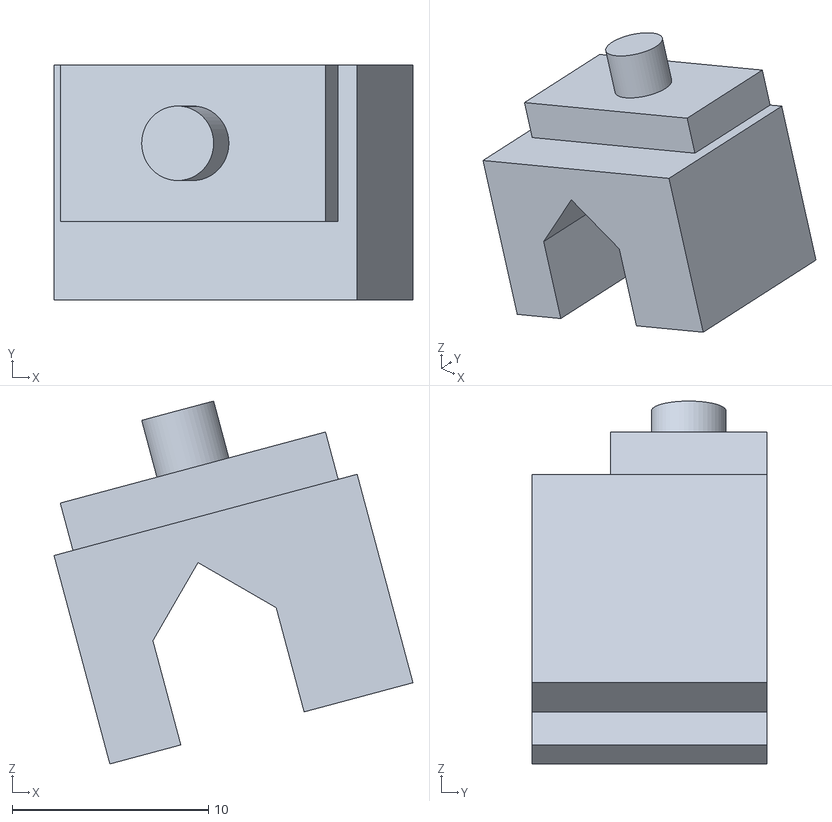
[picture p54: CAD file, 2026-10-12]
v11_три_варианта/00_ОБЩАЯ_КОМПОНОВКА/STL_ЗАМКИ_СБОРКА/фиксатор_нижнего_ската_world_y79_V11.stl
18.3 x 12.0 x 18.5
