BZKDP/dozator-bad/v11_три_варианта/00_ОБЩАЯ_КОМПОНОВКА/STL_КАССЕТА_СБОРКА/cassette_upper_sheet.stl

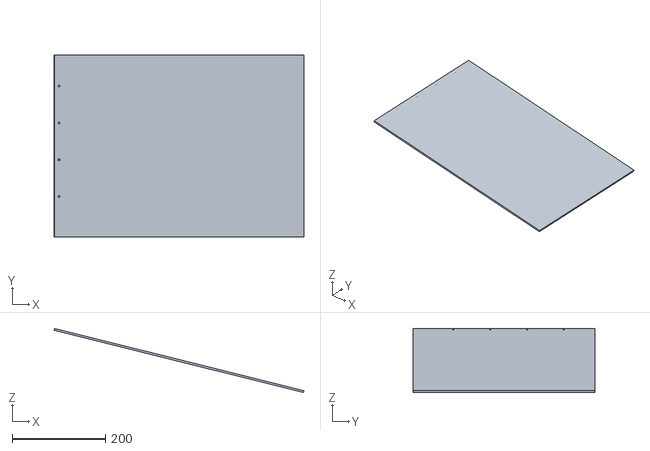
[picture p55: CAD file, 2026-10-12]
v11_три_варианта/00_ОБЩАЯ_КОМПОНОВКА/STL_КАССЕТА_СБОРКА/cassette_upper_sheet.stl
536.0 x 391.0 x 137.3
