BZKDP/dozator-bad/v11_три_варианта/00_ОБЩАЯ_КОМПОНОВКА/РАСКРОЙ_6_ЛИСТОВ/02_НИЖНИЙ_ЦЕЛЬНЫЙ_ЛИСТ_1шт.dxf

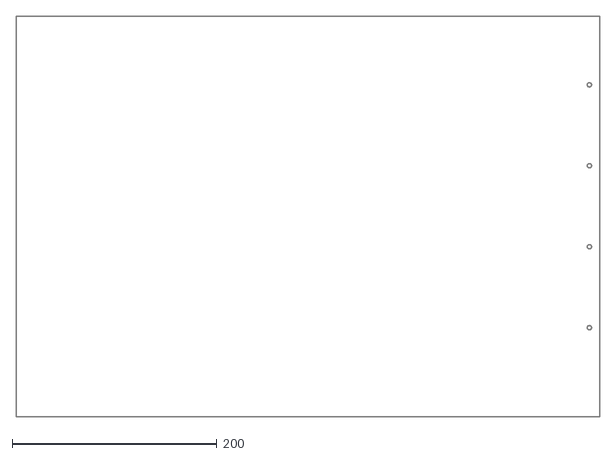
[picture p56: CAD file, 2026-10-12]
v11_три_варианта/00_ОБЩАЯ_КОМПОНОВКА/РАСКРОЙ_6_ЛИСТОВ/02_НИЖНИЙ_ЦЕЛЬНЫЙ_ЛИСТ_1шт.dxf
569.4 x 391.0
