BZKDP/dozator-bad/v11_три_варианта/A_верхнее_коромысло/STL_СБОРКА_НЕ_ПЕЧАТАТЬ/A_VIEW_EJECT_lower_sheet.stl

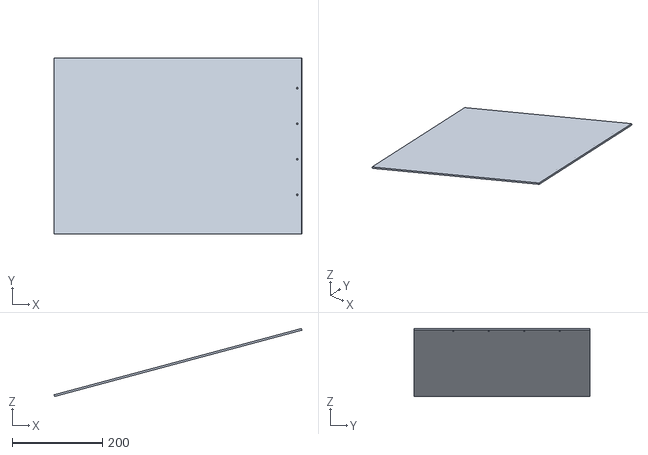
[picture p57: CAD file, 2026-10-12]
v11_три_варианта/A_верхнее_коромысло/STL_СБОРКА_НЕ_ПЕЧАТАТЬ/A_VIEW_EJECT_lower_sheet.stl
551.0 x 391.0 x 151.2
