BZKDP/dozator-bad/v11_три_варианта/B_роторная_кассета/STL_СБОРКА_НЕ_ПЕЧАТАТЬ/EJECT/rotor_star.stl

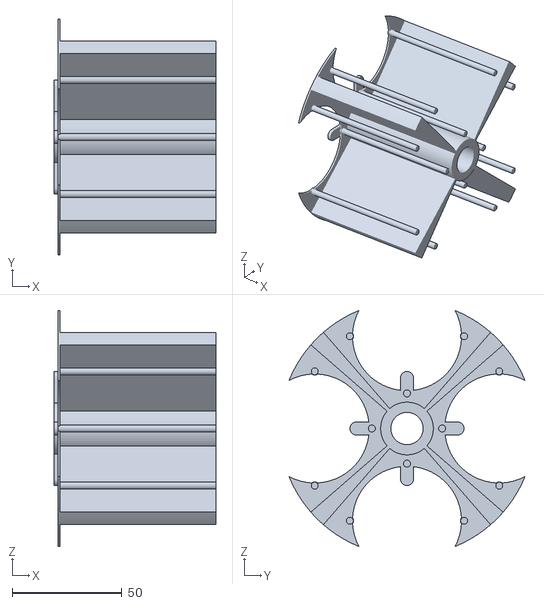
[picture p61: CAD file, 2026-10-12]
v11_три_варианта/B_роторная_кассета/STL_СБОРКА_НЕ_ПЕЧАТАТЬ/EJECT/rotor_star.stl
73.6 x 107.4 x 107.4
