BZKDP/dozator-bad/v11_три_варианта/C_верхние_линейные_ножи/STL_ПЕЧАТЬ/C02_передняя_линейная_заслонка.stl

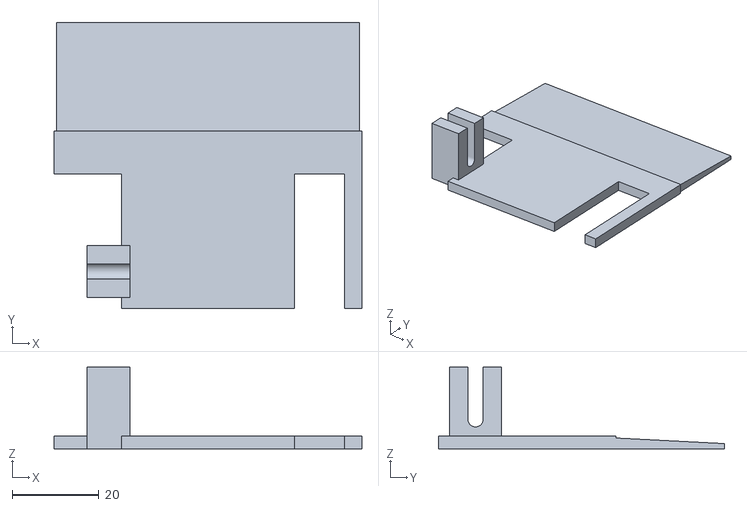
[picture p63: CAD file, 2026-10-12]
v11_три_варианта/C_верхние_линейные_ножи/STL_ПЕЧАТЬ/C02_передняя_линейная_заслонка.stl
71.2 x 66.0 x 18.9
