BZKDP/dozator-bad/v11_три_варианта/C_верхние_линейные_ножи/STL_СБОРКА_НЕ_ПЕЧАТАТЬ/C2_EJECT_rear_blade.stl

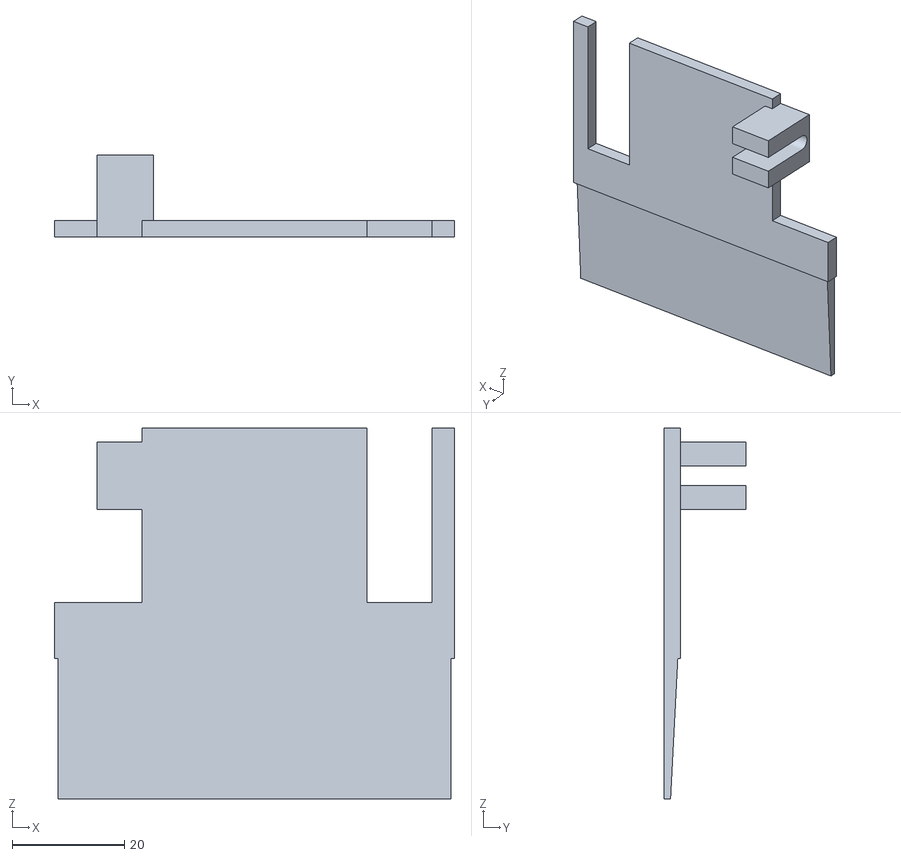
[picture p64: CAD file, 2026-10-12]
v11_три_варианта/C_верхние_линейные_ножи/STL_СБОРКА_НЕ_ПЕЧАТАТЬ/C2_EJECT_rear_blade.stl
71.2 x 14.6 x 66.0
