BZKDP/dozator-bad/v11_три_варианта/REJECTED_C_опрокидывающаяся_люлька_НЕ_ПЕЧАТАТЬ/STL_ОТБРАКОВАНО_НЕ_ПЕЧАТАТЬ/T01_КУПОН_штатной_качалки.stl

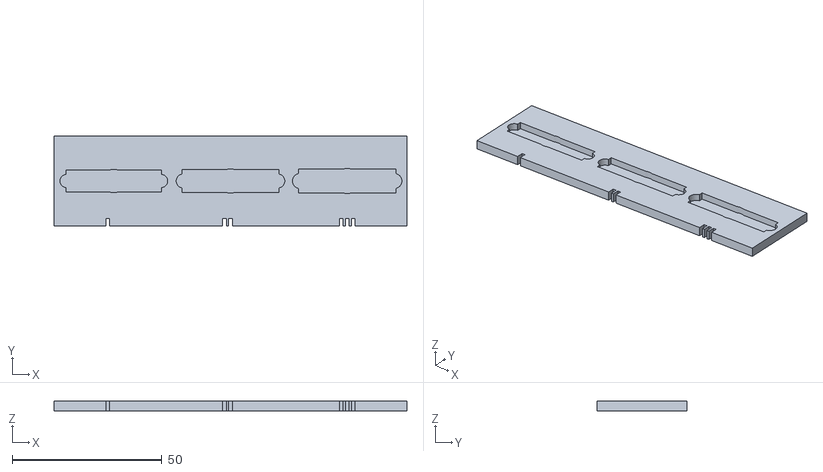
[picture p65: CAD file, 2026-10-12]
v11_три_варианта/REJECTED_C_опрокидывающаяся_люлька_НЕ_ПЕЧАТАТЬ/STL_ОТБРАКОВАНО_НЕ_ПЕЧАТАТЬ/T01_КУПОН_штатной_качалки.stl
118.0 x 30.0 x 3.20
