BZKDP/dozator-bad/v11_три_варианта/REJECTED_C_опрокидывающаяся_люлька_НЕ_ПЕЧАТАТЬ/STL_СБОРКА_НЕ_ПЕЧАТАТЬ/C_EJECT_stock_horn.stl

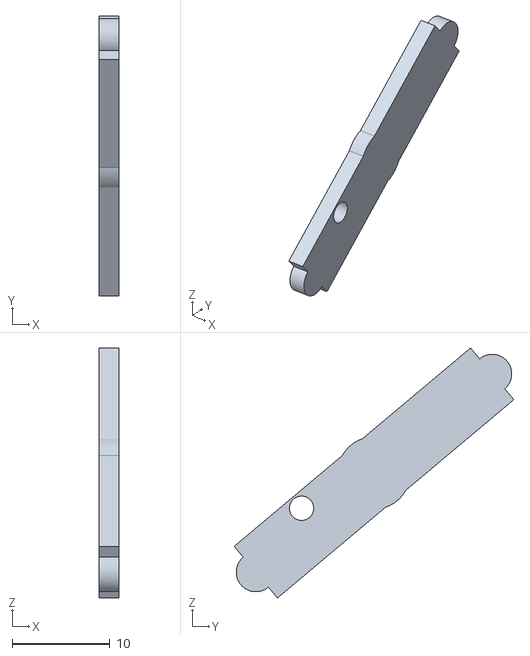
[picture p66: CAD file, 2026-10-12]
v11_три_варианта/REJECTED_C_опрокидывающаяся_люлька_НЕ_ПЕЧАТАТЬ/STL_СБОРКА_НЕ_ПЕЧАТАТЬ/C_EJECT_stock_horn.stl
2.00 x 28.6 x 25.6
