BZKDP/dozator-bad/v11_три_варианта/viewer_plate_assets/A/plate_01_part_03.stl

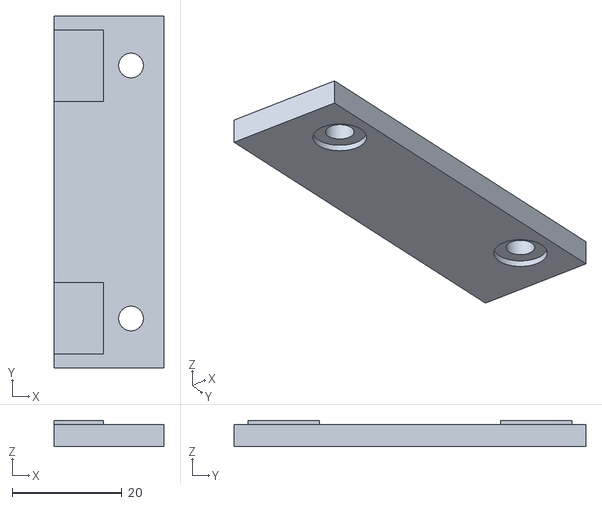
[picture p67: CAD file, 2026-10-12]
v11_три_варианта/viewer_plate_assets/A/plate_01_part_03.stl
20.0 x 64.0 x 4.80
