BZKDP/dozator-bad/v11_три_варианта/viewer_plate_assets/B/plate_03_part_01.stl

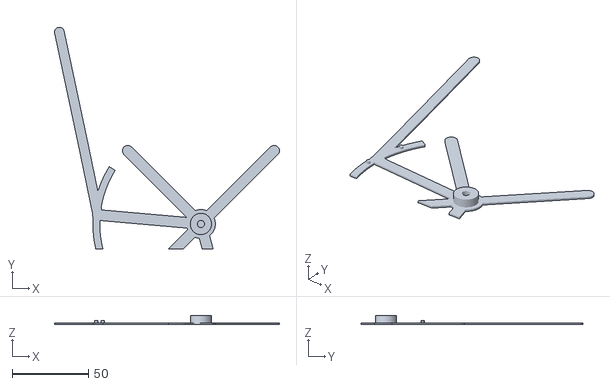
[picture p68: CAD file, 2026-10-12]
v11_три_варианта/viewer_plate_assets/B/plate_03_part_01.stl
147.8 x 145.5 x 6.15
