BZKDP/dozator-bad/v14_кассета_ПНД4/3D_МОДЕЛИ/A04_ВЕРХНИЙ_ПОДДОН_МАКЕТ.stl

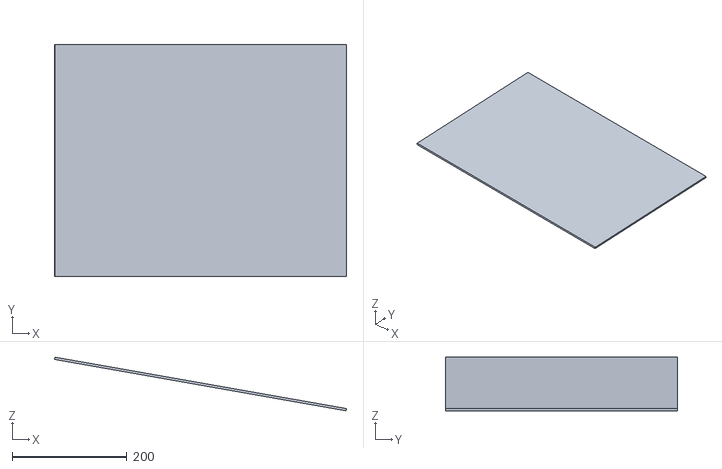
[picture p69: CAD file, 2026-10-12]
v14_кассета_ПНД4/3D_МОДЕЛИ/A04_ВЕРХНИЙ_ПОДДОН_МАКЕТ.stl
509.7 x 405.0 x 93.7
