BZKDP/dozator-bad/v14_кассета_ПНД4/ПЕЧАТЬ_ДОКА/1 ПЕЧАТЬ (блок каналы 1-2 + 8 вкладышей).stl

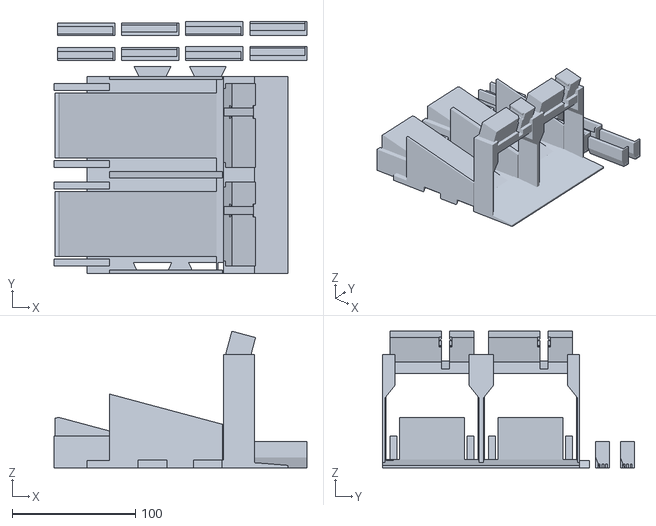
[picture p70: CAD file, 2026-10-12]
v14_кассета_ПНД4/ПЕЧАТЬ_ДОКА/1 ПЕЧАТЬ (блок каналы 1-2 + 8 вкладышей).stl
205.5 x 204.3 x 111.0
