BZKDP/dozator-bad/v9_без_клея_переработка/3D_концепты_НЕ_ПЕЧАТАТЬ/КОНЦЕПТ_система_5_каналов_вариант_B.stl

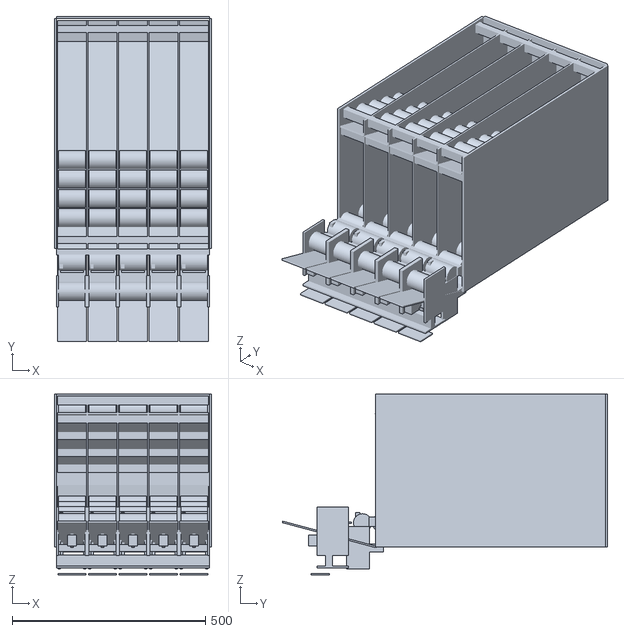
[picture p72: CAD file, 2026-10-12]
v9_без_клея_переработка/3D_концепты_НЕ_ПЕЧАТАТЬ/КОНЦЕПТ_система_5_каналов_вариант_B.stl
407.0 x 841.5 x 468.0
