BZKDP/dozator-bad/v9_без_клея_переработка/_черновики/АРХИВ_черновик_две_гильотины.stl

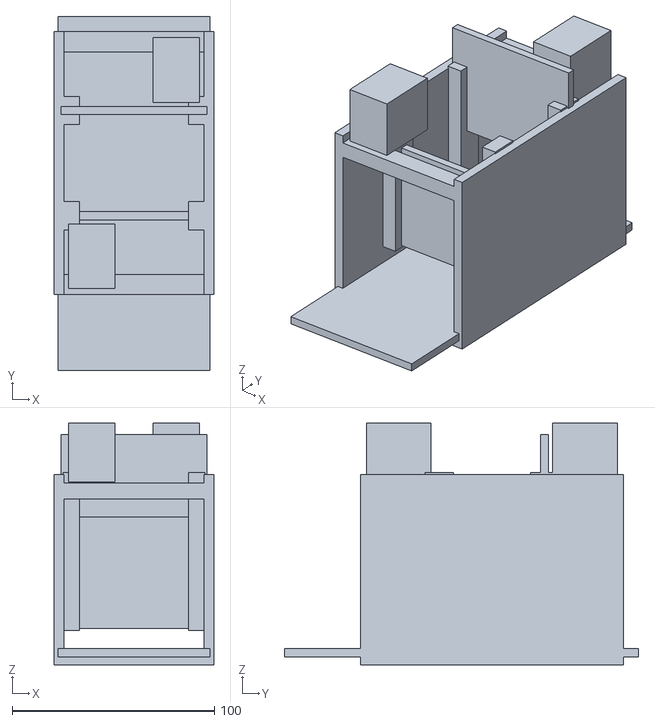
[picture p73: CAD file, 2026-10-12]
v9_без_клея_переработка/_черновики/АРХИВ_черновик_две_гильотины.stl
79.0 x 175.0 x 119.5
