BZKDP/dozator-bad/stl_gate12_SG90_backup/chassis.stl

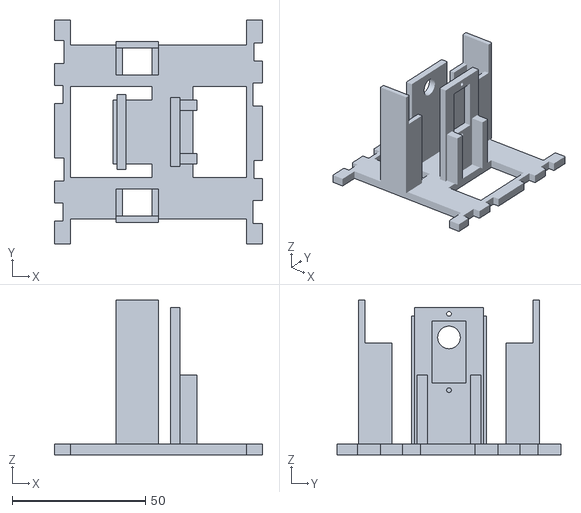
[picture p74: CAD file, 2026-10-12]
stl_gate12_SG90_backup/chassis.stl
78.0 x 84.0 x 58.0
