BZKDP/dozator-bad/v10_производственная_модель/STL_ПЕЧАТЬ/M06_крышка_кулачка.stl

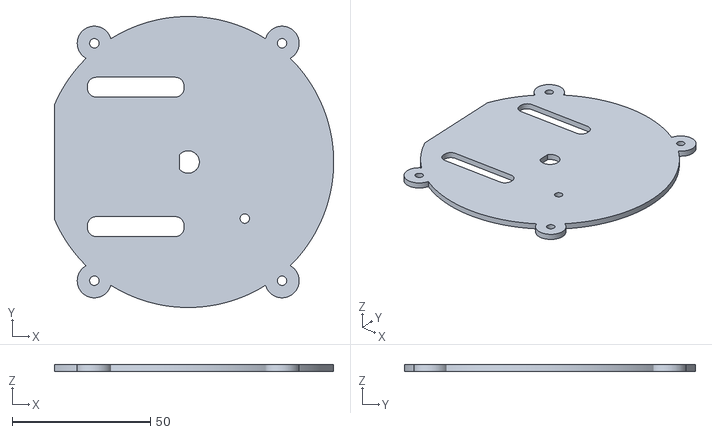
[picture p75: CAD file, 2026-10-12]
v10_производственная_модель/STL_ПЕЧАТЬ/M06_крышка_кулачка.stl
101.2 x 105.4 x 2.40
