BZKDP/dozator-bad/v11_три_варианта/B_роторная_кассета/REJECTED_DIRECT_DRIVE/STL_ПЕЧАТЬ/B01_ротор_лёгкая_клетка.stl

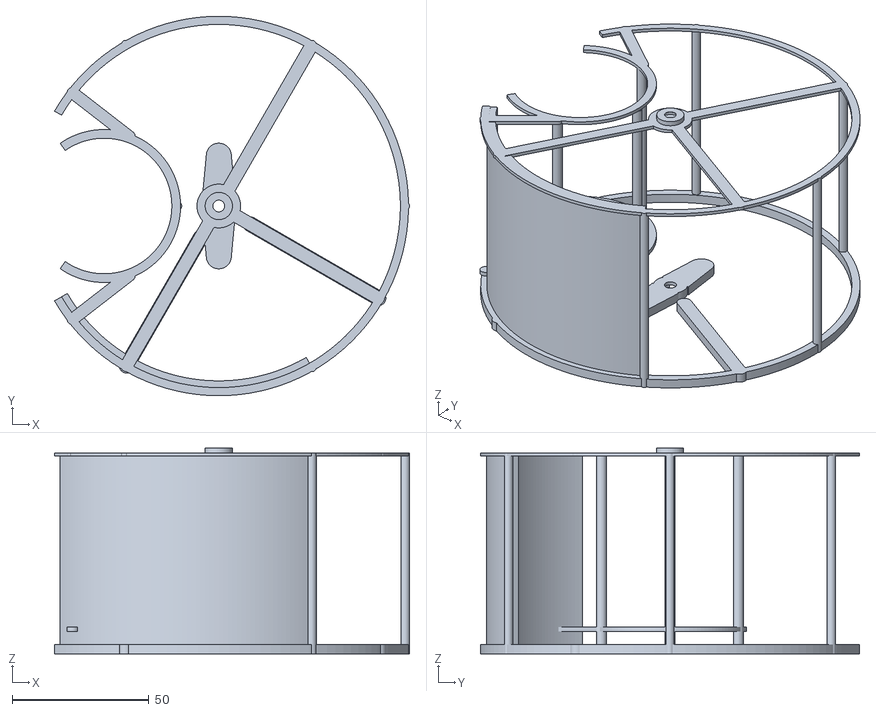
[picture p78: CAD file, 2026-10-12]
v11_три_варианта/B_роторная_кассета/REJECTED_DIRECT_DRIVE/STL_ПЕЧАТЬ/B01_ротор_лёгкая_клетка.stl
129.9 x 138.9 x 75.3
