BZKDP/dozator-bad/v11_три_варианта/B_роторная_кассета/STL_ПЕЧАТЬ/B02L_левая_щека_серва.stl

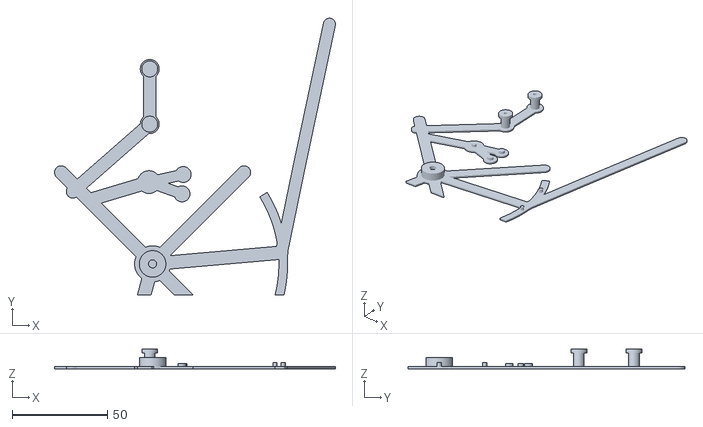
[picture p81: CAD file, 2026-10-12]
v11_три_варианта/B_роторная_кассета/STL_ПЕЧАТЬ/B02L_левая_щека_серва.stl
147.8 x 145.5 x 10.4
