BZKDP/dozator-bad/v11_три_варианта/C_верхние_линейные_ножи/STL_СБОРКА_НЕ_ПЕЧАТАТЬ/C2_EJECT_frame.stl

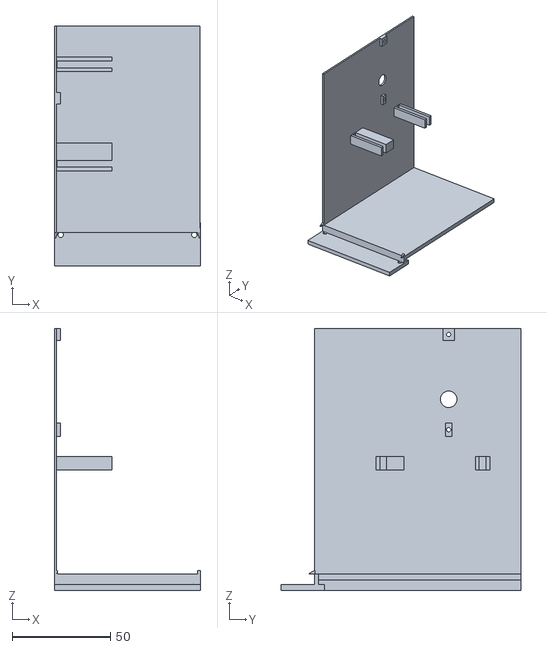
[picture p83: CAD file, 2026-10-12]
v11_три_варианта/C_верхние_линейные_ножи/STL_СБОРКА_НЕ_ПЕЧАТАТЬ/C2_EJECT_frame.stl
74.4 x 122.0 x 133.3
