BZKDP/dozator-bad/v11_три_варианта/REJECTED_C_опрокидывающаяся_люлька_НЕ_ПЕЧАТАТЬ/STL_ОТБРАКОВАНО_НЕ_ПЕЧАТАТЬ/C01_рама_крепление.stl

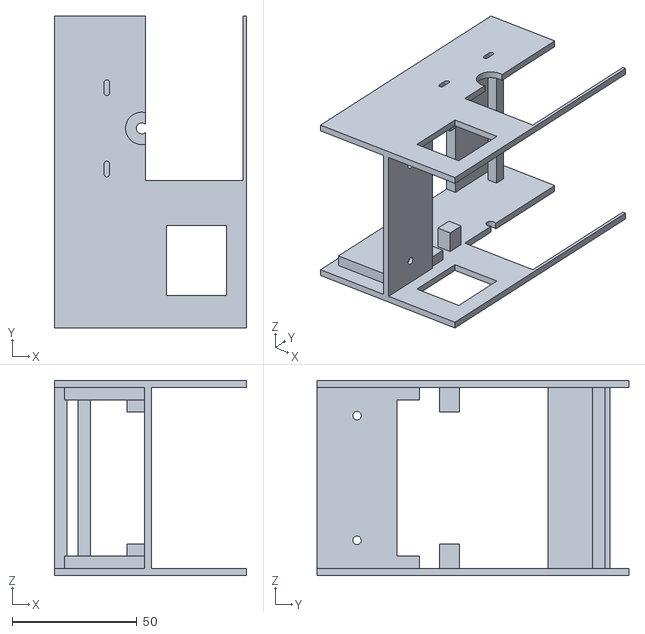
[picture p84: CAD file, 2026-10-12]
v11_три_варианта/REJECTED_C_опрокидывающаяся_люлька_НЕ_ПЕЧАТАТЬ/STL_ОТБРАКОВАНО_НЕ_ПЕЧАТАТЬ/C01_рама_крепление.stl
77.0 x 125.0 x 78.4
