BZKDP/dozator-bad/v11_три_варианта/REJECTED_C_опрокидывающаяся_люлька_НЕ_ПЕЧАТАТЬ/STL_СБОРКА_НЕ_ПЕЧАТАТЬ/C_TRANSFER_stock_horn.stl

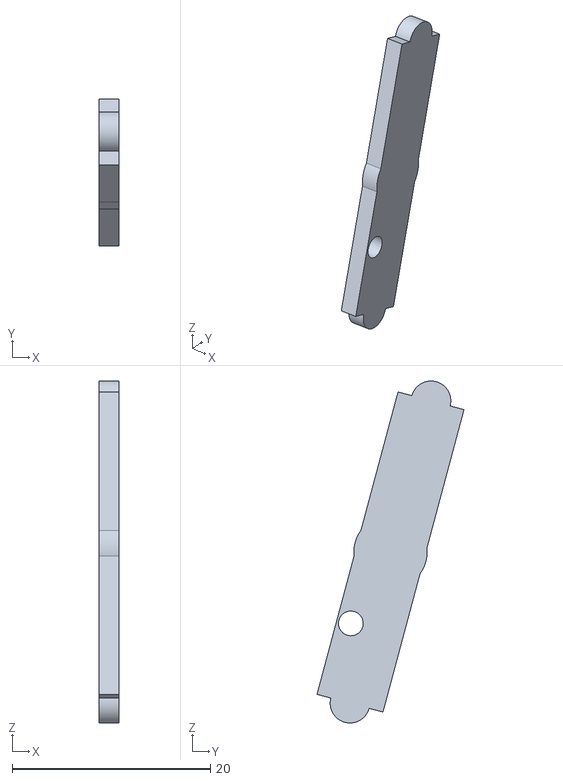
[picture p85: CAD file, 2026-10-12]
v11_три_варианта/REJECTED_C_опрокидывающаяся_люлька_НЕ_ПЕЧАТАТЬ/STL_СБОРКА_НЕ_ПЕЧАТАТЬ/C_TRANSFER_stock_horn.stl
2.00 x 14.8 x 34.5
