BZKDP/dozator-bad/v13_открытая_кассета/3D_МОДЕЛИ/A01_БОКОВАЯ_СТЕНКА_МАКЕТ.stl

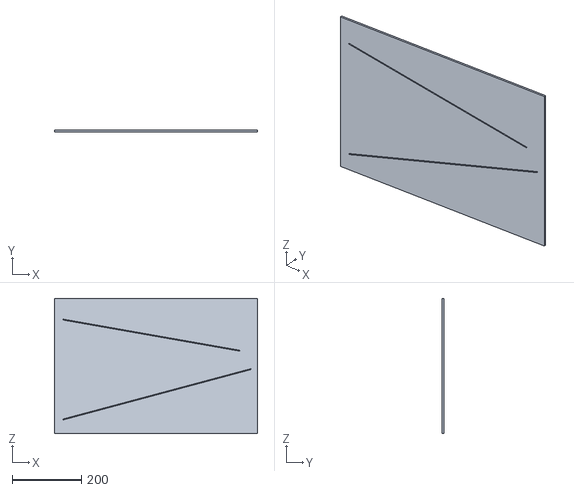
[picture p86: CAD file, 2026-10-12]
v13_открытая_кассета/3D_МОДЕЛИ/A01_БОКОВАЯ_СТЕНКА_МАКЕТ.stl
585.0 x 5.00 x 390.0
