BZKDP/dozator-bad/v14_кассета_ПНД4/ПЕЧАТЬ_ДОКА/ВТУЛКИ_5 + ВКЛАДЫШИ_УЗКИЕ_10.stl

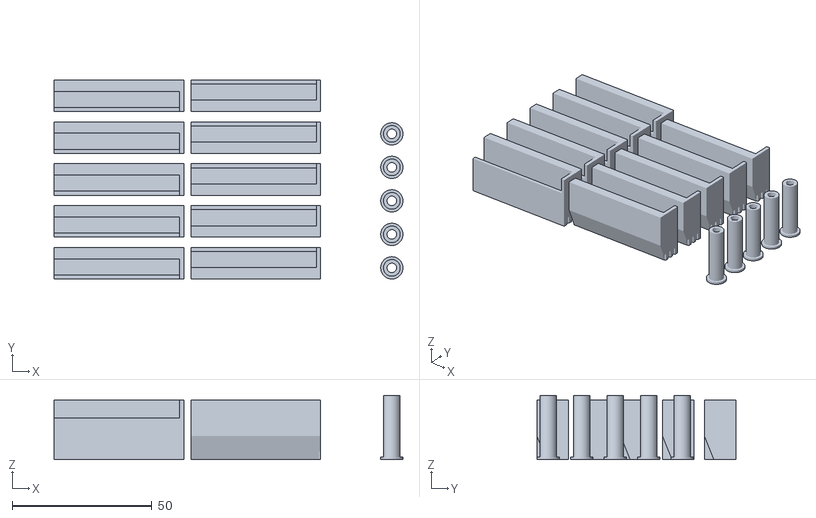
[picture p87: CAD file, 2026-10-12]
v14_кассета_ПНД4/ПЕЧАТЬ_ДОКА/ВТУЛКИ_5 + ВКЛАДЫШИ_УЗКИЕ_10.stl
125.0 x 71.3 x 23.0
