BZKDP/dozator-bad/v15_ручной_раскрой/reference_models_not_for_printing/wall_1.stl

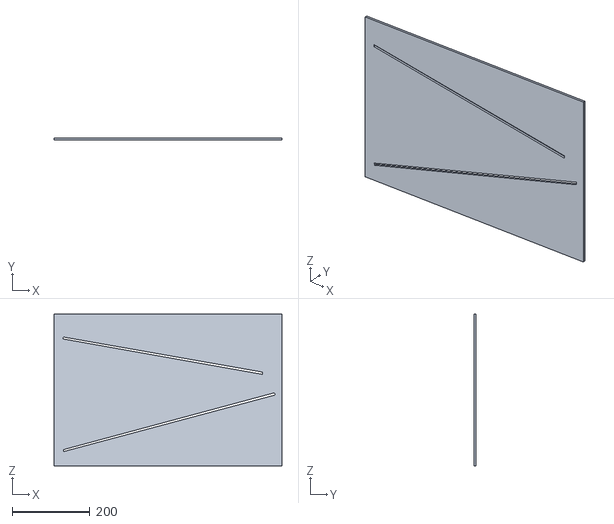
[picture p88: CAD file, 2026-10-12]
v15_ручной_раскрой/reference_models_not_for_printing/wall_1.stl
585.0 x 5.00 x 390.0
