BZKDP/dozator-bad/v9_без_клея_переработка/3D_концепты_НЕ_ПЕЧАТАТЬ/КОНЦЕПТ_затвор_B_вертикальный_шлюз_ВЫДАЧА.stl

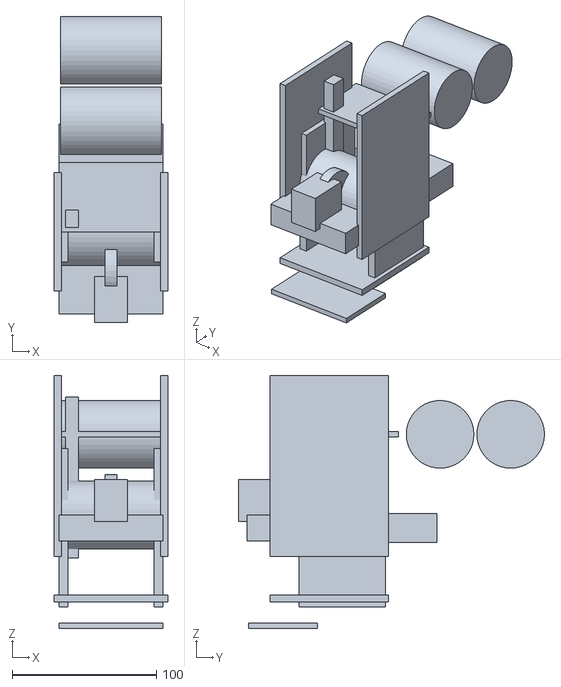
[picture p89: CAD file, 2026-10-12]
v9_без_клея_переработка/3D_концепты_НЕ_ПЕЧАТАТЬ/КОНЦЕПТ_затвор_B_вертикальный_шлюз_ВЫДАЧА.stl
79.0 x 212.5 x 176.0
