BZKDP/dozator-bad/stl_gate12/rack_G1.stl

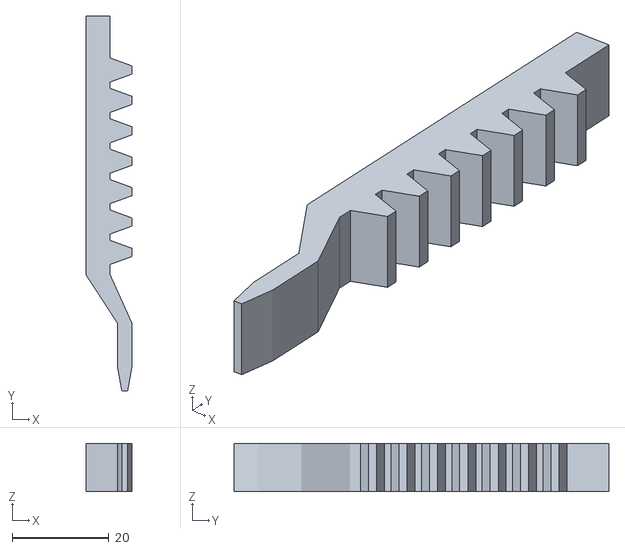
[picture p90: CAD file, 2026-10-12]
stl_gate12/rack_G1.stl
9.50 x 77.5 x 10.0
