BZKDP/dozator-bad/stl_gate12_MG996R_backup/plate_gear.stl

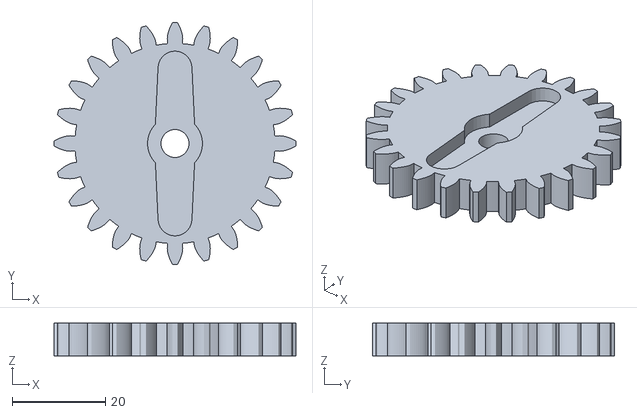
[picture p91: CAD file, 2026-10-12]
stl_gate12_MG996R_backup/plate_gear.stl
52.0 x 52.0 x 7.00
