BZKDP/dozator-bad/v10_производственная_модель/STL_ПЕЧАТЬ/M02_рама_привода.stl

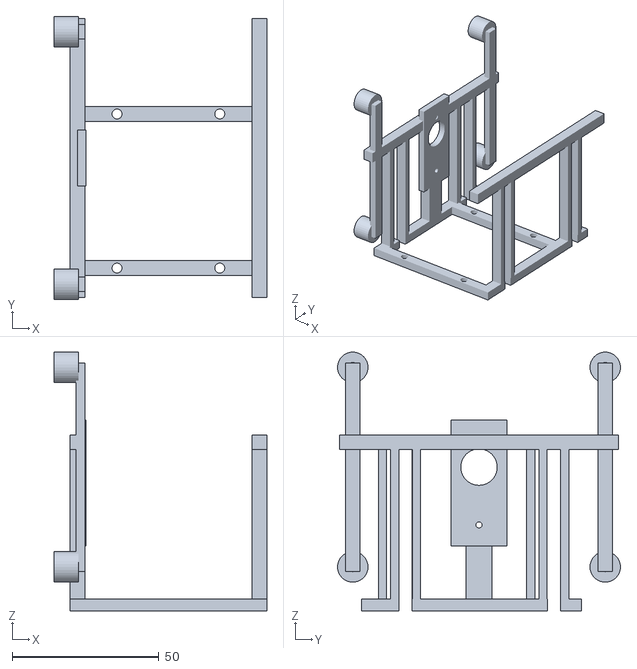
[picture p92: CAD file, 2026-10-12]
v10_производственная_модель/STL_ПЕЧАТЬ/M02_рама_привода.stl
72.4 x 96.4 x 88.2
