BZKDP/dozator-bad/v10_производственная_модель/STL_СБОРКА_НЕ_ПЕЧАТАТЬ/plinth_reference.stl

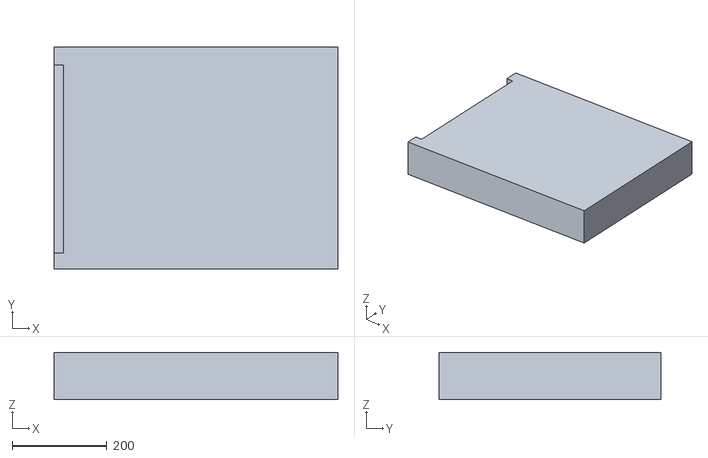
[picture p93: CAD file, 2026-10-12]
v10_производственная_модель/STL_СБОРКА_НЕ_ПЕЧАТАТЬ/plinth_reference.stl
600.0 x 470.0 x 100.0
