BZKDP/dozator-bad/v10_производственная_модель/РАСКРОЙ_6_ЛИСТОВ/01_РАЗДЕЛИТЕЛЬ_РУЧНОЙ_зазор_0.45_4шт.dxf

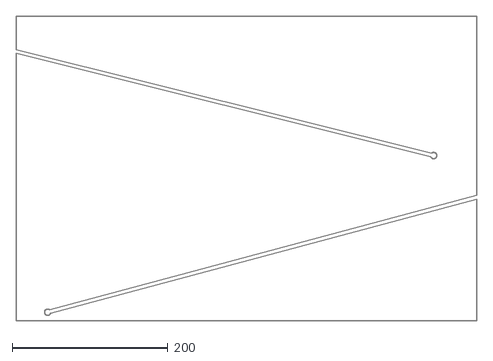
[picture p94: CAD file, 2026-10-12]
v10_производственная_модель/РАСКРОЙ_6_ЛИСТОВ/01_РАЗДЕЛИТЕЛЬ_РУЧНОЙ_зазор_0.45_4шт.dxf
590.0 x 390.0
