BZKDP/dozator-bad/v11_три_варианта/00_ОБЩАЯ_КОМПОНОВКА/STL_ЗАМКИ_СБОРКА/M4_шайбы_16шт_world_REFERENCE.stl

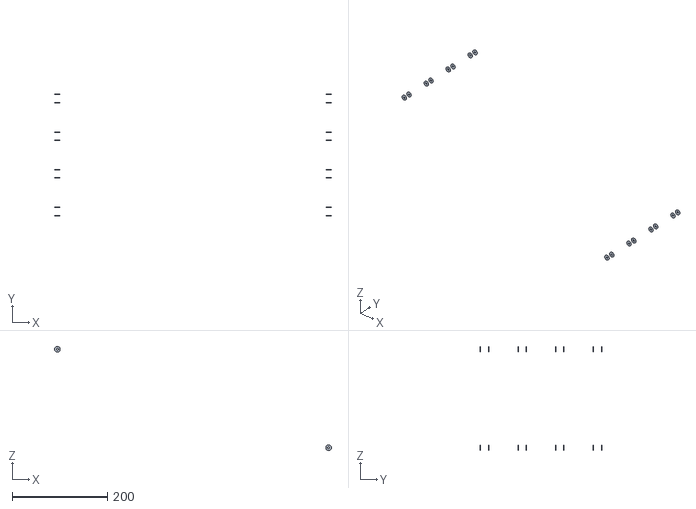
[picture p95: CAD file, 2026-10-12]
v11_три_варианта/00_ОБЩАЯ_КОМПОНОВКА/STL_ЗАМКИ_СБОРКА/M4_шайбы_16шт_world_REFERENCE.stl
580.9 x 255.0 x 218.5
