BZKDP/dozator-bad/v11_три_варианта/00_ОБЩАЯ_КОМПОНОВКА/РАСКРОЙ_6_ЛИСТОВ/01_РАЗДЕЛИТЕЛЬ_CNC_зазор_0.25_4шт.dxf

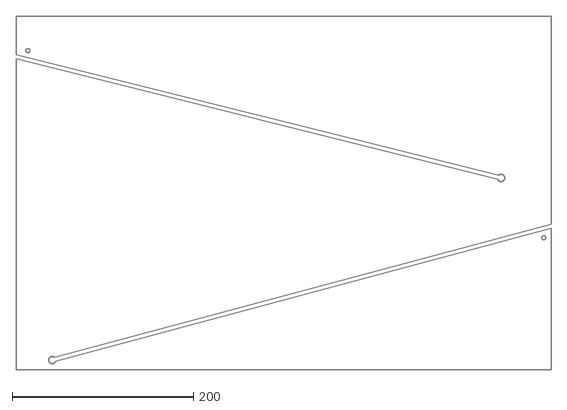
[picture p96: CAD file, 2026-10-12]
v11_три_варианта/00_ОБЩАЯ_КОМПОНОВКА/РАСКРОЙ_6_ЛИСТОВ/01_РАЗДЕЛИТЕЛЬ_CNC_зазор_0.25_4шт.dxf
590.0 x 390.0
