BZKDP/dozator-bad/v11_три_варианта/A_верхнее_коромысло/STL_ПЕЧАТЬ/A03_короткая_тяга_12мм.stl

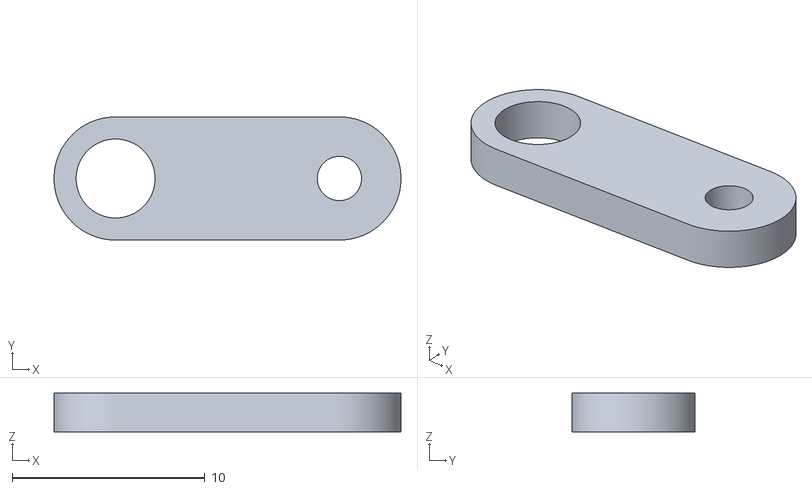
[picture p97: CAD file, 2026-10-12]
v11_три_варианта/A_верхнее_коромысло/STL_ПЕЧАТЬ/A03_короткая_тяга_12мм.stl
18.0 x 6.40 x 2.00
