BZKDP/dozator-bad/v11_три_варианта/A_верхнее_коромысло/STL_СБОРКА_НЕ_ПЕЧАТАТЬ/A_VIEW_HOME_horn.stl

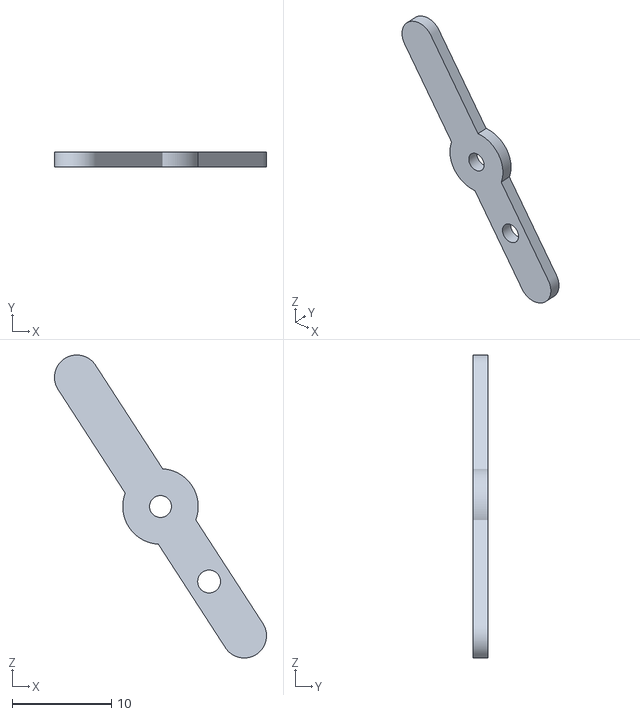
[picture p98: CAD file, 2026-10-12]
v11_три_варианта/A_верхнее_коромысло/STL_СБОРКА_НЕ_ПЕЧАТАТЬ/A_VIEW_HOME_horn.stl
21.4 x 1.50 x 30.5
