BZKDP/dozator-bad/v11_три_варианта/C_верхние_линейные_ножи/STL_ПЕЧАТЬ/T01_КУПОН_штатной_качалки.stl

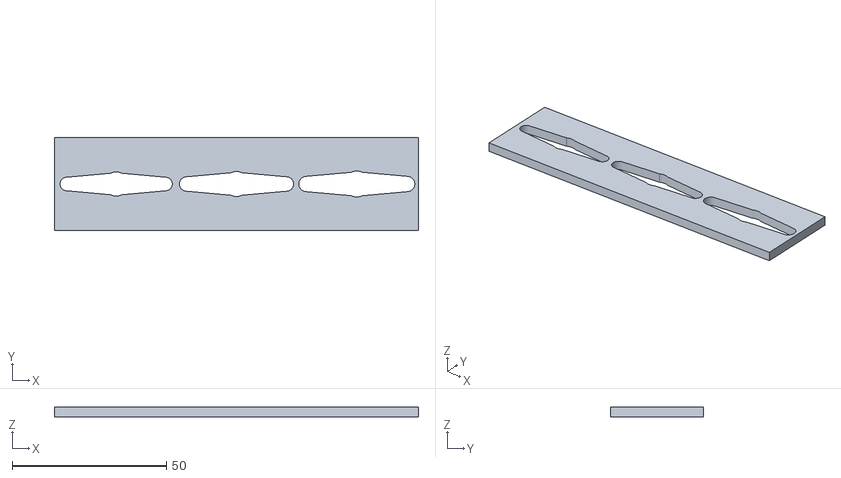
[picture p102: CAD file, 2026-10-12]
v11_три_варианта/C_верхние_линейные_ножи/STL_ПЕЧАТЬ/T01_КУПОН_штатной_качалки.stl
118.0 x 30.0 x 3.20
