BZKDP/dozator-bad/v11_три_варианта/viewer_plate_assets/B/plate_01_part_04.stl

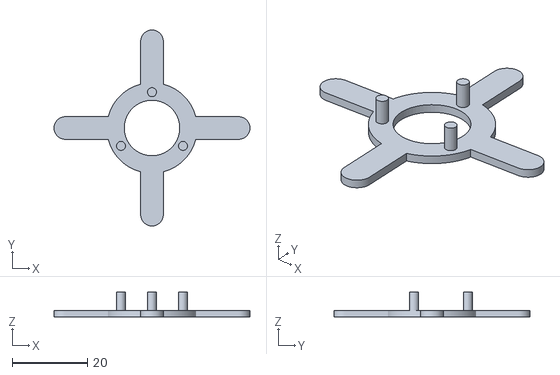
[picture p103: CAD file, 2026-10-12]
v11_три_варианта/viewer_plate_assets/B/plate_01_part_04.stl
52.0 x 52.0 x 6.55
