BZKDP/dozator-bad/v13_открытая_кассета/3D_МОДЕЛИ/V13_КАССЕТА_СБОРКА_ДЛЯ_ПРОСМОТРА.stl

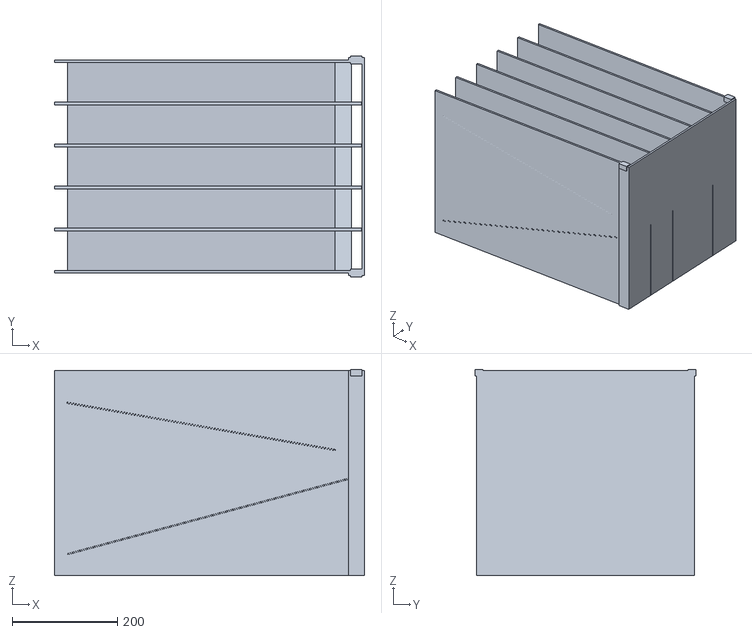
[picture p104: CAD file, 2026-10-12]
v13_открытая_кассета/3D_МОДЕЛИ/V13_КАССЕТА_СБОРКА_ДЛЯ_ПРОСМОТРА.stl
590.0 x 420.0 x 392.4
