BZKDP/dozator-bad/v14_кассета_ПНД4/ПЕЧАТЬ_ДОКА/3 ПЕЧАТЬ (канал 5 + 2 щёчки + 8 вкладышей).stl

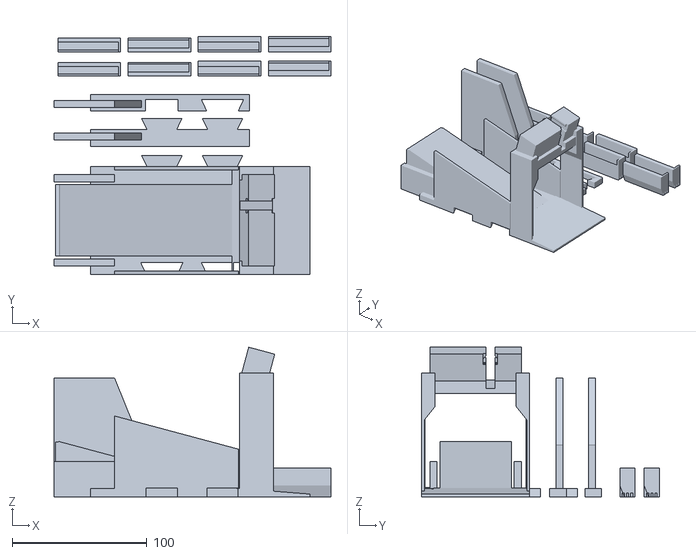
[picture p105: CAD file, 2026-10-12]
v14_кассета_ПНД4/ПЕЧАТЬ_ДОКА/3 ПЕЧАТЬ (канал 5 + 2 щёчки + 8 вкладышей).stl
205.5 x 176.3 x 111.0
