BZKDP/dozator-bad/v9_без_клея_переработка/3D_концепты_НЕ_ПЕЧАТАТЬ/КОНЦЕПТ_затвор_C_роторный_шлюз_HOME.stl

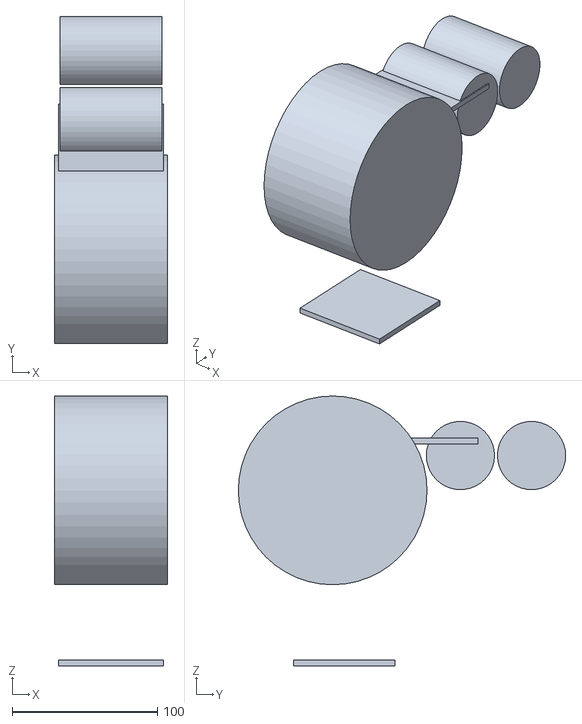
[picture p106: CAD file, 2026-10-12]
v9_без_клея_переработка/3D_концепты_НЕ_ПЕЧАТАТЬ/КОНЦЕПТ_затвор_C_роторный_шлюз_HOME.stl
78.0 x 225.5 x 186.0
