BZKDP/dozator-bad/stl_gate12/plate_gear.stl

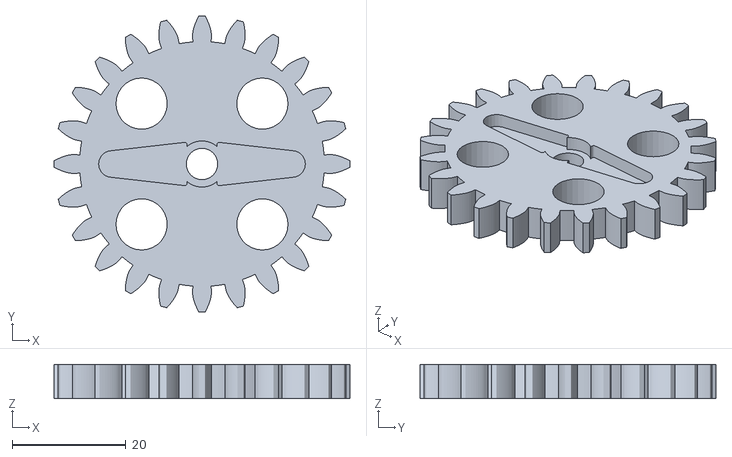
[picture p107: CAD file, 2026-10-12]
stl_gate12/plate_gear.stl
52.0 x 52.0 x 6.00
