BZKDP/dozator-bad/stl_gate12_MG996R_backup/rack_G2.stl

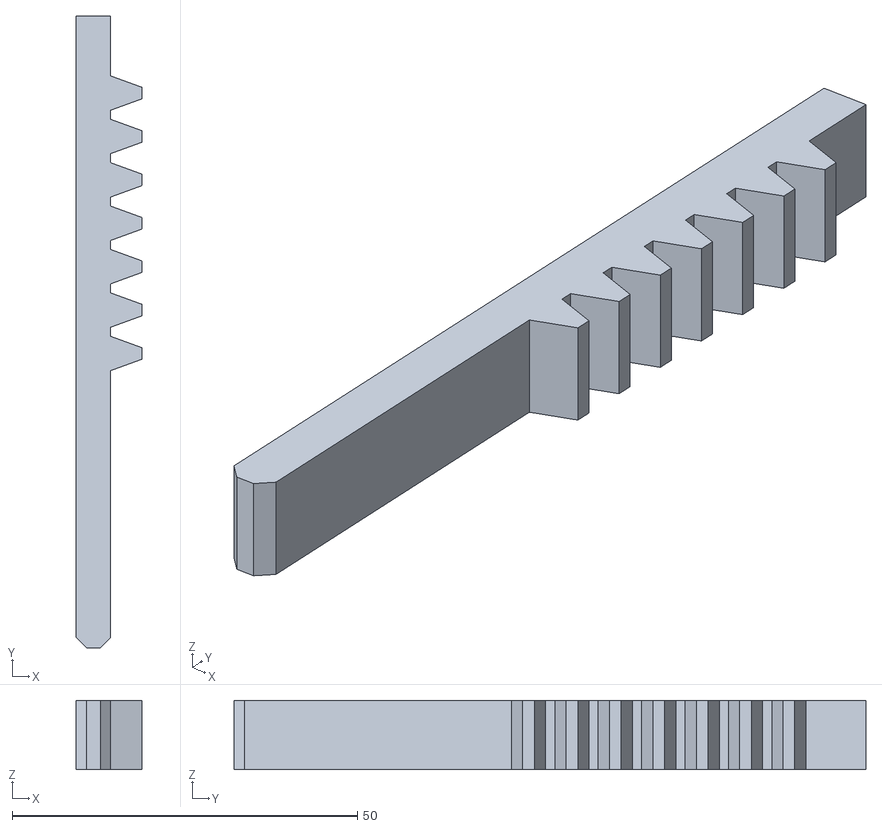
[picture p108: CAD file, 2026-10-12]
stl_gate12_MG996R_backup/rack_G2.stl
9.50 x 91.5 x 10.0
