BZKDP/dozator-bad/v10_производственная_модель/STL_ПЕЧАТЬ/M01_лоток_корпус.stl

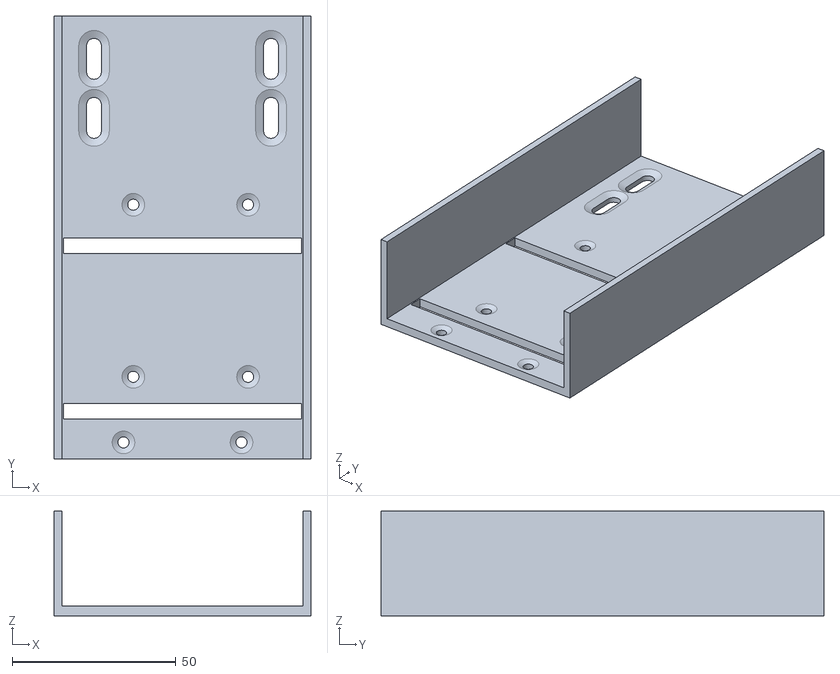
[picture p109: CAD file, 2026-10-12]
v10_производственная_модель/STL_ПЕЧАТЬ/M01_лоток_корпус.stl
78.4 x 135.0 x 32.0
