BZKDP/dozator-bad/v11_три_варианта/00_ОБЩАЯ_КОМПОНОВКА/STL_ЗАМКИ_СБОРКА/фиксатор_верхнего_ската_world_y79_V11.stl

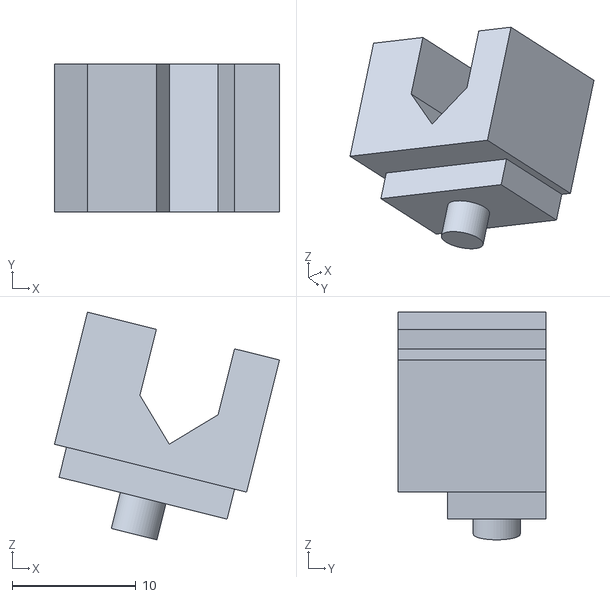
[picture p110: CAD file, 2026-10-12]
v11_три_варианта/00_ОБЩАЯ_КОМПОНОВКА/STL_ЗАМКИ_СБОРКА/фиксатор_верхнего_ската_world_y79_V11.stl
18.2 x 12.0 x 18.4
