BZKDP/dozator-bad/v11_три_варианта/A_верхнее_коромысло/STL_СБОРКА_НЕ_ПЕЧАТАТЬ/A_ОДИН_КАНАЛ_EJECT_3_банки.stl

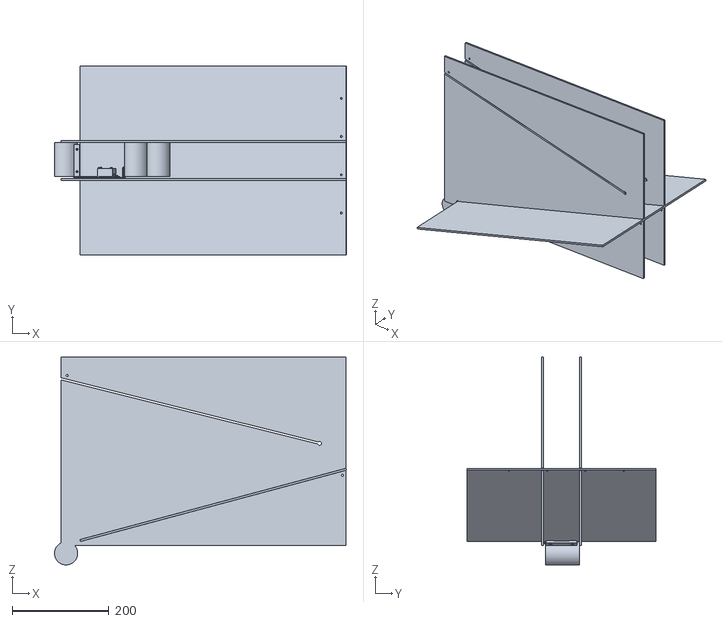
[picture p111: CAD file, 2026-10-12]
v11_три_варианта/A_верхнее_коромысло/STL_СБОРКА_НЕ_ПЕЧАТАТЬ/A_ОДИН_КАНАЛ_EJECT_3_банки.stl
603.7 x 391.0 x 429.7
