BZKDP/dozator-bad/v11_три_варианта/B_роторная_кассета/STL_ПЕЧАТЬ/B02O_выходной_лоток.stl

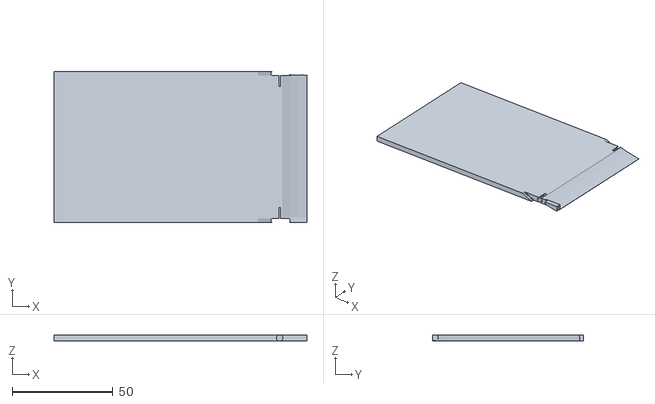
[picture p112: CAD file, 2026-10-12]
v11_три_варианта/B_роторная_кассета/STL_ПЕЧАТЬ/B02O_выходной_лоток.stl
125.7 x 75.0 x 3.00
