BZKDP/dozator-bad/v11_три_варианта/C_верхние_линейные_ножи/STL_СБОРКА_НЕ_ПЕЧАТАТЬ/C2_EJECT_lower_sheet.stl

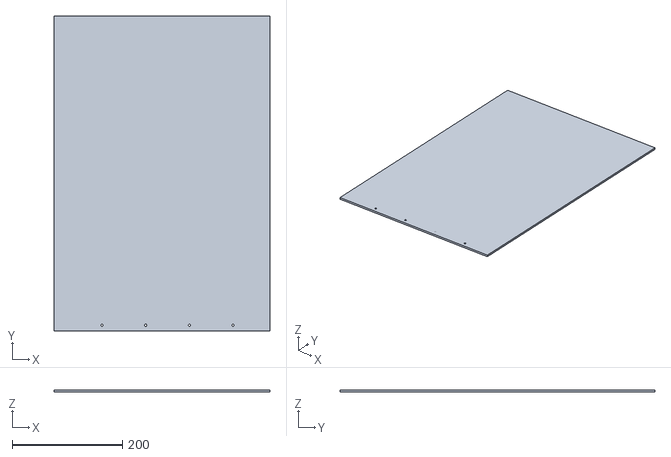
[picture p114: CAD file, 2026-10-12]
v11_три_варианта/C_верхние_линейные_ножи/STL_СБОРКА_НЕ_ПЕЧАТАТЬ/C2_EJECT_lower_sheet.stl
391.0 x 569.4 x 4.00
