BZKDP/dozator-bad/v11_три_варианта/REJECTED_C_опрокидывающаяся_люлька_НЕ_ПЕЧАТАТЬ/STL_СБОРКА_НЕ_ПЕЧАТАТЬ/C_EJECT_can_1.stl

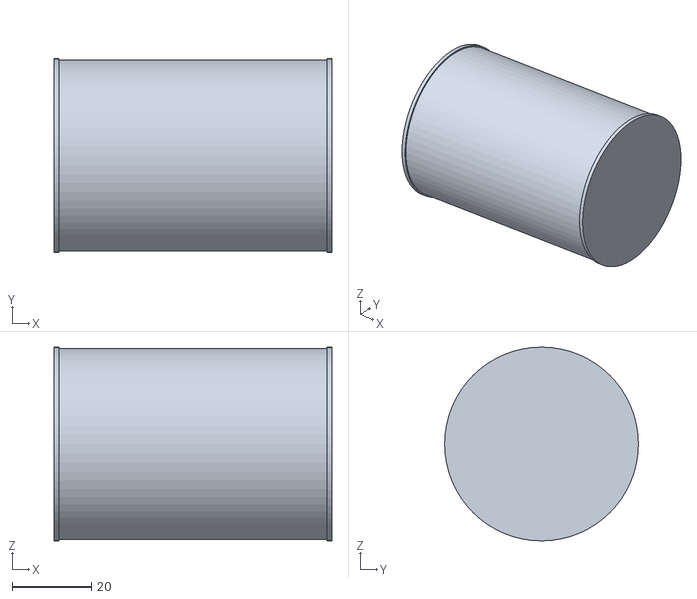
[picture p115: CAD file, 2026-10-12]
v11_три_варианта/REJECTED_C_опрокидывающаяся_люлька_НЕ_ПЕЧАТАТЬ/STL_СБОРКА_НЕ_ПЕЧАТАТЬ/C_EJECT_can_1.stl
70.0 x 48.8 x 48.8
