BZKDP/dozator-bad/(list of files, cad)

Other CAD files:
v11_три_варианта/B_роторная_кассета/STL_СБОРКА_НЕ_ПЕЧАТАТЬ/assembly_MID_with_3_cans.stl
v11_три_варианта/B_роторная_кассета/REJECTED_DIRECT_DRIVE/STL_СБОРКА_НЕ_ПЕЧАТАТЬ/assembly_MID_with_3_cans.stl
v11_три_варианта/B_роторная_кассета/STL_СБОРКА_НЕ_ПЕЧАТАТЬ/assembly_EJECT_with_3_cans.stl
v11_три_варианта/B_роторная_кассета/REJECTED_DIRECT_DRIVE/STL_СБОРКА_НЕ_ПЕЧАТАТЬ/assembly_EJECT_with_3_cans.stl
v11_три_варианта/REJECTED_C_опрокидывающаяся_люлька_НЕ_ПЕЧАТАТЬ/STL_СБОРКА_НЕ_ПЕЧАТАТЬ/C_TRANSFER_complete.stl
v11_три_варианта/C_верхние_линейные_ножи/STL_СБОРКА_НЕ_ПЕЧАТАТЬ/C2_HOME_complete.stl
v11_три_варианта/C_верхние_линейные_ножи/STL_СБОРКА_НЕ_ПЕЧАТАТЬ/C2_HOME_can_2.stl
v15_ручной_раскрой/reference_models_not_for_printing/lower.stl
v11_три_варианта/A_верхнее_коромысло/STL_ПЕЧАТЬ/A01_рама_верхнего_коромысла.stl
v11_три_варианта/B_роторная_кассета/REJECTED_DIRECT_DRIVE/STL_ПЕЧАТЬ/B02R_полурама_M4_клипса_A02.stl
v11_три_варианта/B_роторная_кассета/REJECTED_DIRECT_DRIVE/STL_СБОРКА_НЕ_ПЕЧАТАТЬ/MID/can_queue_2.stl
v11_три_варианта/B_роторная_кассета/STL_ПЕЧАТЬ/B02GL_левая_направляющая.stl
v11_три_варианта/B_роторная_кассета/STL_СБОРКА_НЕ_ПЕЧАТАТЬ/MID/divider_left.stl
v11_три_варианта/viewer_plate_assets/C/plate_01_part_05.stl
v13_открытая_кассета/3D_МОДЕЛИ/A03_НИЖНИЙ_ПОДДОН_МАКЕТ.stl
stl_gate12_MG996R_backup/plate_chassis.stl
v10_производственная_модель/STL_СБОРКА_НЕ_ПЕЧАТАТЬ/cassette_upper_sheet.stl
v11_три_варианта/00_ОБЩАЯ_КОМПОНОВКА/STL_КАССЕТА_СБОРКА/cassette_lower_sheet.stl
v11_три_варианта/A_верхнее_коромысло/STL_ПЕЧАТЬ/A04_нижний_прижим_ската.stl
v11_три_варианта/A_верхнее_коромысло/STL_СБОРКА_НЕ_ПЕЧАТАТЬ/A_VIEW_MID_can_3.stl
v11_три_варианта/B_роторная_кассета/STL_СБОРКА_НЕ_ПЕЧАТАТЬ/EJECT/lower_sheet_A02.stl
v11_три_варианта/B_роторная_кассета/STL_СБОРКА_НЕ_ПЕЧАТАТЬ/HOME/divider_right.stl
v11_три_варианта/C_верхние_линейные_ножи/STL_ПЕЧАТЬ/C04_коромысло_SG90_MG90S.stl
v11_три_варианта/viewer_plate_assets/A/plate_01_part_04.stl
v11_три_варианта/viewer_plate_assets/B/plate_04_part_02.stl
v11_три_варианта/viewer_plate_assets/C/plate_01_part_03.stl
v14_кассета_ПНД4/3D_МОДЕЛИ/A01_БОКОВАЯ_СТЕНКА_МАКЕТ.stl
v9_без_клея_переработка/_черновики/АРХИВ_черновик_качающийся_карман_ВЫДАЧА.stl
stl_gate12_SG90_backup/plate_chassis.stl
v11_три_варианта/B_роторная_кассета/REJECTED_DIRECT_DRIVE/STL_ПЕЧАТЬ/B02L_полурама_SG90_клипса_A02.stl
v11_три_варианта/B_роторная_кассета/STL_ПЕЧАТЬ/B03_гравитационная_собачка.stl
v11_три_варианта/B_роторная_кассета/STL_СБОРКА_НЕ_ПЕЧАТАТЬ/HOME/wire_red.stl
v11_три_варианта/B_роторная_кассета/STL_СБОРКА_НЕ_ПЕЧАТАТЬ/MID/can_indexed.stl
v11_три_варианта/viewer_plate_assets/A/plate_01_part_02.stl
v11_три_варианта/viewer_plate_assets/C/plate_01_part_01.stl
v14_кассета_ПНД4/3D_МОДЕЛИ/A02_ВНУТРЕННЯЯ_ПЕРЕГОРОДКА_МАКЕТ.stl
v15_ручной_раскрой/reference_models_not_for_printing/wall_3.stl
v11_три_варианта/B_роторная_кассета/REJECTED_DIRECT_DRIVE/STL_СБОРКА_НЕ_ПЕЧАТАТЬ/HOME/can_queue_2.stl
v11_три_варианта/B_роторная_кассета/REJECTED_DIRECT_DRIVE/STL_СБОРКА_НЕ_ПЕЧАТАТЬ/MID/wire_brown.stl
v11_три_варианта/C_верхние_линейные_ножи/STL_ПЕЧАТЬ/C03_задний_линейный_сепаратор.stl
v11_три_варианта/viewer_plate_assets/B/plate_01_part_02.stl
v11_три_варианта/viewer_plate_assets/C/plate_01_part_02.stl
v13_открытая_кассета/3D_МОДЕЛИ/A02_ВНУТРЕННЯЯ_ПЕРЕГОРОДКА_МАКЕТ.stl
v14_кассета_ПНД4/3D_МОДЕЛИ/V13_КАССЕТА_СБОРКА_ДЛЯ_ПРОСМОТРА.stl
stl_gate12/chassis.stl
stl_gate12/foot_x4.stl
stl_gate12/gear_m2_z24.stl
stl_gate12/plate_chassis.stl
stl_gate12/plate_feet_raft.stl
stl_gate12/plate_rest2.stl
stl_gate12/plate_small4.stl
stl_gate12_MG996R_backup/gear_m2_z24.stl
stl_gate12_MG996R_backup/plate_rest.stl
v10_производственная_модель/STL_ПЕЧАТЬ/A04U_замок_верхнего_ската_14град.stl
v10_производственная_модель/STL_ПЕЧАТЬ/B01_клин_балки_15град.stl
v10_производственная_модель/STL_ПЕЧАТЬ/M03_передняя_заслонка.stl
v10_производственная_модель/STL_ПЕЧАТЬ/M05_кулачок_SG90_MG90S.stl
v10_производственная_модель/STL_ПЕЧАТЬ/M07_ролик_толкателя.stl
v10_производственная_модель/STL_ПЕЧАТЬ/M08_входной_мост.stl
v10_производственная_модель/STL_ПЕЧАТЬ/M09_опорная_втулка_кулачка.stl
v10_производственная_модель/STL_ПЕЧАТЬ/T01_КУПОН_зазоры_направляющей.stl
v10_производственная_модель/STL_ПЕЧАТЬ/T02_КУПОН_карман_качалки.stl
v10_производственная_модель/STL_СБОРКА_НЕ_ПЕЧАТАТЬ/cam_cover.stl
v10_производственная_модель/STL_СБОРКА_НЕ_ПЕЧАТАТЬ/cam_home.stl
v10_производственная_модель/STL_СБОРКА_НЕ_ПЕЧАТАТЬ/cam_support_bushing.stl
v10_производственная_модель/STL_СБОРКА_НЕ_ПЕЧАТАТЬ/cassette_divider.stl
v10_производственная_модель/STL_СБОРКА_НЕ_ПЕЧАТАТЬ/cassette_lock_upper_14deg.stl
v10_производственная_модель/STL_СБОРКА_НЕ_ПЕЧАТАТЬ/drive_frame.stl
v10_производственная_модель/STL_СБОРКА_НЕ_ПЕЧАТАТЬ/follower_roller.stl
v10_производственная_модель/STL_СБОРКА_НЕ_ПЕЧАТАТЬ/follower_screw.stl
v10_производственная_модель/STL_СБОРКА_НЕ_ПЕЧАТАТЬ/input_bridge.stl
v10_производственная_модель/STL_СБОРКА_НЕ_ПЕЧАТАТЬ/m3_bridge_flathead_screws.stl
v10_производственная_модель/STL_СБОРКА_НЕ_ПЕЧАТАТЬ/m3_frame_flathead_screws.stl
v10_производственная_модель/STL_СБОРКА_НЕ_ПЕЧАТАТЬ/m4_tray_flathead_screws.stl
v10_производственная_модель/STL_СБОРКА_НЕ_ПЕЧАТАТЬ/one_lane_BOTH_CLOSED.stl
v10_производственная_модель/STL_СБОРКА_НЕ_ПЕЧАТАТЬ/one_lane_EJECT.stl
v10_производственная_модель/STL_СБОРКА_НЕ_ПЕЧАТАТЬ/one_lane_HOME.stl
v10_производственная_модель/STL_СБОРКА_НЕ_ПЕЧАТАТЬ/one_lane_HOME_with_3_cans.stl
v10_производственная_модель/STL_СБОРКА_НЕ_ПЕЧАТАТЬ/one_lane_REAR_CLOSED.stl
v10_производственная_модель/STL_СБОРКА_НЕ_ПЕЧАТАТЬ/rear_blade_ref.stl
v10_производственная_модель/STL_СБОРКА_НЕ_ПЕЧАТАТЬ/servo_body.stl
v10_производственная_модель/STL_СБОРКА_НЕ_ПЕЧАТАТЬ/servo_horn.stl
v10_производственная_модель/STL_СБОРКА_НЕ_ПЕЧАТАТЬ/servo_screw.stl
v10_производственная_модель/STL_СБОРКА_НЕ_ПЕЧАТАТЬ/servo_shaft.stl
v10_производственная_модель/STL_СБОРКА_НЕ_ПЕЧАТАТЬ/support_beam_2040.stl
v10_производственная_модель/STL_СБОРКА_НЕ_ПЕЧАТАТЬ/support_brackets_pair.stl
v10_производственная_модель/STL_СБОРКА_НЕ_ПЕЧАТАТЬ/support_wedges_pair.stl
v10_производственная_модель/STL_СБОРКА_НЕ_ПЕЧАТАТЬ/tray.stl
v11_три_варианта/00_ОБЩАЯ_КОМПОНОВКА/LEGACY_DO_NOT_USE/DRAFT_DO_NOT_USE_01_РАЗДЕЛИТЕЛЬ_V2_CNC_зазор_0.25_2отв_M4_4шт.dxf
v11_три_варианта/00_ОБЩАЯ_КОМПОНОВКА/LEGACY_DO_NOT_USE/DRAFT_DO_NOT_USE_01_РАЗДЕЛИТЕЛЬ_V2_РУЧНОЙ_зазор_0.45_2отв_M4_4шт.dxf
v11_три_варианта/00_ОБЩАЯ_КОМПОНОВКА/LEGACY_DO_NOT_USE/DRAFT_DO_NOT_USE_M4x16_болты_8шт_world_REFERENCE.stl
v11_три_варианта/00_ОБЩАЯ_КОМПОНОВКА/LEGACY_DO_NOT_USE/DRAFT_DO_NOT_USE_cassette_divider_v2_with_2_M4_holes.stl
v11_три_варианта/00_ОБЩАЯ_КОМПОНОВКА/LEGACY_DO_NOT_USE/DRAFT_DO_NOT_USE_cassette_xlock_lower_15deg_v2_PRINT.stl
v11_три_варианта/00_ОБЩАЯ_КОМПОНОВКА/LEGACY_DO_NOT_USE/DRAFT_DO_NOT_USE_cassette_xlock_upper_14deg_v2_PRINT.stl
v11_три_варианта/00_ОБЩАЯ_КОМПОНОВКА/LEGACY_DO_NOT_USE/DRAFT_DO_NOT_USE_cassette_xlocks_lower_4_world_v2.stl
v11_три_варианта/00_ОБЩАЯ_КОМПОНОВКА/LEGACY_DO_NOT_USE/DRAFT_DO_NOT_USE_cassette_xlocks_upper_4_world_v2.stl
v11_три_варианта/00_ОБЩАЯ_КОМПОНОВКА/LEGACY_DO_NOT_USE/DRAFT_DO_NOT_USE_фиксатор_нижнего_ската_15град_V11_PRINT.stl
v11_три_варианта/00_ОБЩАЯ_КОМПОНОВКА/LEGACY_DO_NOT_USE/cassette_lock_lower_15deg.stl
v11_три_варианта/00_ОБЩАЯ_КОМПОНОВКА/LEGACY_DO_NOT_USE/cassette_lower_sheet.stl
v11_три_варианта/00_ОБЩАЯ_КОМПОНОВКА/STL_ЗАМКИ_СБОРКА/M4_гайки_Nyloc_8шт_world_REFERENCE.stl
v11_три_варианта/00_ОБЩАЯ_КОМПОНОВКА/STL_ЗАМКИ_СБОРКА/M4x25_болты_8шт_world_REFERENCE.stl
v11_три_варианта/00_ОБЩАЯ_КОМПОНОВКА/STL_ЗАМКИ_СБОРКА/фиксаторы_верхнего_ската_4шт_world_V11.stl
v11_три_варианта/A_верхнее_коромысло/STL_СБОРКА_НЕ_ПЕЧАТАТЬ/A_5_КАНАЛОВ_HOME.stl
v11_три_варианта/A_верхнее_коромысло/STL_СБОРКА_НЕ_ПЕЧАТАТЬ/A_VIEW_EJECT_can_1.stl
v11_три_варианта/A_верхнее_коромысло/STL_СБОРКА_НЕ_ПЕЧАТАТЬ/A_VIEW_EJECT_can_2.stl
v11_три_варианта/A_верхнее_коромысло/STL_СБОРКА_НЕ_ПЕЧАТАТЬ/A_VIEW_EJECT_can_3.stl
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
