BZKDP/dozator-bad/stl_gate12/_verify_mg996r.png

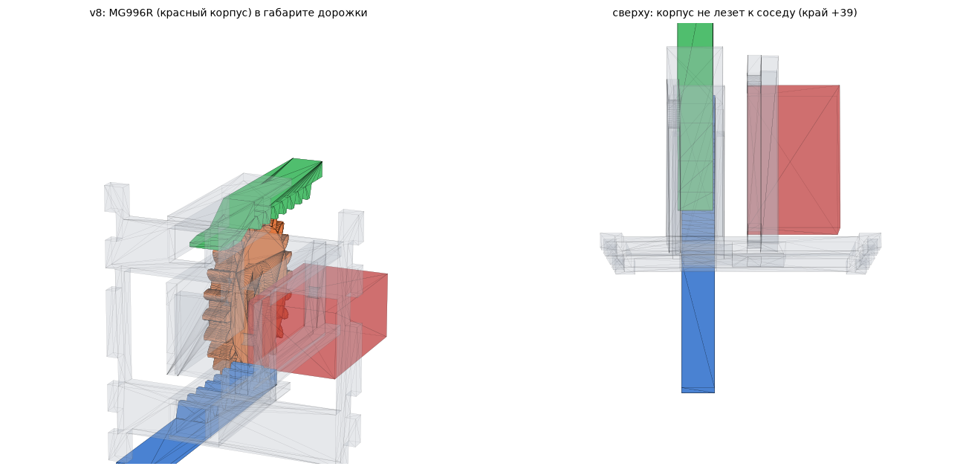
stl_gate12/_verify_mg996r.png
