BZKDP/dozator-bad/stl_gate12/_verify_weights.png

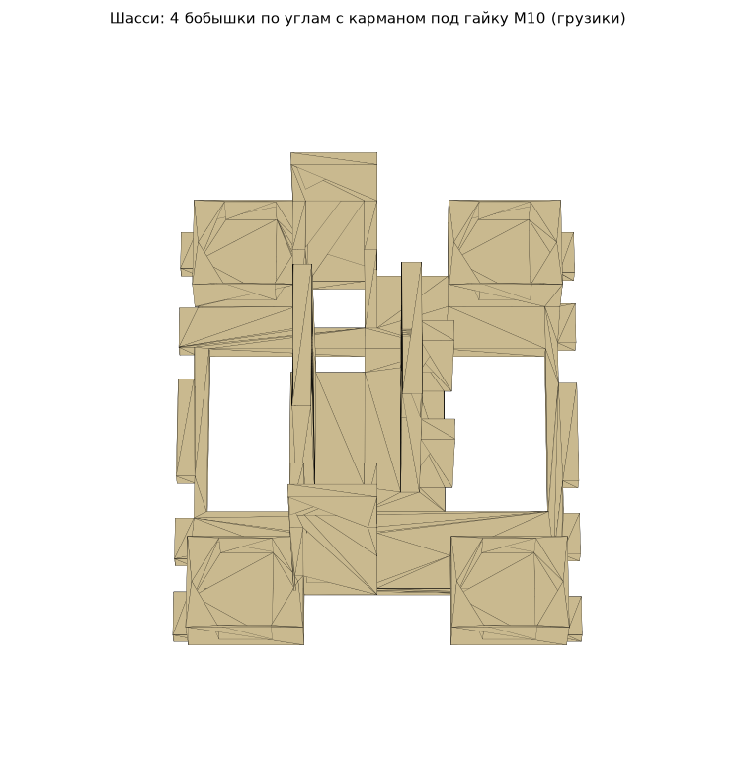
stl_gate12/_verify_weights.png
