BZKDP/dozator-bad/stl_gate12_MG996R_backup/_verify_horn.png

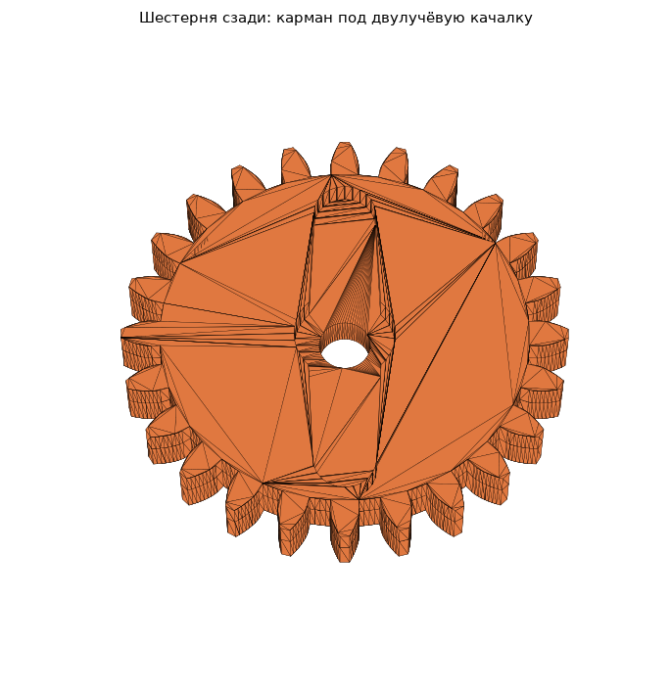
stl_gate12_MG996R_backup/_verify_horn.png
