BZKDP/dozator-bad/v11_три_варианта/_qa_C_HOME.png

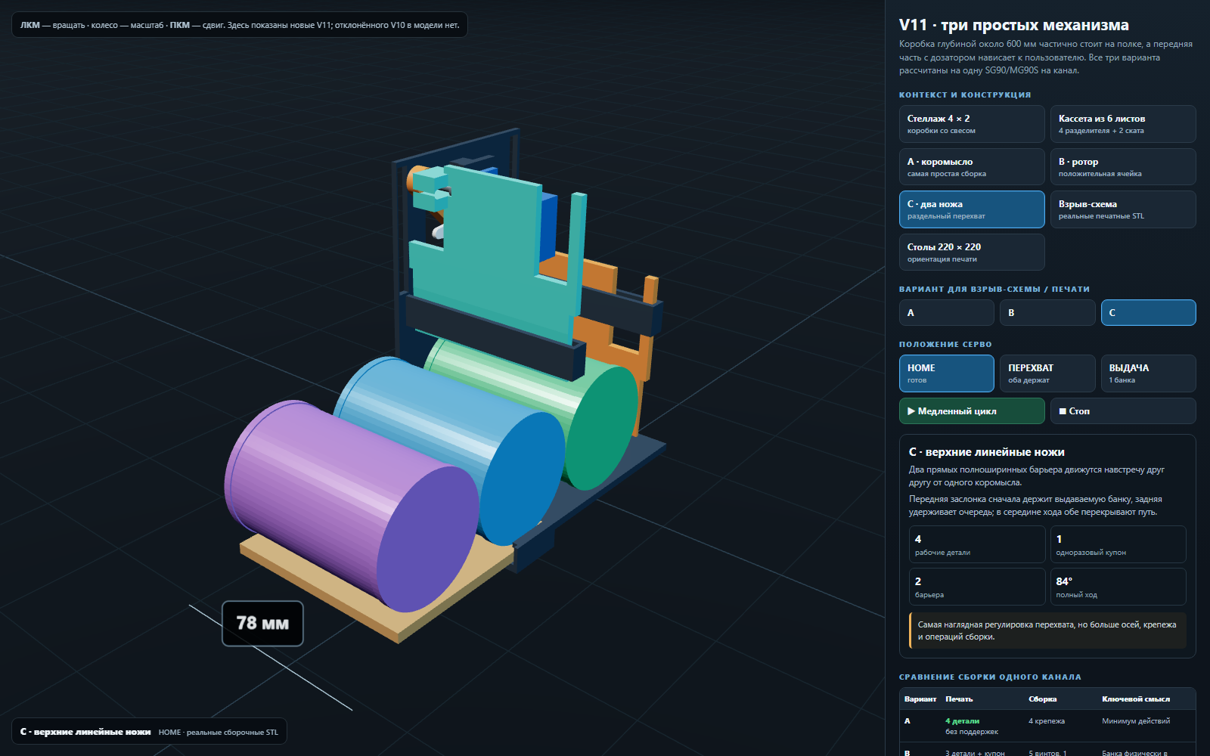
v11_три_варианта/_qa_C_HOME.png
