BZKDP/dozator-bad/v11_три_варианта/_qa_cassette2.png

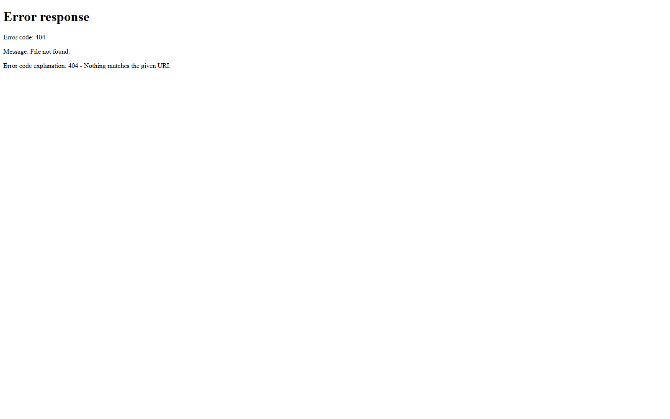
v11_три_варианта/_qa_cassette2.png
