BZKDP/dozator-bad/v11_три_варианта/_qa_cassette.png

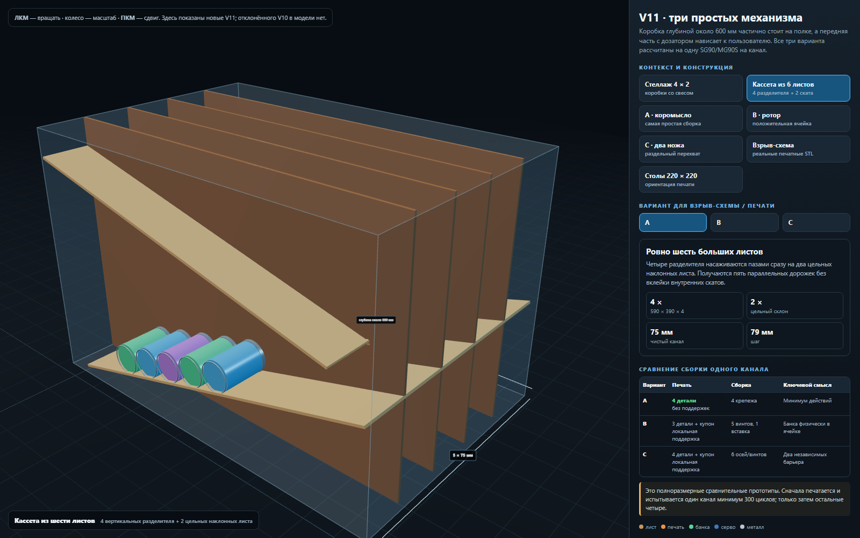
v11_три_варианта/_qa_cassette.png
