BZKDP/dozator-bad/v11_три_варианта/_qa_rack.png

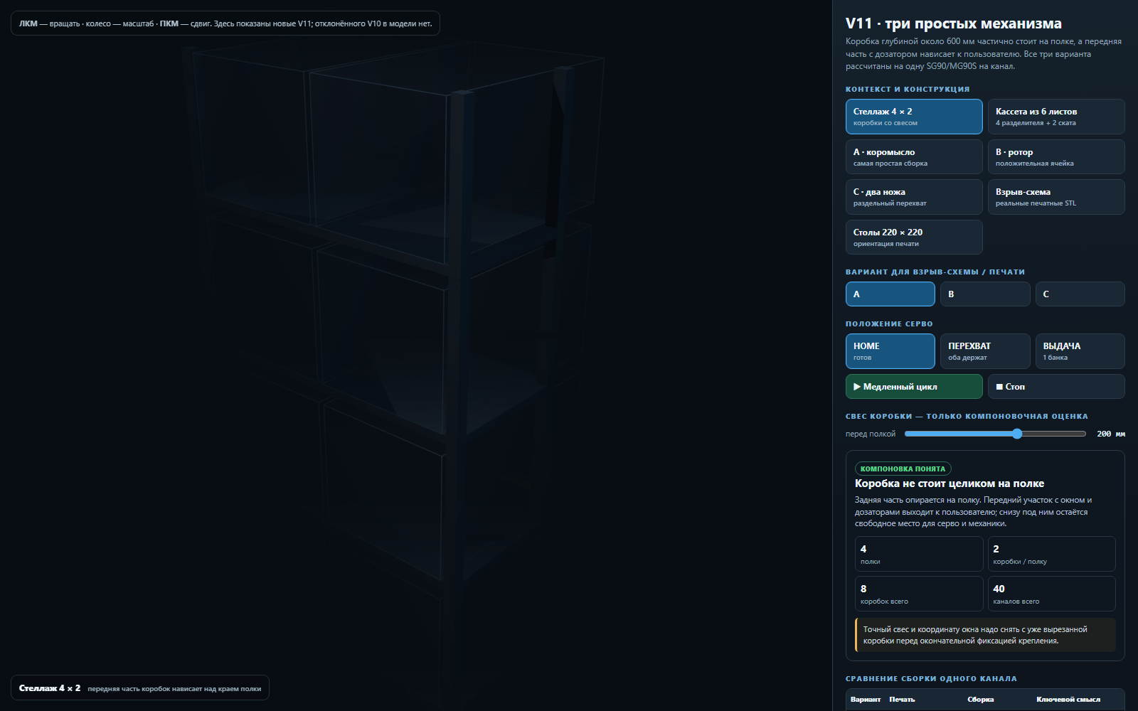
v11_три_варианта/_qa_rack.png
