BZKDP/dozator-bad/stl_gate12_SG90_backup/_verify_fix.png

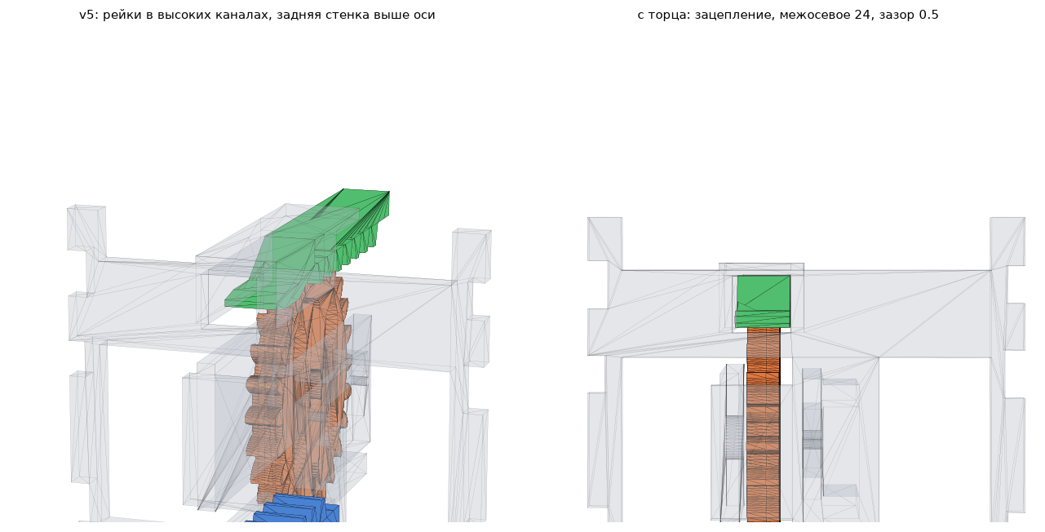
stl_gate12_SG90_backup/_verify_fix.png
